Kreyl/Libs/Kicad/3d/Batteries/CR2032 holder.step

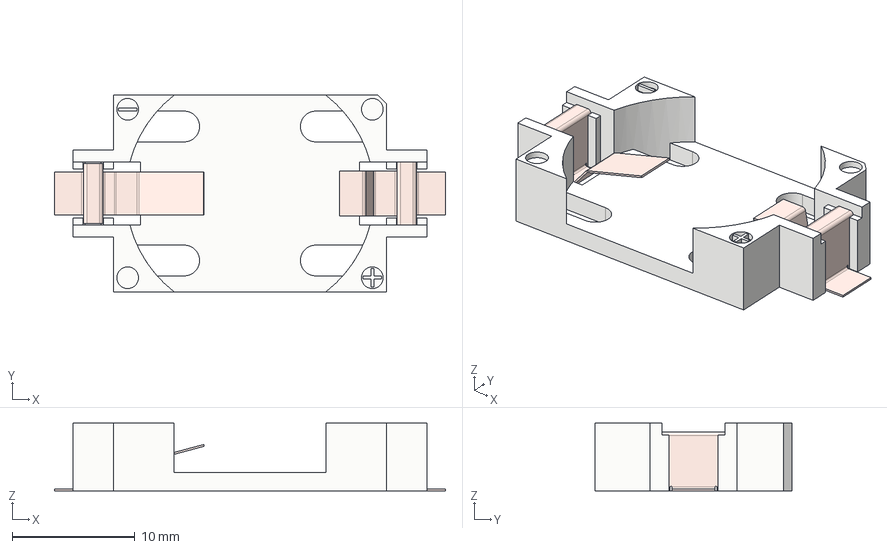
[picture p1: CAD file, 2018-12-30]
Kicad/3d/Batteries/CR2032 holder.step
31.8 x 16.0 x 5.50 mm
base
connector_plus
connector_minus
