Kreyl/Libs/Kicad/3d/BGA/153BallWFBGA.step

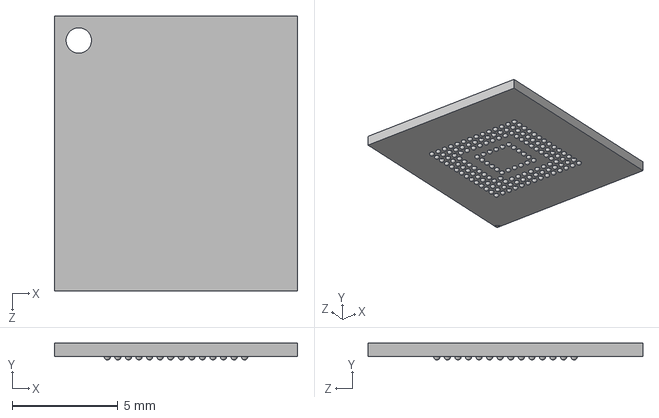
[picture p2: CAD file, 2021-06-26]
Kicad/3d/BGA/153BallWFBGA.step
11.5 x 0.802 x 13.0 mm
