Kreyl/Libs/Kicad/3d/BtnsSwitches/ESP2010.STEP

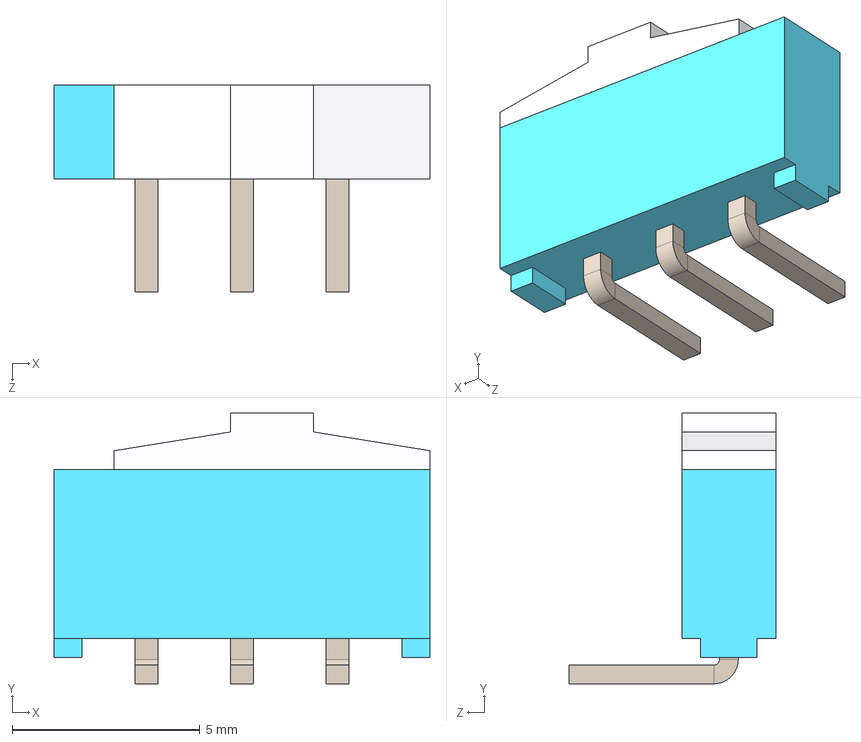
[picture p3: CAD file, 2024-11-15]
Kicad/3d/BtnsSwitches/ESP2010.STEP
10.0 x 7.20 x 5.50 mm
