Kreyl/Libs/Kicad/3d/Capacitors/CAPSMD_D8H10.STEP

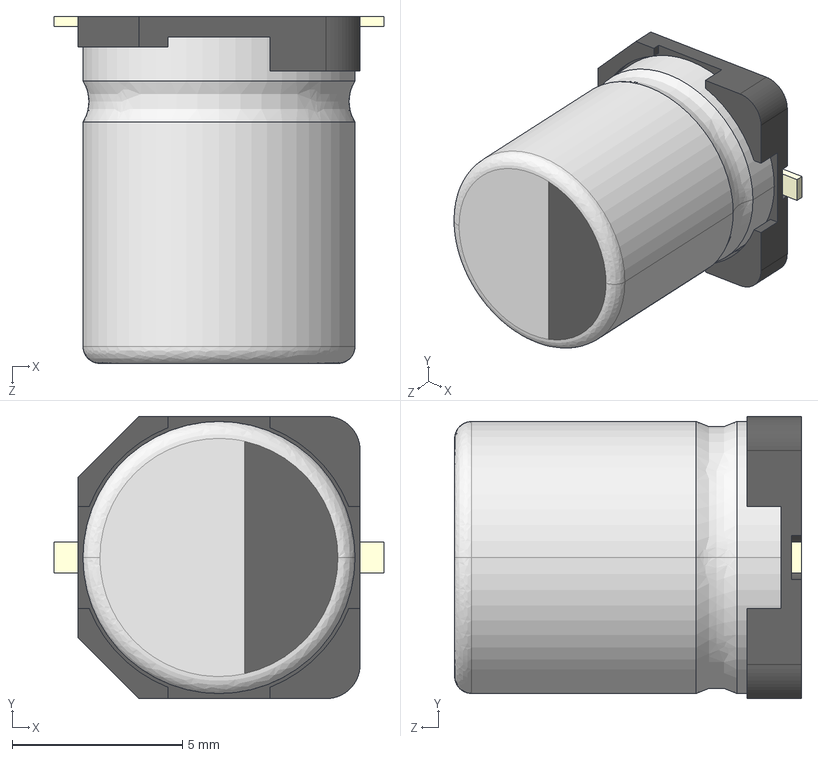
[picture p4: CAD file, 2024-05-12]
Kicad/3d/Capacitors/CAPSMD_D8H10.STEP
9.70 x 8.30 x 10.2 mm
