Kreyl/Libs/Kicad/3d/Connectors/IDC/DS1013-10S (IDC-10MS CONNFLY).step

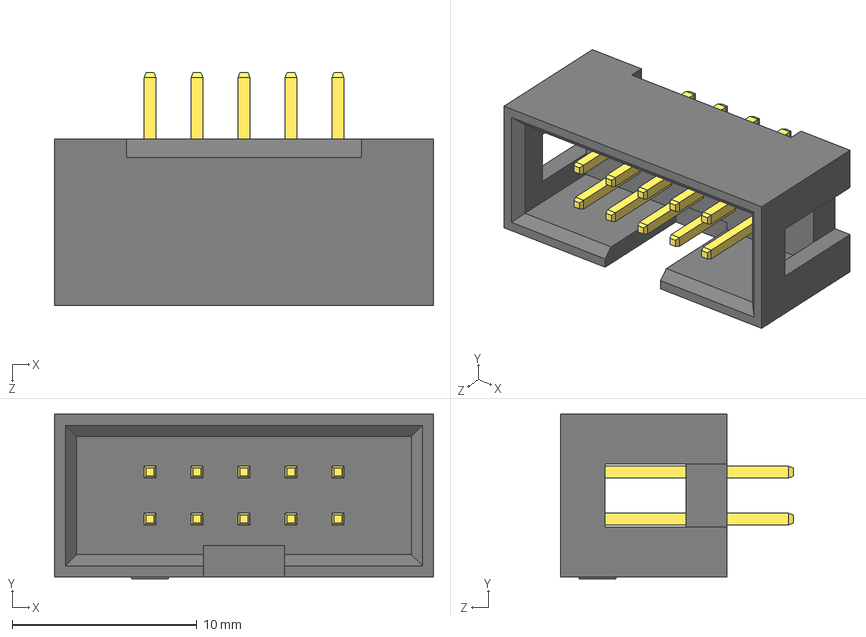
[picture p5: CAD file, 2019-09-05]
Kicad/3d/Connectors/IDC/DS1013-10S (IDC-10MS CONNFLY).step
20.5 x 8.90 x 12.6 mm
