Kreyl/Libs/Kicad/3d/Connectors/Minifit_6R.STEP

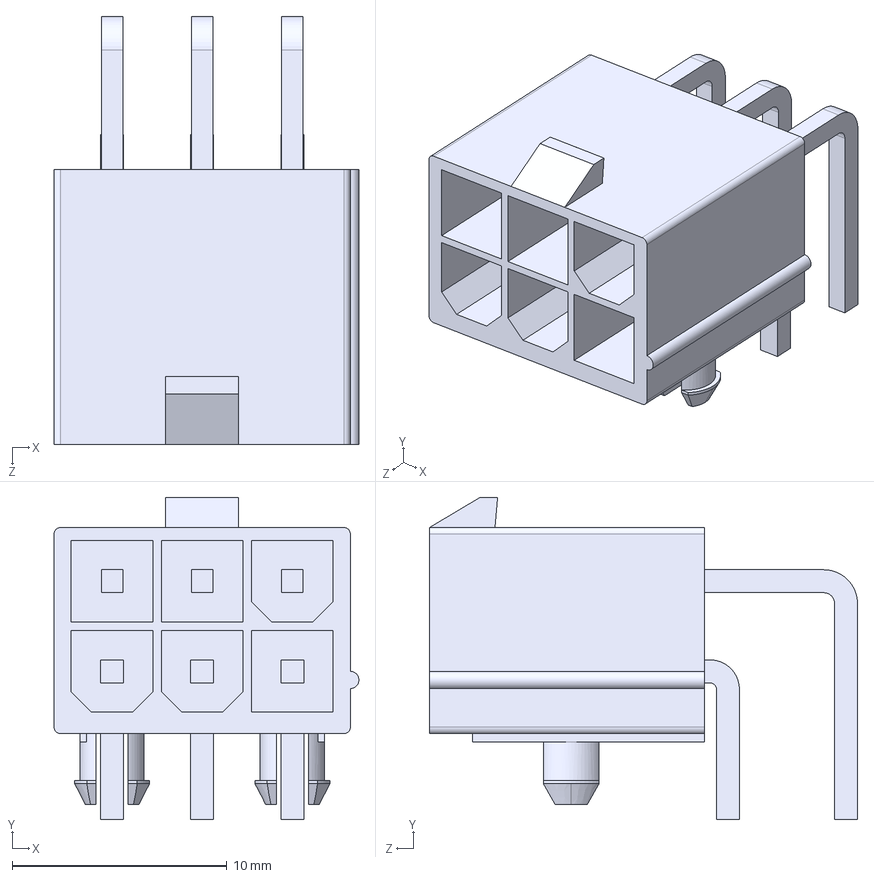
[picture p6: CAD file, 2025-05-01]
Kicad/3d/Connectors/Minifit_6R.STEP
14.2 x 15.0 x 19.9 mm
