Kreyl/Libs/Kicad/3d/Connectors/TermBlock/TermBlock_x2_Vert_508.STEP

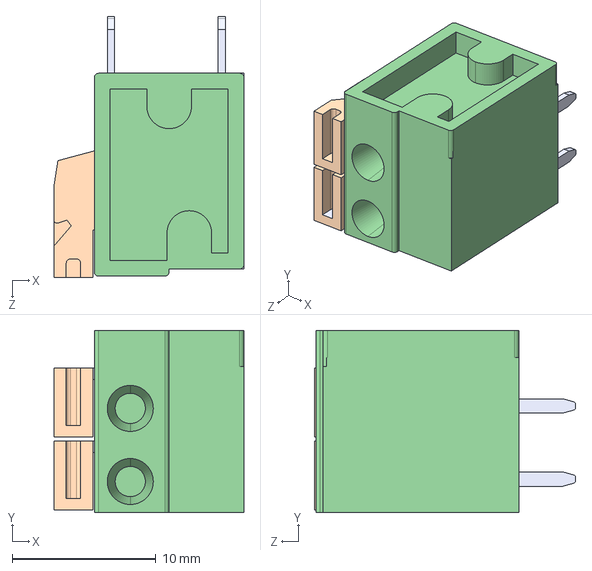
[picture p7: CAD file, 2020-02-28]
Kicad/3d/Connectors/TermBlock/TermBlock_x2_Vert_508.STEP
13.2 x 12.7 x 18.2 mm
