Kreyl/Libs/Kicad/3d/Diodes/PowerDI5.STEP

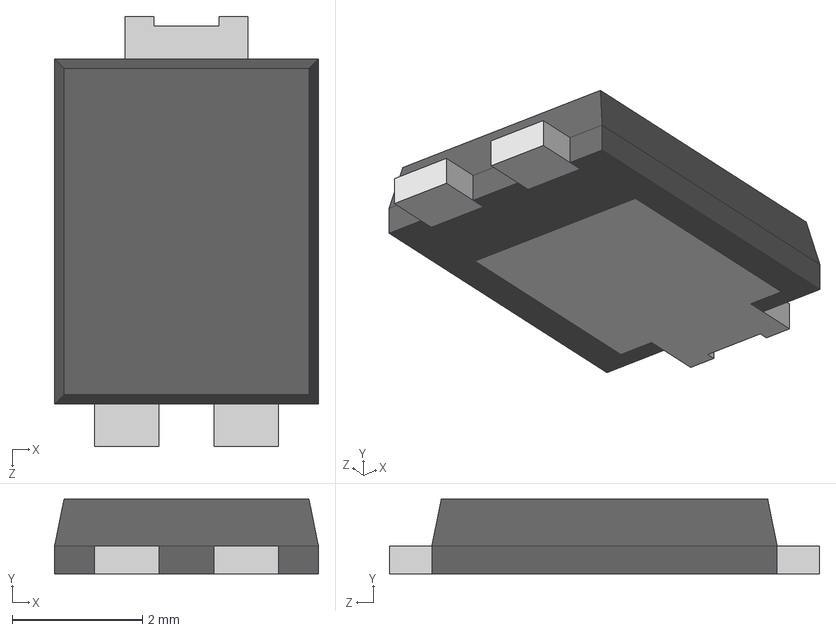
[picture p8: CAD file, 2021-07-17]
Kicad/3d/Diodes/PowerDI5.STEP
4.05 x 1.15 x 6.60 mm
