Kreyl/Libs/Kicad/3d/DIP/DIP16.STEP

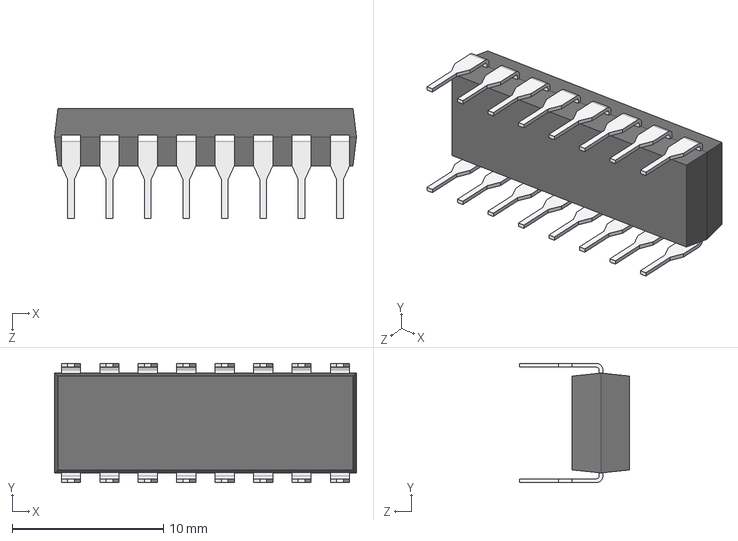
[picture p9: CAD file, 2018-04-20]
Kicad/3d/DIP/DIP16.STEP
20.0 x 7.87 x 7.30 mm
