Kreyl/Libs/Kicad/3d/Display/King Bright CA56-11.step

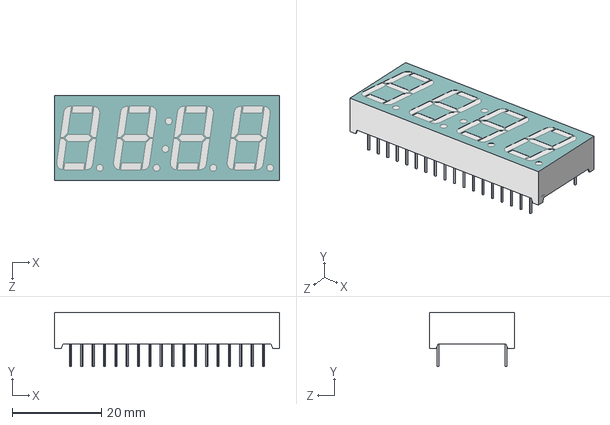
[picture p10: CAD file, 2019-11-08]
Kicad/3d/Display/King Bright CA56-11.step
50.3 x 12.1 x 19.0 mm
