Kreyl/Libs/Kicad/3d/Inductors/L0605.step

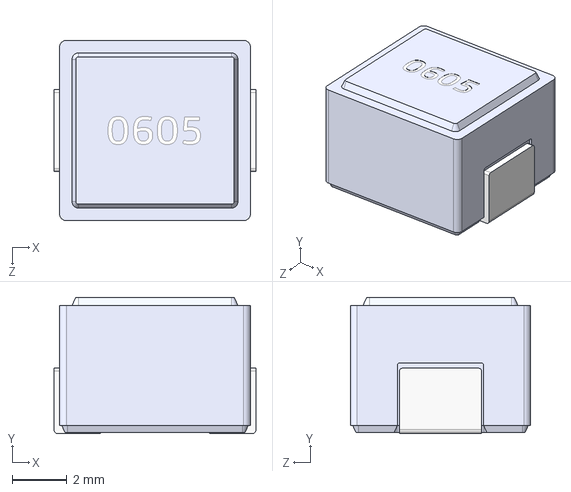
[picture p11: CAD file, 2025-05-01]
Kicad/3d/Inductors/L0605.step
7.40 x 5.00 x 6.60 mm
