Kreyl/Libs/Kicad/3d/Installation/CardInFix.STEP

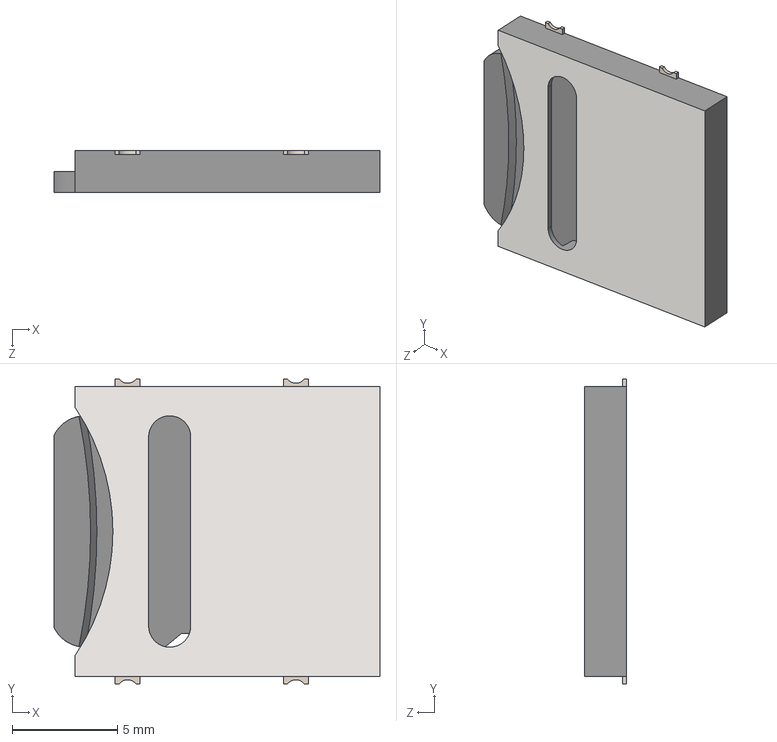
[picture p12: CAD file, 2024-11-16]
Kicad/3d/Installation/CardInFix.STEP
15.5 x 14.5 x 2.00 mm
SD holder fix
microsd card
