Kreyl/Libs/Kicad/3d/LED/LED2835_h08.STEP

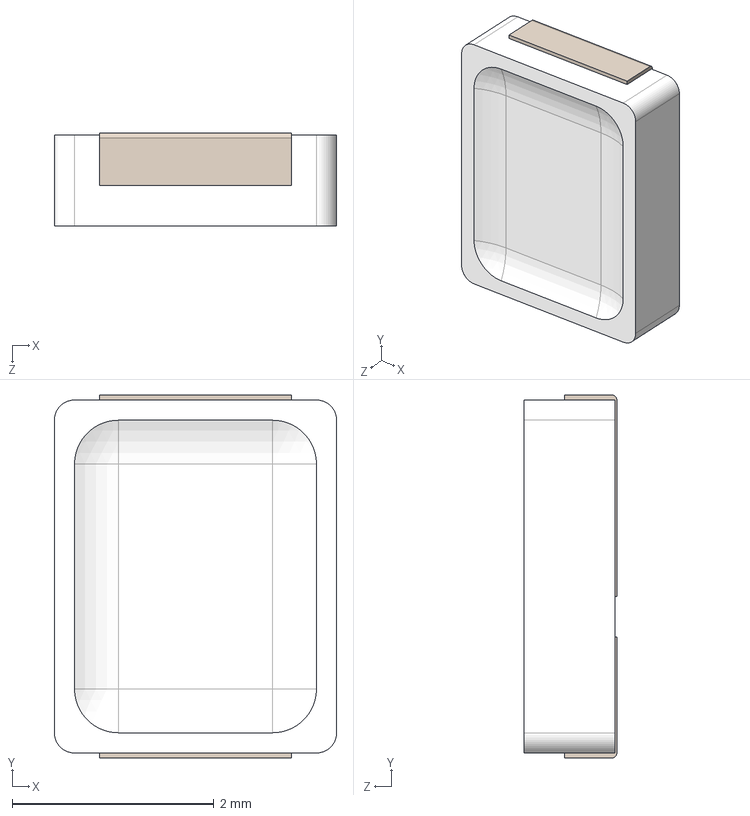
[picture p13: CAD file, 2023-07-15]
Kicad/3d/LED/LED2835_h08.STEP
2.80 x 3.60 x 0.92 mm
