Kreyl/Libs/Kicad/3d/LGA/LGA12-2x2x0_9.step

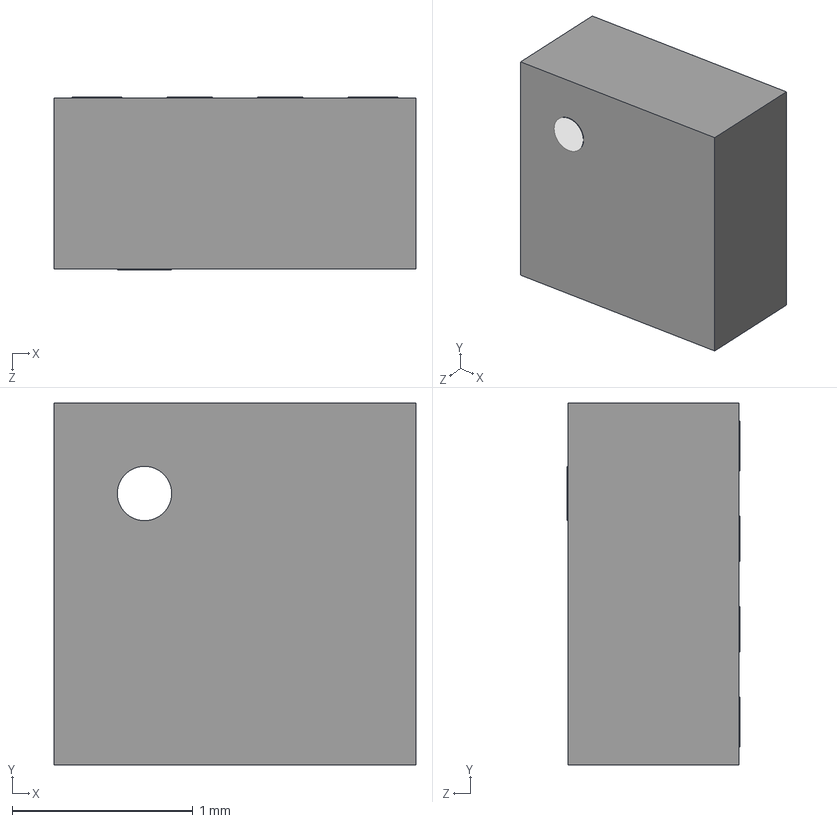
[picture p14: CAD file, 2024-11-16]
Kicad/3d/LGA/LGA12-2x2x0_9.step
2.00 x 2.00 x 0.955 mm
