Kreyl/Libs/Kicad/3d/Microphones/SPM211.STEP

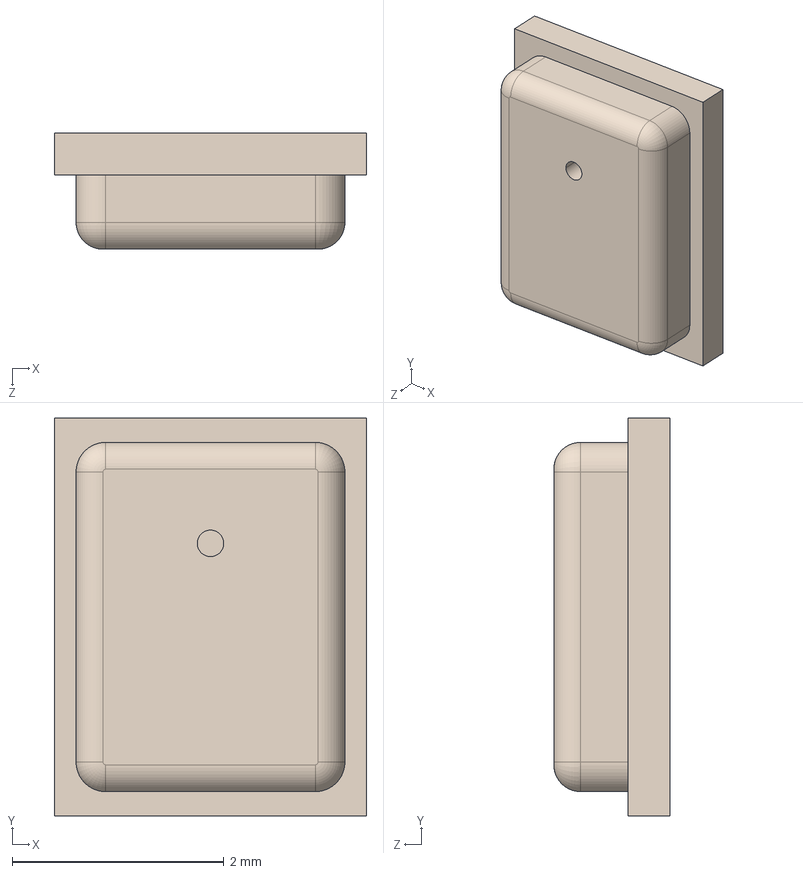
[picture p15: CAD file, 2020-12-03]
Kicad/3d/Microphones/SPM211.STEP
2.95 x 3.76 x 1.10 mm
