Kreyl/Libs/Kicad/3d/Modules/JDY-31.stp

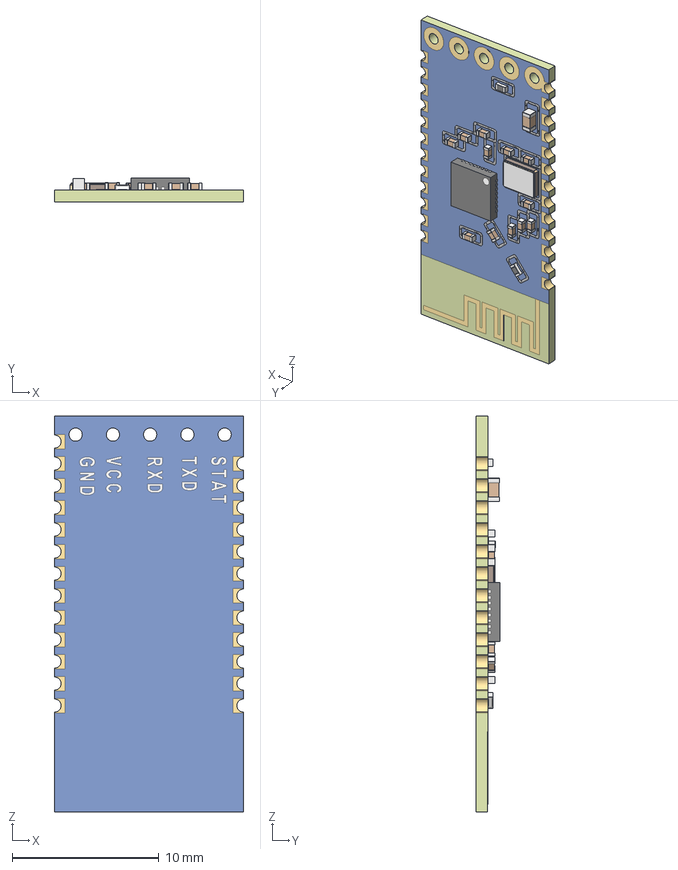
[picture p16: CAD file, 2024-11-07]
Kicad/3d/Modules/JDY-31.stp
12.9 x 1.66 x 27.0 mm
3D.000.000.000
CNC.000.000.000
