Kreyl/Libs/Kicad/3d/PCB/Testpoint1d5.STEP

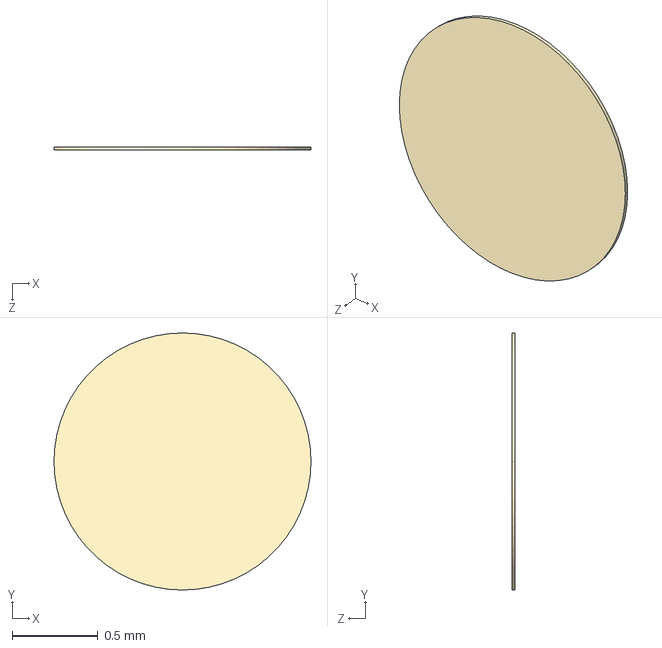
[picture p17: CAD file, 2020-05-17]
Kicad/3d/PCB/Testpoint1d5.STEP
1.50 x 1.50 x 0.02 mm
