Kreyl/Libs/Kicad/3d/QFN_DFN/POWERPAK 1212-8SWLH.STEP

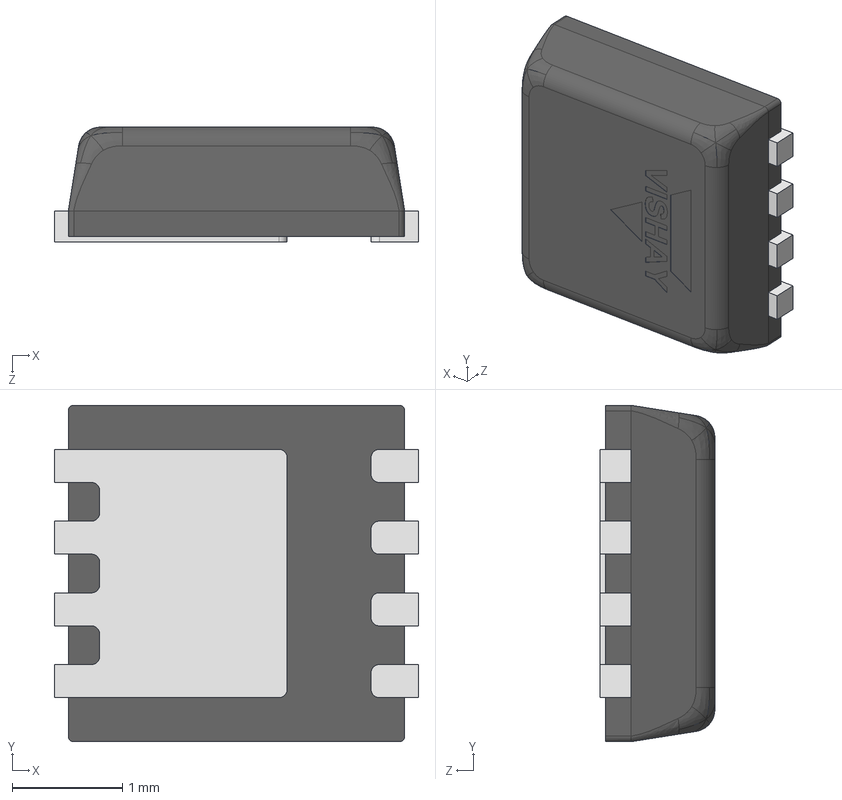
[picture p18: CAD file, 2021-06-26]
Kicad/3d/QFN_DFN/POWERPAK 1212-8SWLH.STEP
3.30 x 3.05 x 1.04 mm
Boss-Extrude2
Boss-Extrude3
Boss-Extrude6
Boss-Extrude5
Imported3
