Kreyl/Libs/Kicad/3d/QFP/LQFP-100.stp

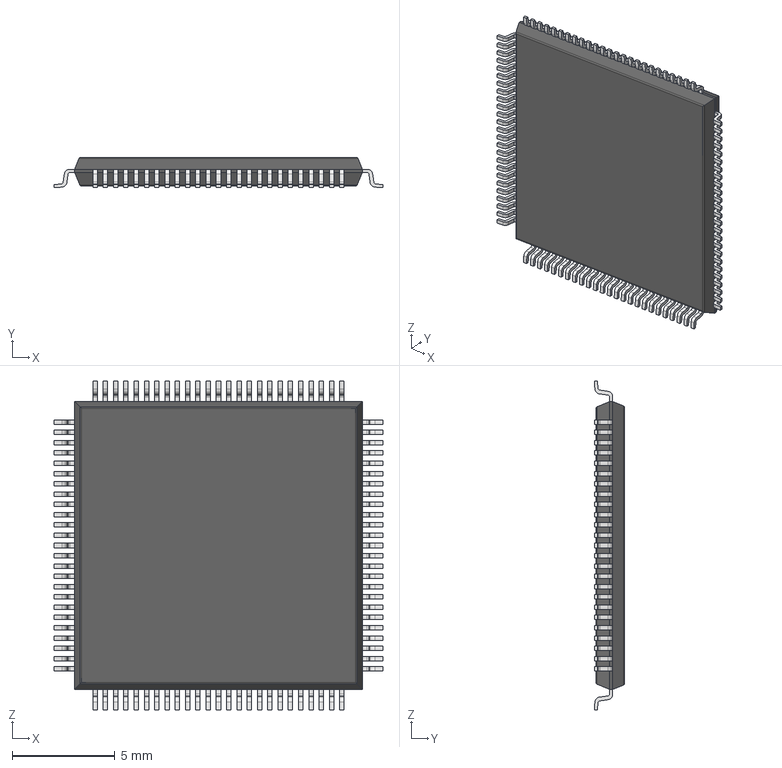
[picture p19: CAD file, 2024-11-15]
Kicad/3d/QFP/LQFP-100.stp
16.0 x 1.48 x 16.0 mm
