Kreyl/Libs/Kicad/3d/Quartz/HC49_US.step

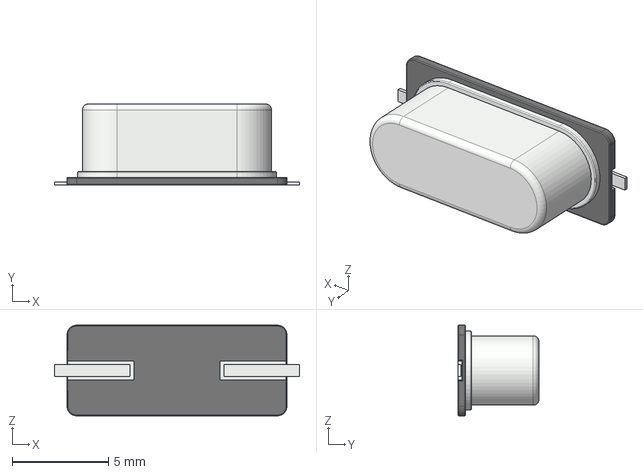
[picture p20: CAD file, 2018-02-26]
Kicad/3d/Quartz/HC49_US.step
12.7 x 4.20 x 4.70 mm
