Kreyl/Libs/Kicad/3d/Resistors/R_2512.step

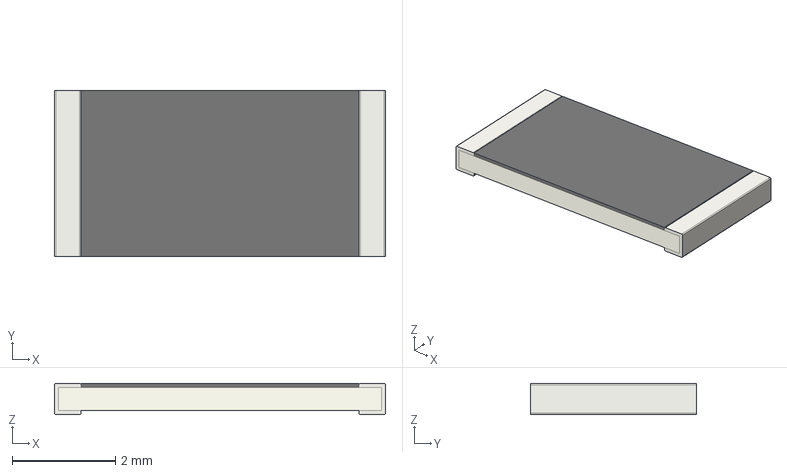
[picture p21: CAD file, 2018-02-26]
Kicad/3d/Resistors/R_2512.step
6.40 x 3.20 x 0.6 mm
