Kreyl/Libs/Kicad/3d/SO_DIL_TSSOP/SO8_208mil.step

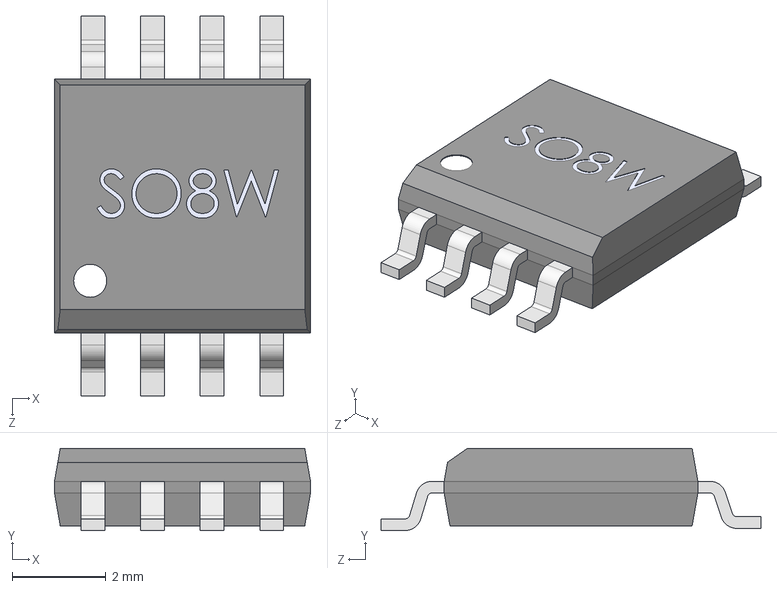
[picture p22: CAD file, 2023-10-30]
Kicad/3d/SO_DIL_TSSOP/SO8_208mil.step
5.46 x 1.75 x 8.10 mm
