Kreyl/Libs/Kicad/3d/SOT/SC-70_SOT-363.stp

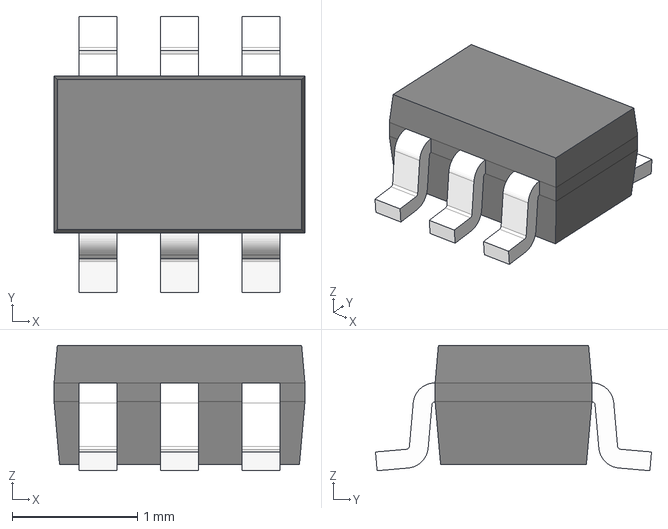
[picture p23: CAD file, 2024-11-16]
Kicad/3d/SOT/SC-70_SOT-363.stp
2.00 x 2.20 x 1.00 mm
