Kreyl/Libs/Kicad/3d/Batteries/BatHolder 3xAA.STEP

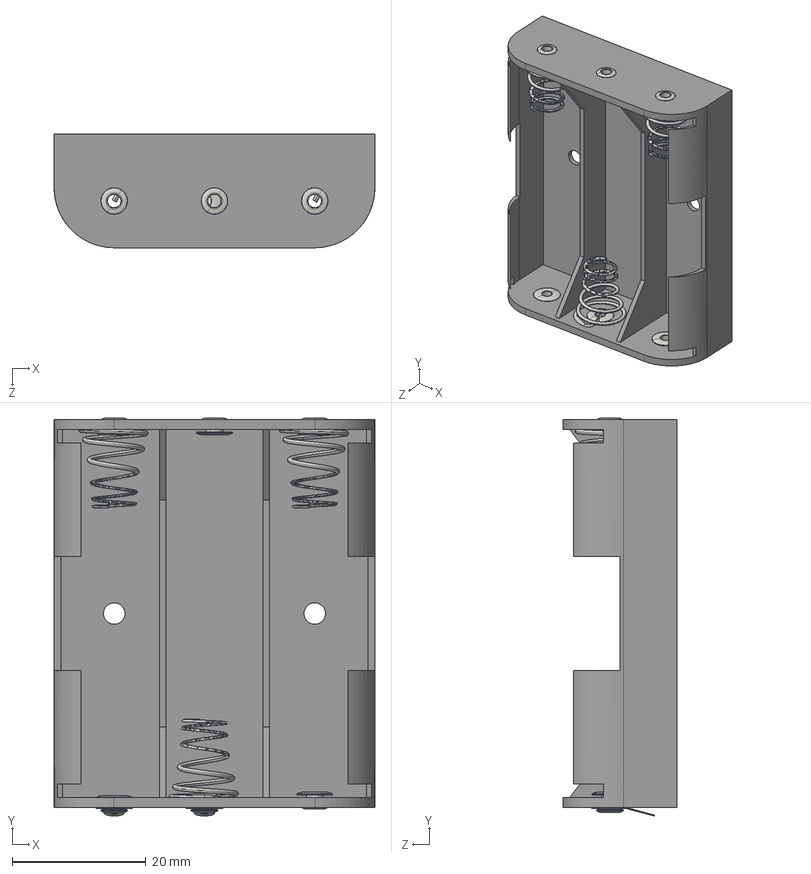
[picture p24: CAD file, 2018-12-12]
Kicad/3d/Batteries/BatHolder 3xAA.STEP
48.0 x 59.5 x 17.0 mm
BatteryHolder 3xAA Case
