Kreyl/Libs/Kicad/3d/BGA/BGA15x15.STEP

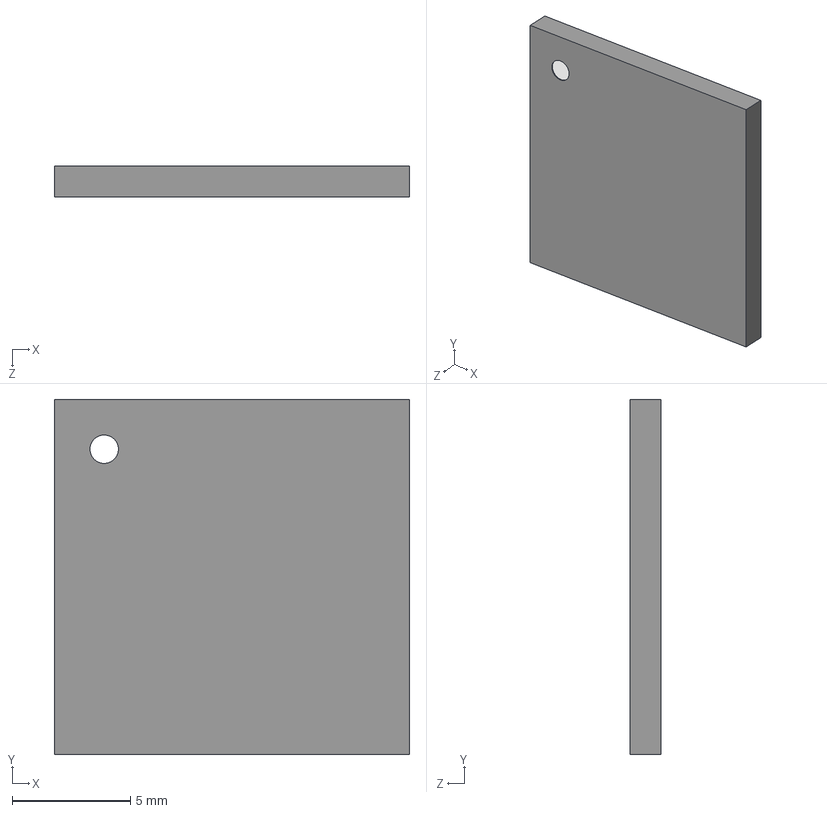
[picture p25: CAD file, 2020-09-16]
Kicad/3d/BGA/BGA15x15.STEP
15.0 x 15.0 x 1.30 mm
