Kreyl/Libs/Kicad/3d/BtnsSwitches/Btn 3x4.STEP

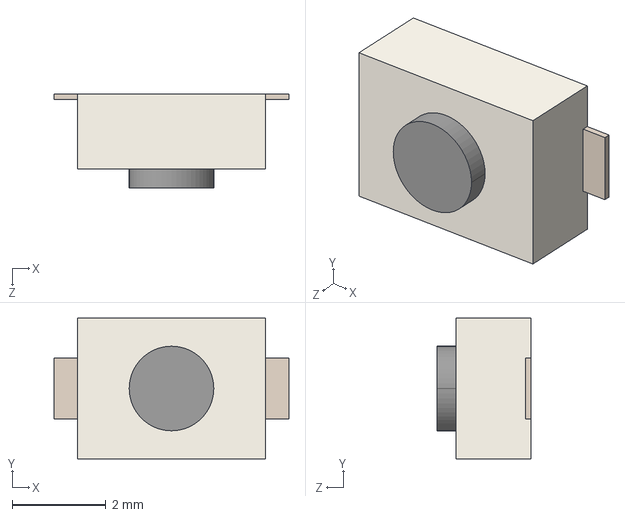
[picture p26: CAD file, 2024-08-31]
Kicad/3d/BtnsSwitches/Btn 3x4.STEP
5.00 x 3.00 x 2.00 mm
