Kreyl/Libs/Kicad/3d/Capacitors/CAPSMD470-6.3.stp

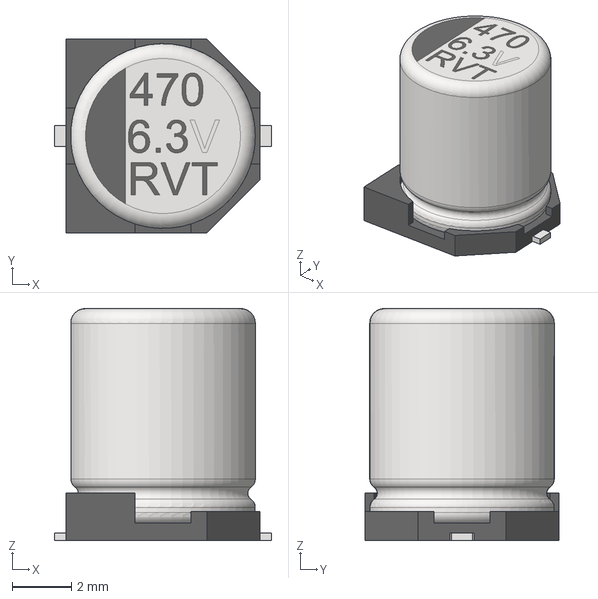
[picture p27: CAD file, 2019-02-19]
Kicad/3d/Capacitors/CAPSMD470-6.3.stp
7.35 x 6.57 x 7.85 mm
