Kreyl/Libs/Kicad/3d/Connectors/IDC/DS1013-30S (IDC-30MS CONNFLY).step

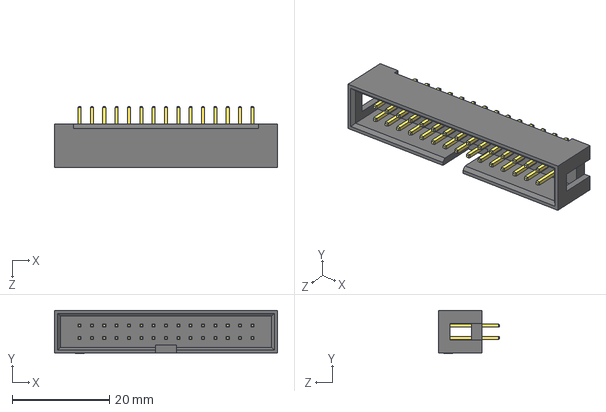
[picture p28: CAD file, 2019-01-16]
Kicad/3d/Connectors/IDC/DS1013-30S (IDC-30MS CONNFLY).step
45.9 x 8.90 x 12.6 mm
