Kreyl/Libs/Kicad/3d/Connectors/KLS1-3.96A-02-S.STEP

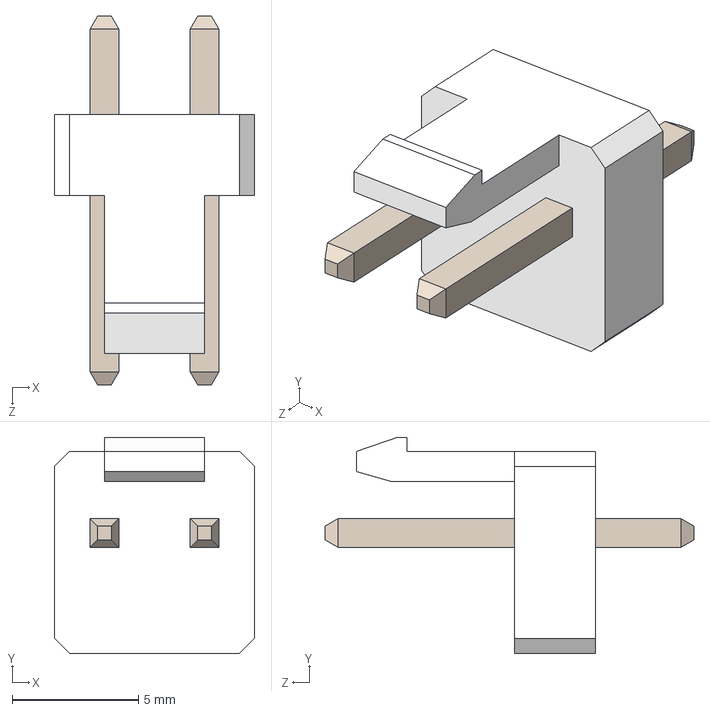
[picture p29: CAD file, 2024-11-16]
Kicad/3d/Connectors/KLS1-3.96A-02-S.STEP
7.92 x 8.55 x 14.6 mm
