Kreyl/Libs/Kicad/3d/Connectors/TermBlock/2way_5mm_R.stp

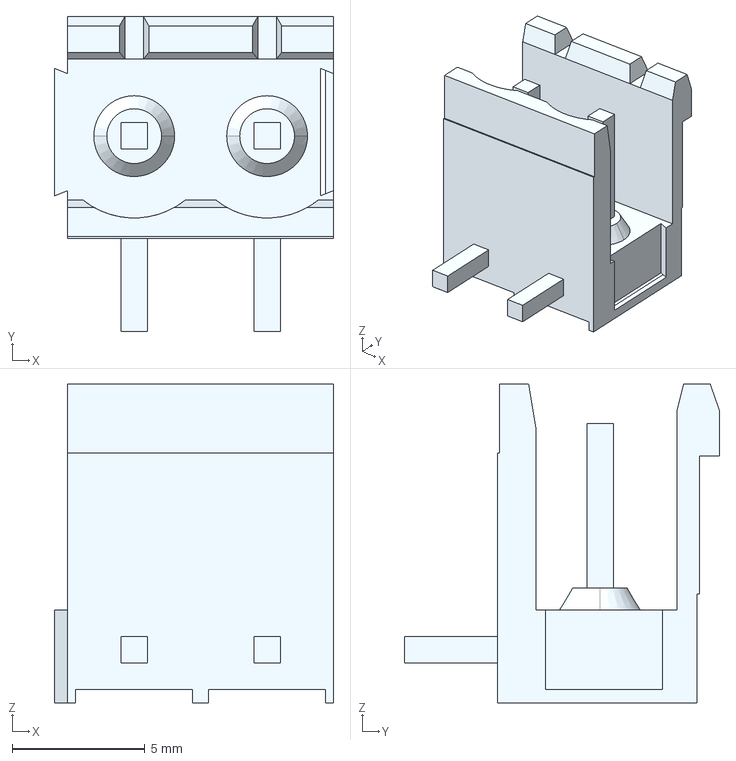
[picture p30: CAD file, 2019-11-08]
Kicad/3d/Connectors/TermBlock/2way_5mm_R.stp
10.5 x 11.8 x 12.0 mm
