Kreyl/Libs/Kicad/3d/Diodes/DFN1006_2L.STEP

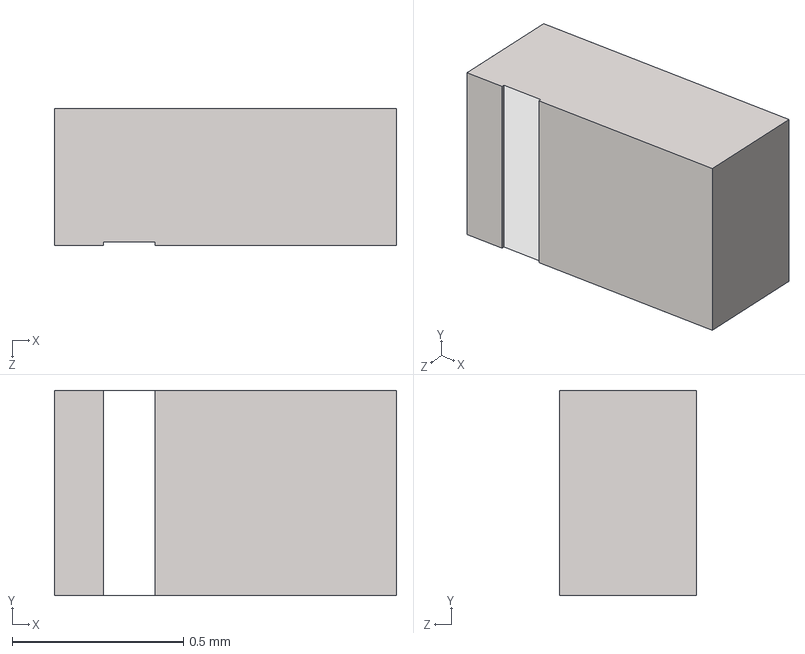
[picture p31: CAD file, 2020-02-28]
Kicad/3d/Diodes/DFN1006_2L.STEP
1.00 x 0.6 x 0.4 mm
