Kreyl/Libs/Kicad/3d/DIP/DIP4.STEP

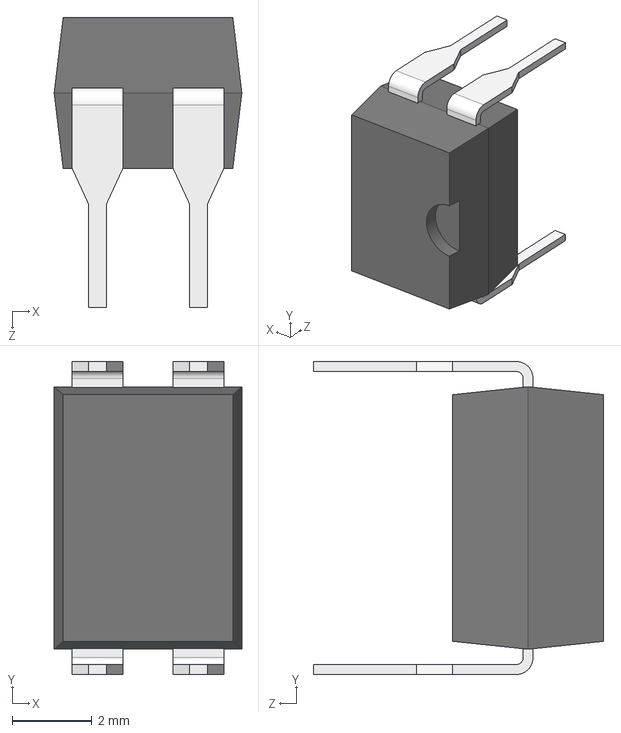
[picture p32: CAD file, 2018-04-20]
Kicad/3d/DIP/DIP4.STEP
4.72 x 7.87 x 7.30 mm
