Kreyl/Libs/Kicad/3d/Inductors/L_SPM6530.STEP

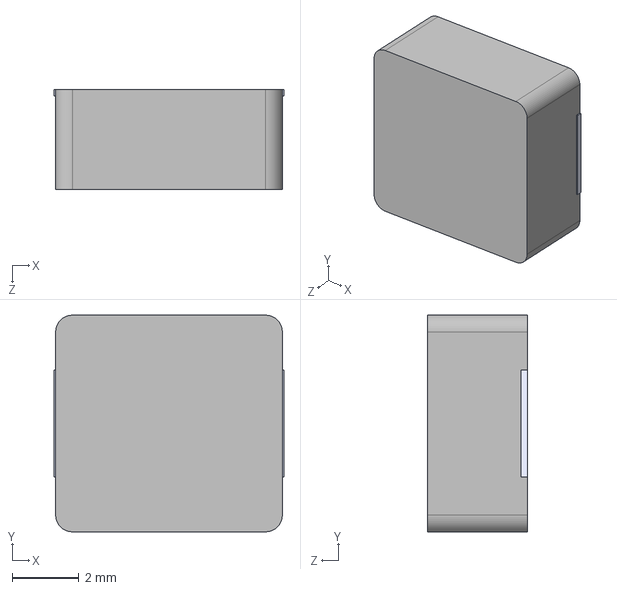
[picture p33: CAD file, 2025-05-01]
Kicad/3d/Inductors/L_SPM6530.STEP
6.90 x 6.50 x 3.00 mm
