Kreyl/Libs/Kicad/3d/Installation/BuzzerIPhone8.STEP

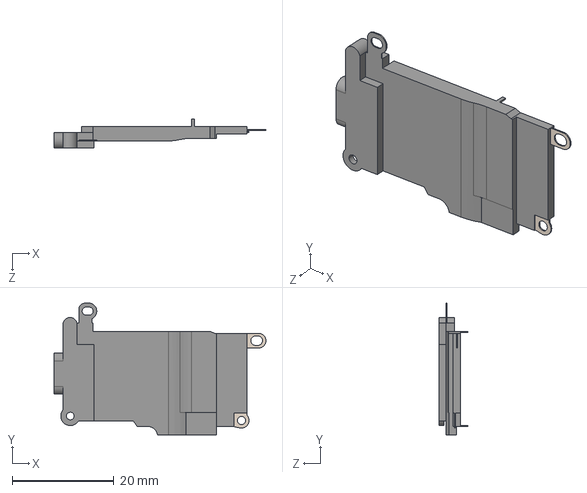
[picture p34: CAD file, 2024-11-15]
Kicad/3d/Installation/BuzzerIPhone8.STEP
41.6 x 25.8 x 5.70 mm
