Kreyl/Libs/Kicad/3d/LED/OT-15RGBWY.STEP

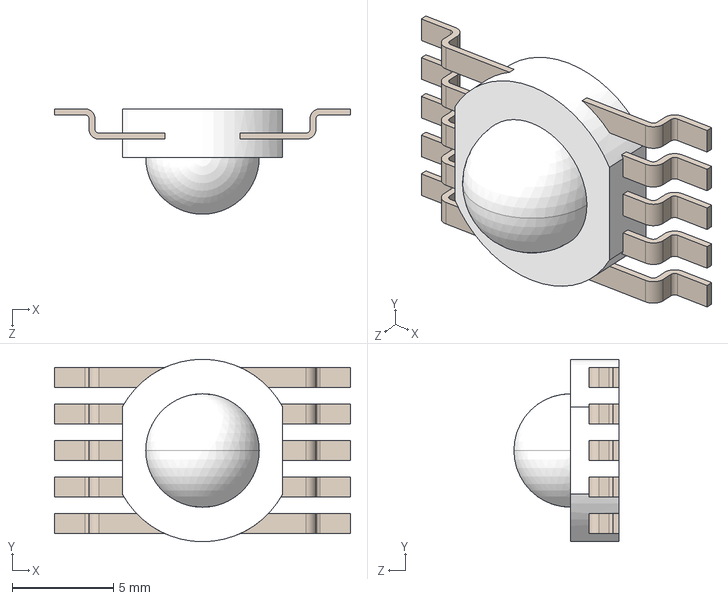
[picture p35: CAD file, 2023-04-04]
Kicad/3d/LED/OT-15RGBWY.STEP
14.6 x 9.00 x 5.20 mm
