Kreyl/Libs/Kicad/3d/Modules/AP6212.STEP

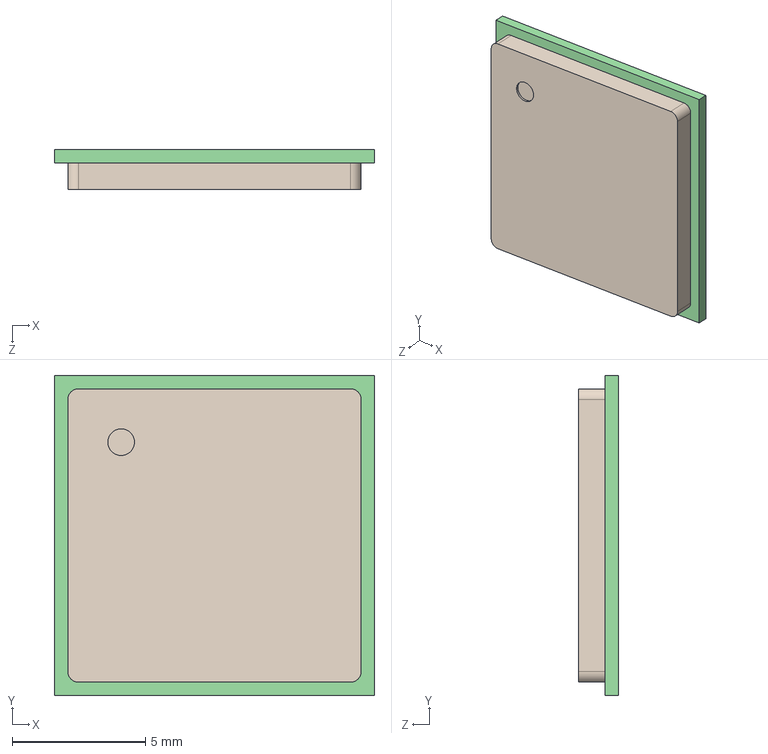
[picture p36: CAD file, 2022-04-08]
Kicad/3d/Modules/AP6212.STEP
12.0 x 12.0 x 1.50 mm
