Kreyl/Libs/Kicad/3d/QFN_DFN/X2QFN12.STEP

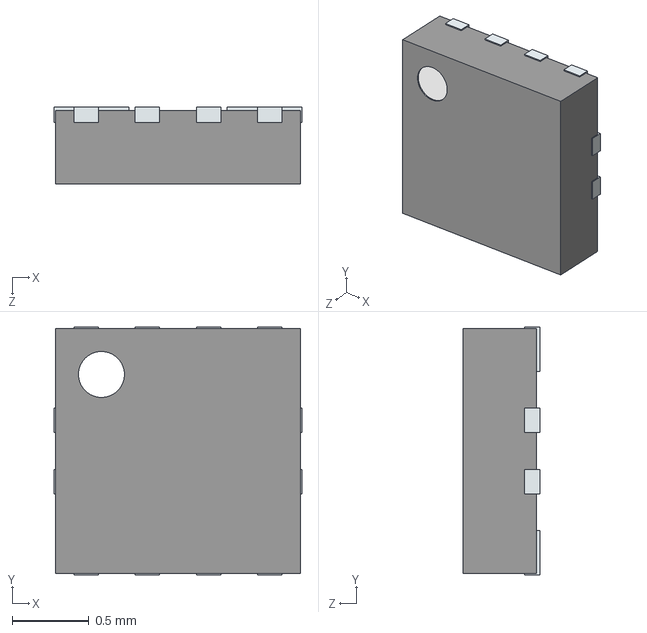
[picture p37: CAD file, 2021-01-27]
Kicad/3d/QFN_DFN/X2QFN12.STEP
1.62 x 1.62 x 0.5 mm
