Kreyl/Libs/Kicad/3d/Quartz/5032.step

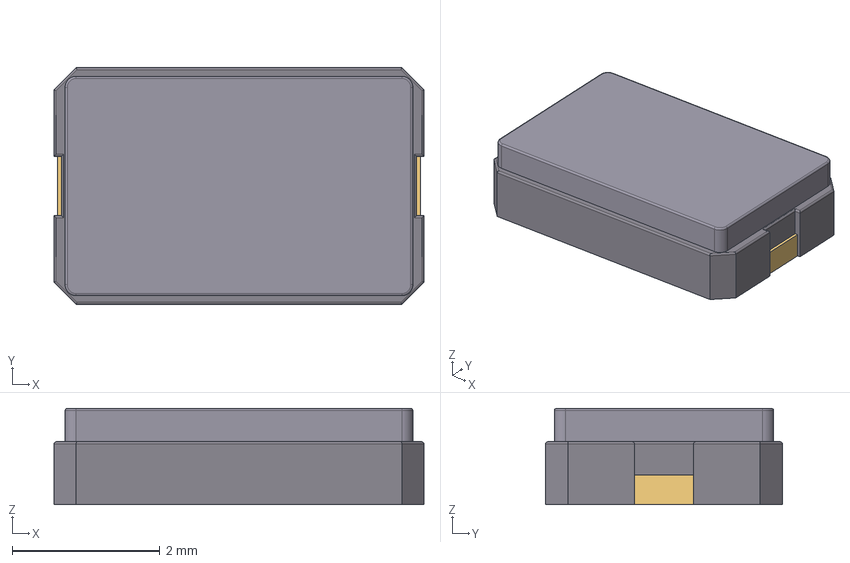
[picture p39: CAD file, 2018-02-26]
Kicad/3d/Quartz/5032.step
5.00 x 3.20 x 1.30 mm
