Kreyl/Libs/Kicad/3d/Resistors/R_2010.step

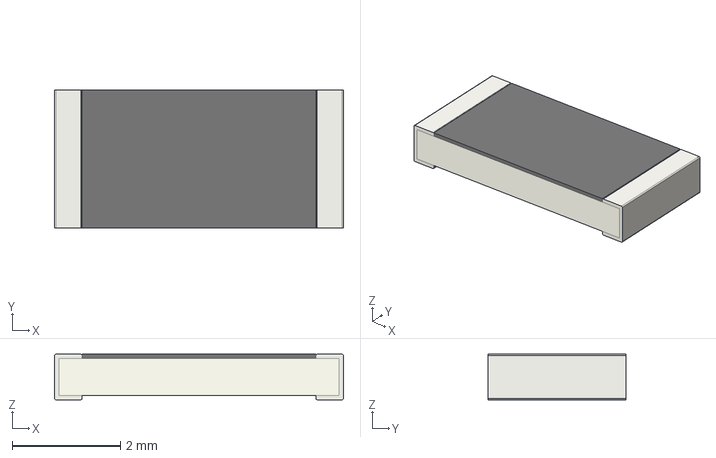
[picture p40: CAD file, 2018-02-26]
Kicad/3d/Resistors/R_2010.step
5.33 x 2.54 x 0.84 mm
