Kreyl/Libs/Kicad/3d/Sensors/KIT3032S.stp

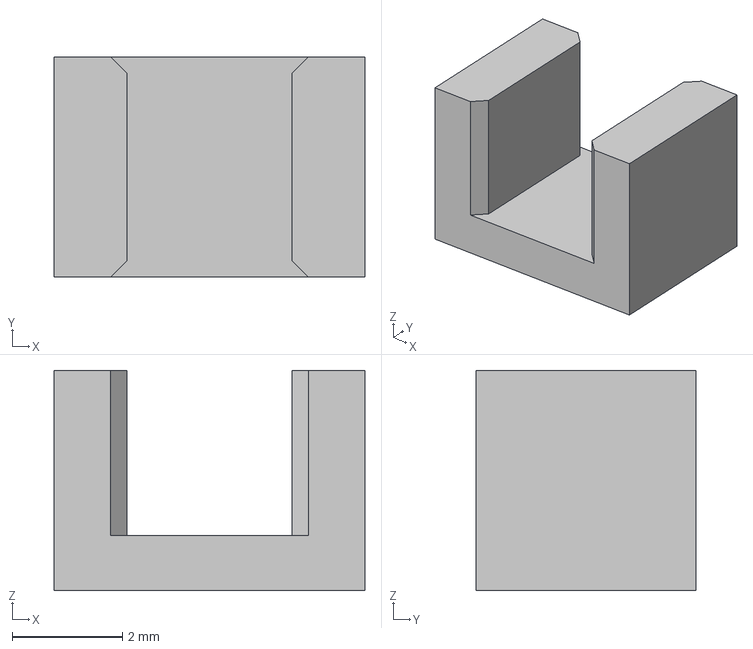
[picture p41: CAD file, 2019-06-02]
Kicad/3d/Sensors/KIT3032S.stp
5.65 x 4.00 x 4.00 mm
