Kreyl/Libs/Kicad/3d/SO_DIL_TSSOP/VSSOP8_0d5.step

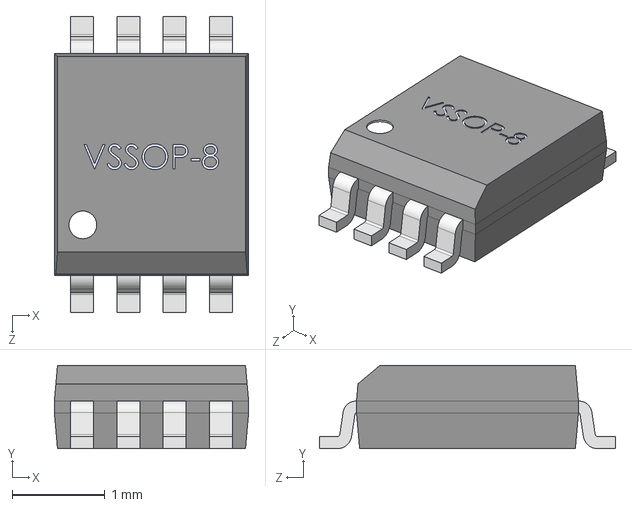
[picture p42: CAD file, 2020-02-28]
Kicad/3d/SO_DIL_TSSOP/VSSOP8_0d5.step
2.10 x 0.9 x 3.20 mm
