Kreyl/Libs/Kicad/3d/SOT/SOT89-5.step

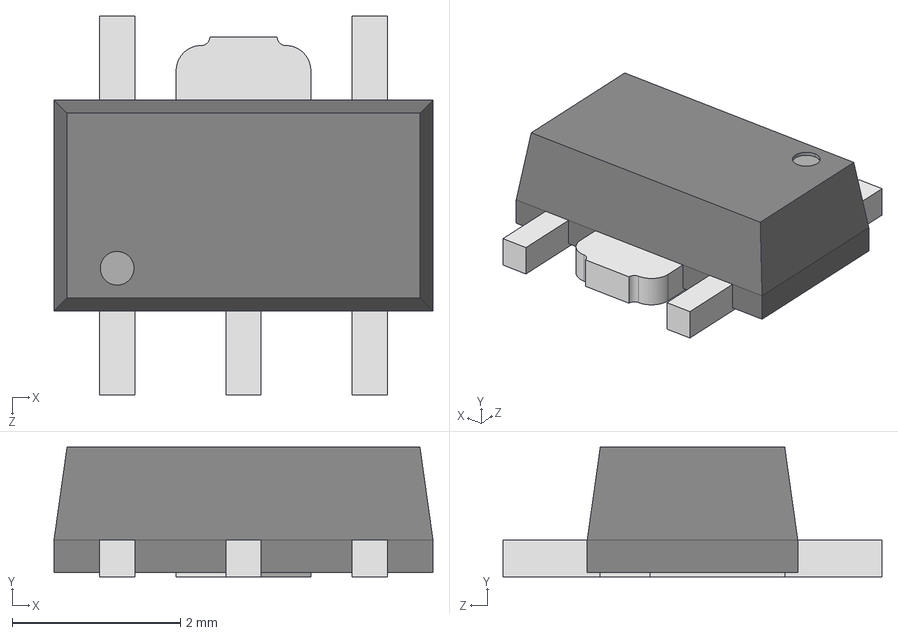
[picture p43: CAD file, 2019-09-05]
Kicad/3d/SOT/SOT89-5.step
4.50 x 1.54 x 4.50 mm
