Kreyl/Libs/Kicad/3d/Batteries/BatteryHolder 3x18650.STEP

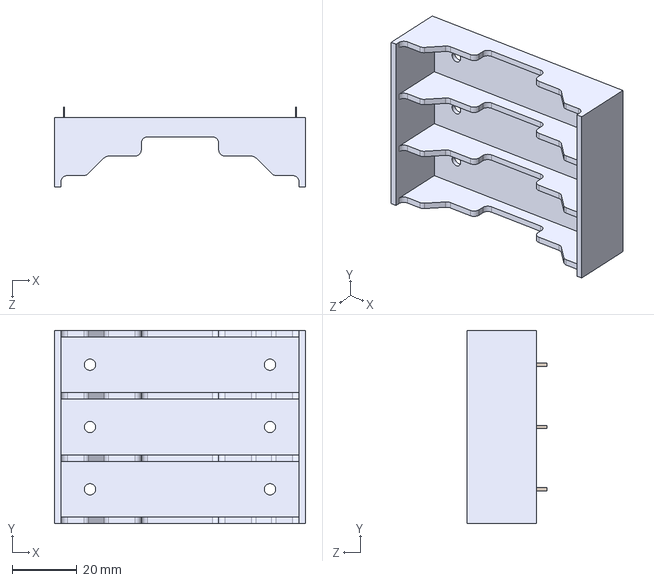
[picture p44: CAD file, 2018-02-26]
Kicad/3d/Batteries/BatteryHolder 3x18650.STEP
77.8 x 59.9 x 24.7 mm
