Kreyl/Libs/Kicad/3d/BtnsSwitches/Switch SS12S23.STEP

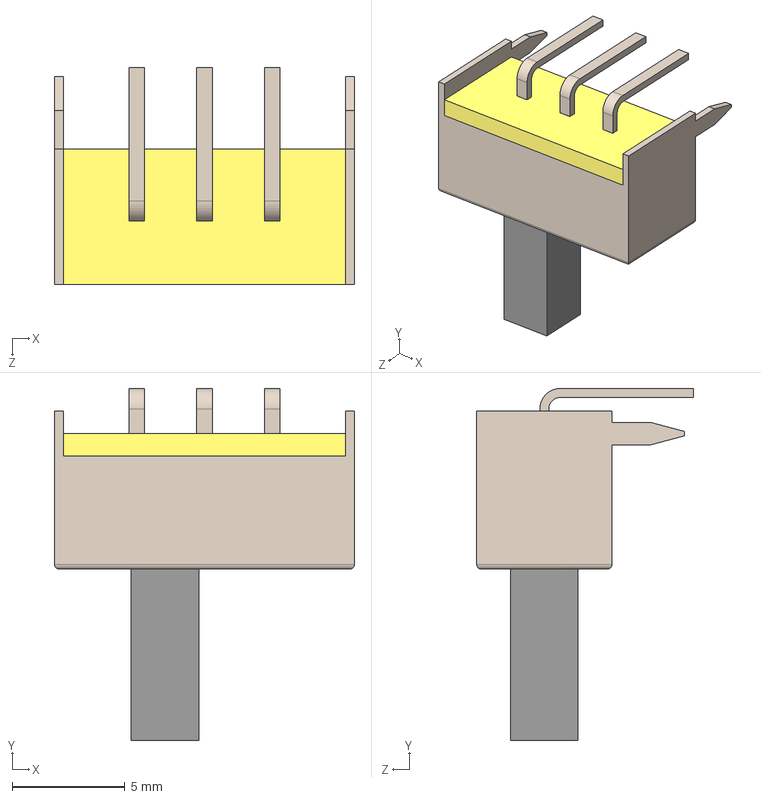
[picture p45: CAD file, 2023-07-15]
Kicad/3d/BtnsSwitches/Switch SS12S23.STEP
13.3 x 15.6 x 9.60 mm
