Kreyl/Libs/Kicad/3d/Capacitors/D8P3.5H11.5LD0.6.STEP

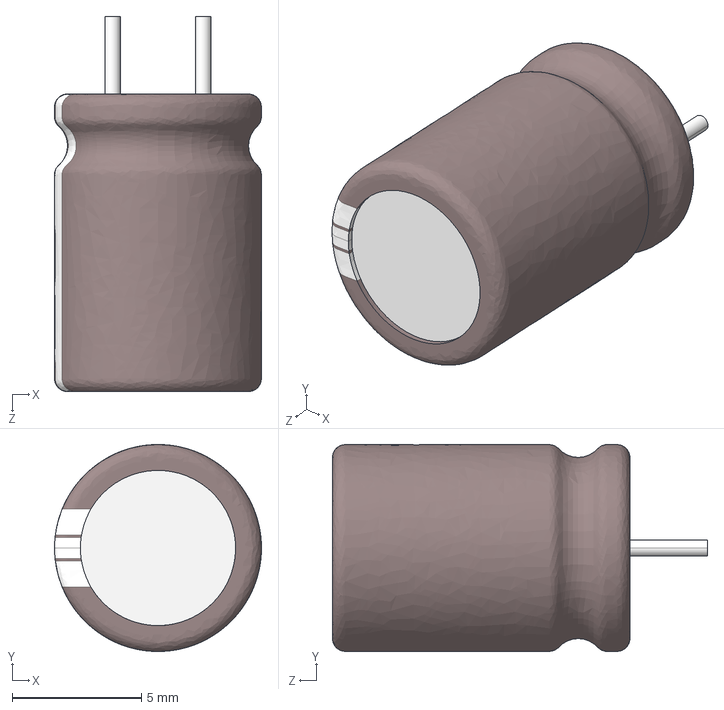
[picture p46: CAD file, 2018-12-12]
Kicad/3d/Capacitors/D8P3.5H11.5LD0.6.STEP
8.00 x 8.00 x 14.5 mm
