Kreyl/Libs/Kicad/3d/Connectors/IDC/DS1013-8S (IDC-8MS CONNFLY).stp

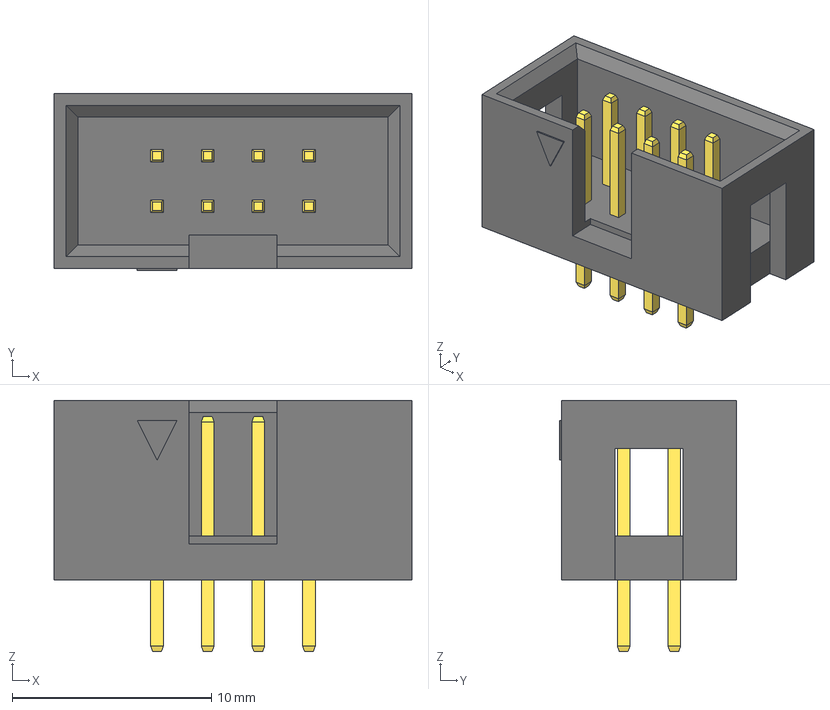
[picture p47: CAD file, 2019-01-16]
Kicad/3d/Connectors/IDC/DS1013-8S (IDC-8MS CONNFLY).stp
18.0 x 8.90 x 12.6 mm
