Kreyl/Libs/Kicad/3d/Connectors/USBC_L-KLS-5459.STEP

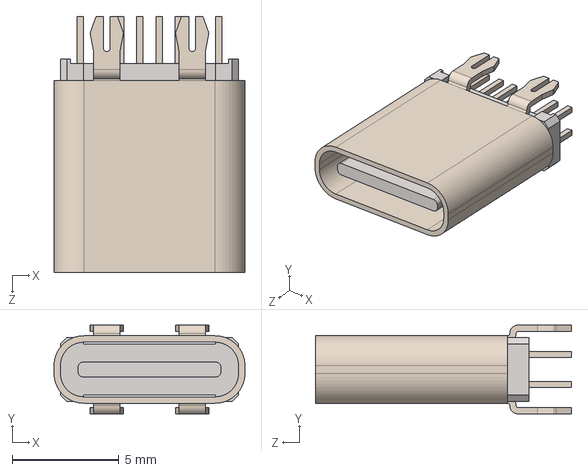
[picture p48: CAD file, 2024-11-14]
Kicad/3d/Connectors/USBC_L-KLS-5459.STEP
8.94 x 4.16 x 12.0 mm
