Kreyl/Libs/Kicad/3d/Diodes/SOD-80.step

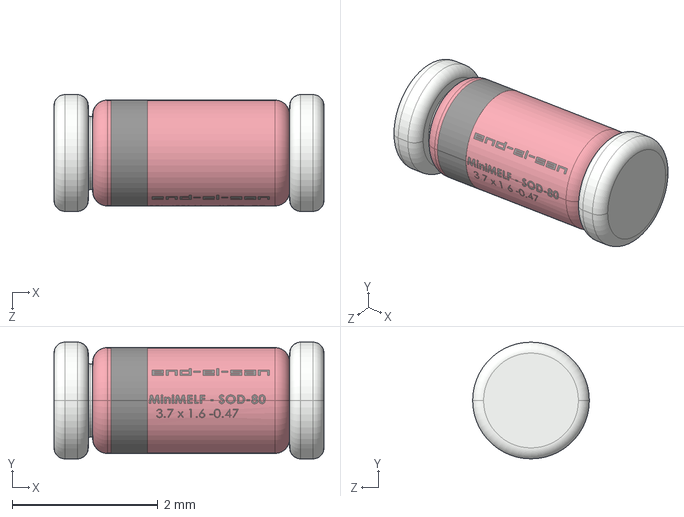
[picture p49: CAD file, 2019-11-08]
Kicad/3d/Diodes/SOD-80.step
3.70 x 1.60 x 1.60 mm
