Kreyl/Libs/Kicad/3d/DIP/DIP28.STEP

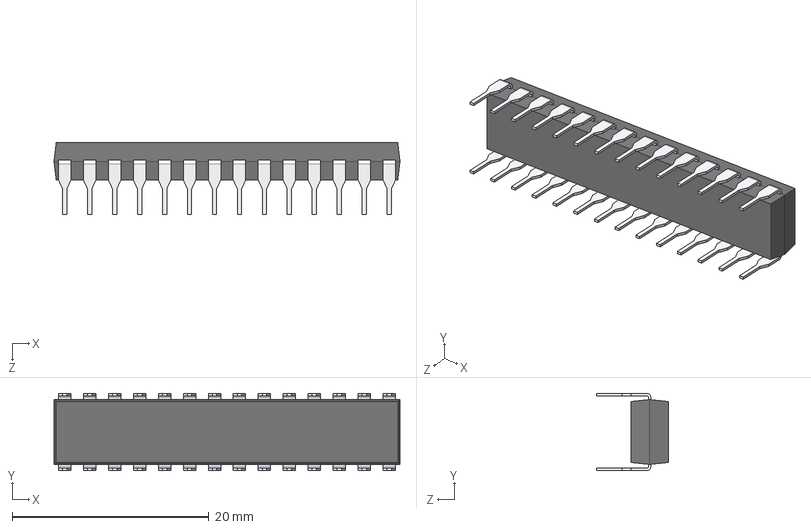
[picture p50: CAD file, 2018-04-20]
Kicad/3d/DIP/DIP28.STEP
35.2 x 7.87 x 7.30 mm
