Kreyl/Libs/Kicad/3d/Inductors/NR6028.step

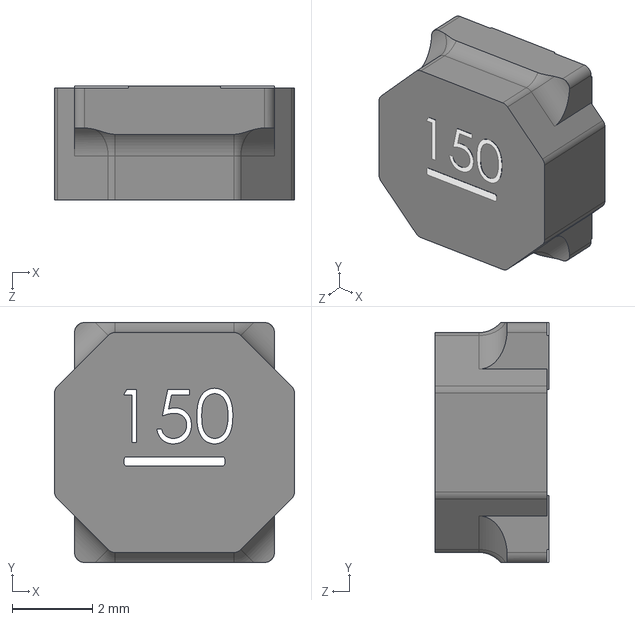
[picture p51: CAD file, 2023-04-04]
Kicad/3d/Inductors/NR6028.step
6.00 x 6.00 x 2.86 mm
