Kreyl/Libs/Kicad/3d/Installation/KL_BatteryHolder 1x18650.STEP

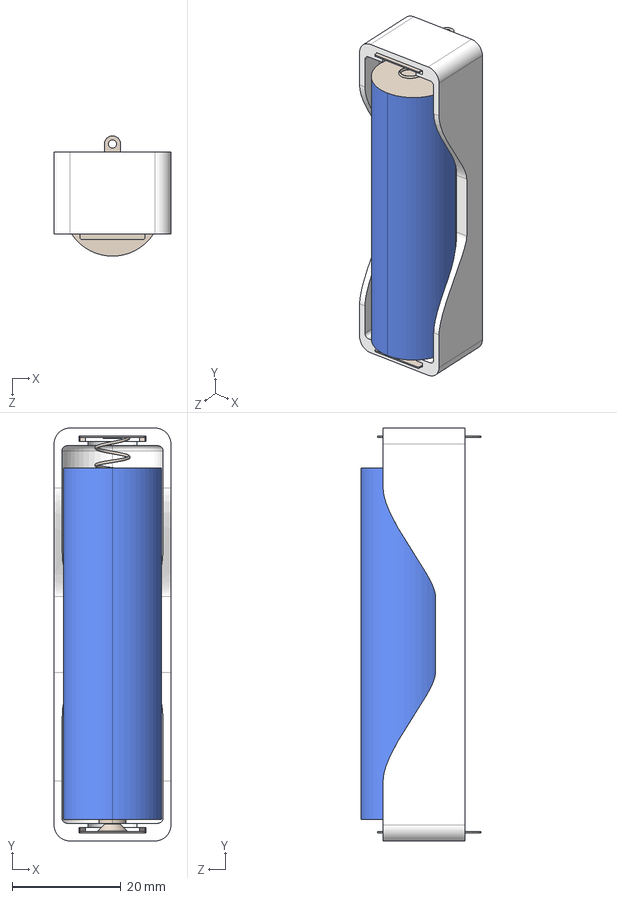
[picture p52: CAD file, 2023-04-04]
Kicad/3d/Installation/KL_BatteryHolder 1x18650.STEP
21.5 x 75.9 x 22.1 mm
Case18650x1
BatContactMinus12
BatContactPlus12
Battery 18650
