Kreyl/Libs/Kicad/3d/LED/WS2812_2020.STEP

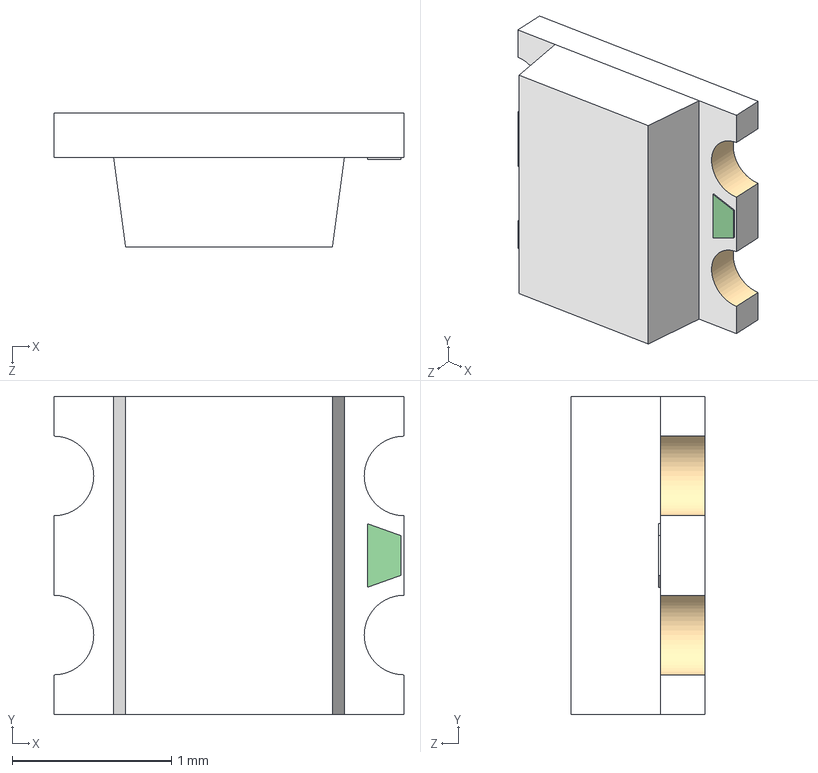
[picture p53: CAD file, 2022-07-02]
Kicad/3d/LED/WS2812_2020.STEP
2.20 x 2.00 x 0.84 mm
