Kreyl/Libs/Kicad/3d/Modules/BK8000L_F6188.STEP

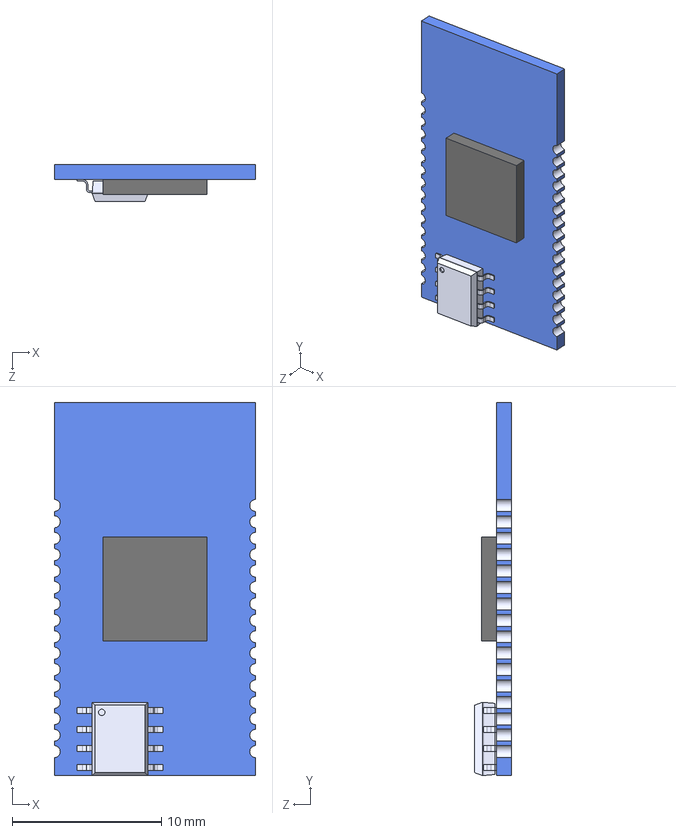
[picture p54: CAD file, 2020-12-03]
Kicad/3d/Modules/BK8000L_F6188.STEP
13.5 x 25.0 x 2.45 mm
