Kreyl/Libs/Kicad/3d/QFN_DFN/DRB8_3x3.STEP

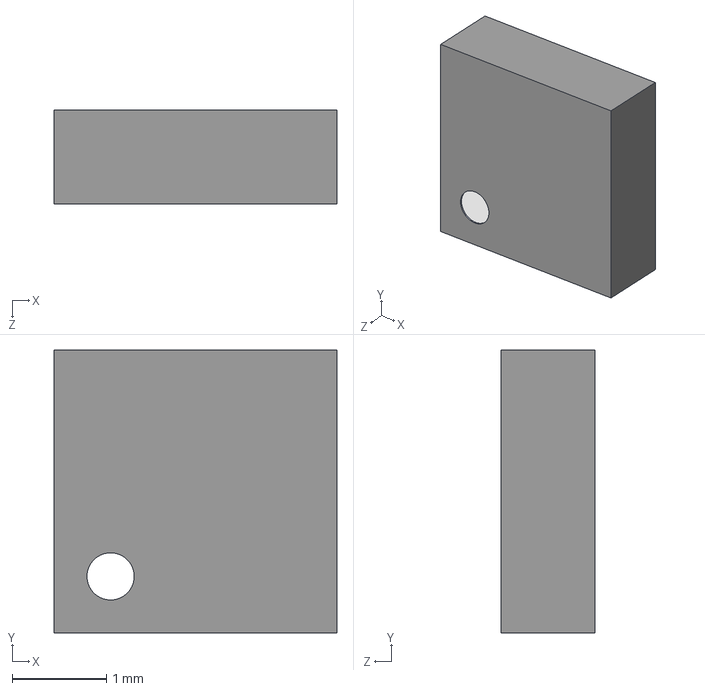
[picture p55: CAD file, 2020-12-03]
Kicad/3d/QFN_DFN/DRB8_3x3.STEP
3.00 x 3.00 x 1.00 mm
