Kreyl/Libs/Kicad/3d/QFP/TQFP32-0d8.step

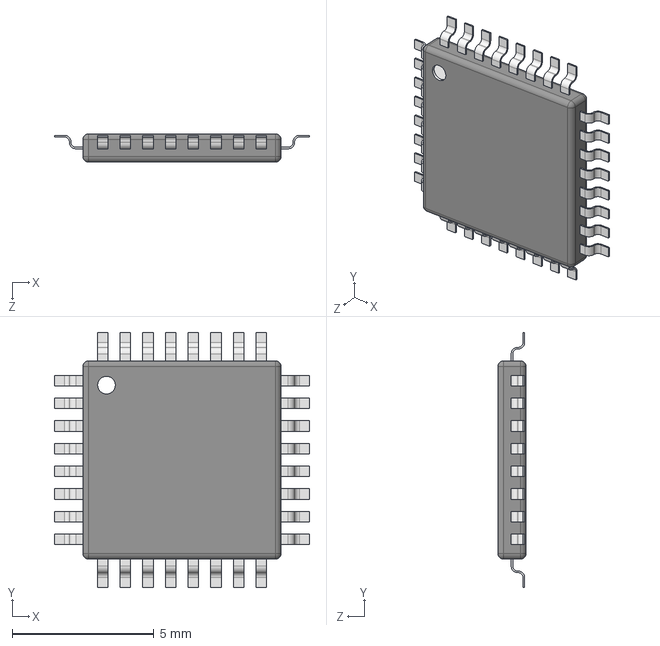
[picture p56: CAD file, 2020-05-17]
Kicad/3d/QFP/TQFP32-0d8.step
9.00 x 9.00 x 1.00 mm
