Kreyl/Libs/Kicad/3d/Quartz/3225.step

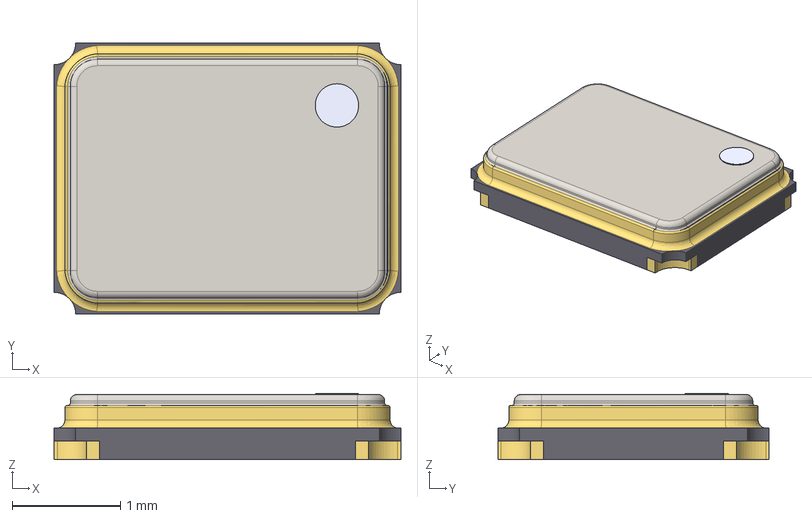
[picture p57: CAD file, 2018-02-26]
Kicad/3d/Quartz/3225.step
3.20 x 2.50 x 0.61 mm
