Kreyl/Libs/Kicad/3d/Resistors/R_0805.step

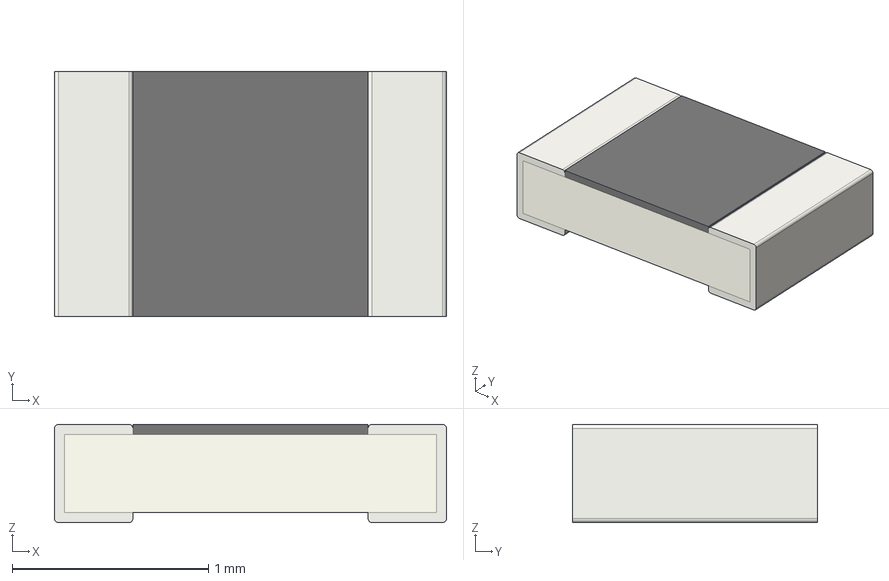
[picture p58: CAD file, 2018-02-26]
Kicad/3d/Resistors/R_0805.step
2.00 x 1.25 x 0.5 mm
