Kreyl/Libs/Kicad/3d/Sensors/EE_SX1321.STEP

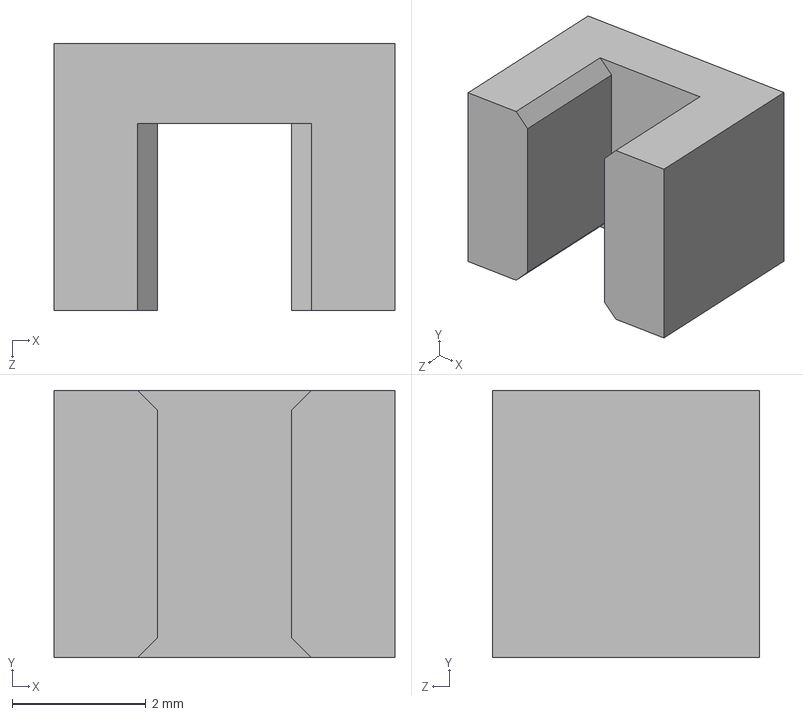
[picture p59: CAD file, 2019-03-25]
Kicad/3d/Sensors/EE_SX1321.STEP
5.10 x 4.00 x 4.00 mm
