Kreyl/Libs/Kicad/3d/SO_DIL_TSSOP/SOIC20_300mil.step

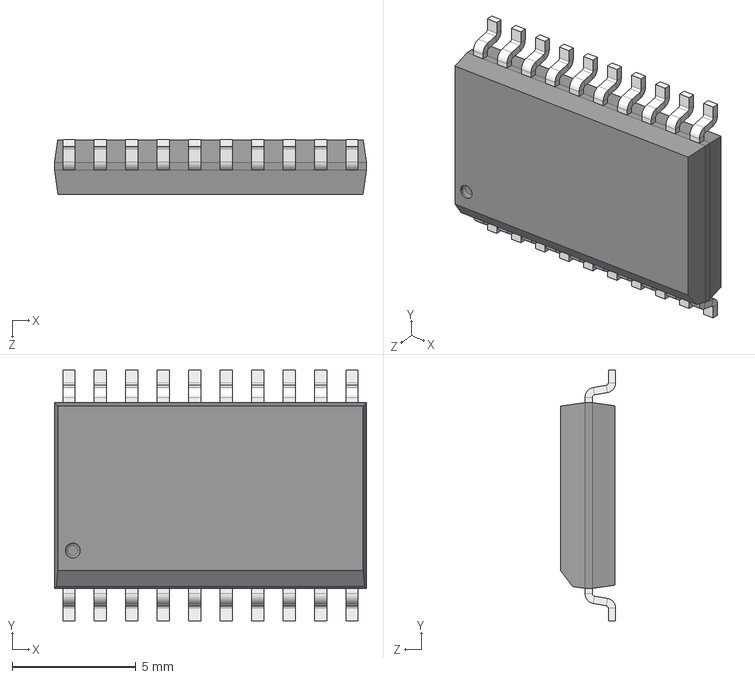
[picture p60: CAD file, 2020-02-28]
Kicad/3d/SO_DIL_TSSOP/SOIC20_300mil.step
12.6 x 10.1 x 2.24 mm
