Kreyl/Libs/Kicad/3d/SOT/SOT-143.step

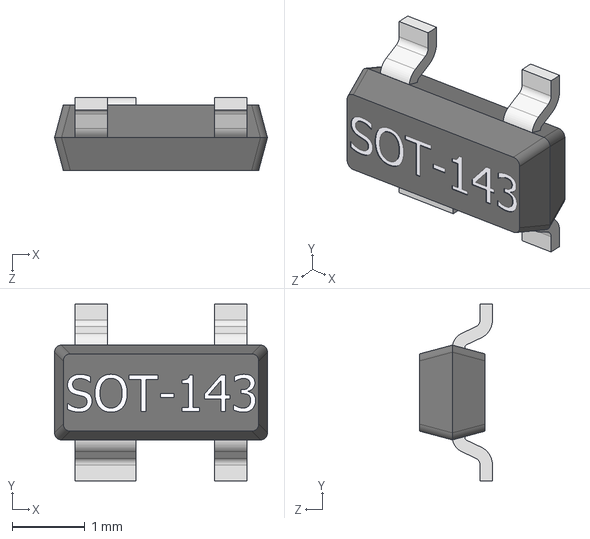
[picture p61: CAD file, 2019-08-30]
Kicad/3d/SOT/SOT-143.step
2.92 x 2.42 x 1.00 mm
