Kreyl/Libs/Kicad/3d/BtnsSwitches/Btn2819.STEP

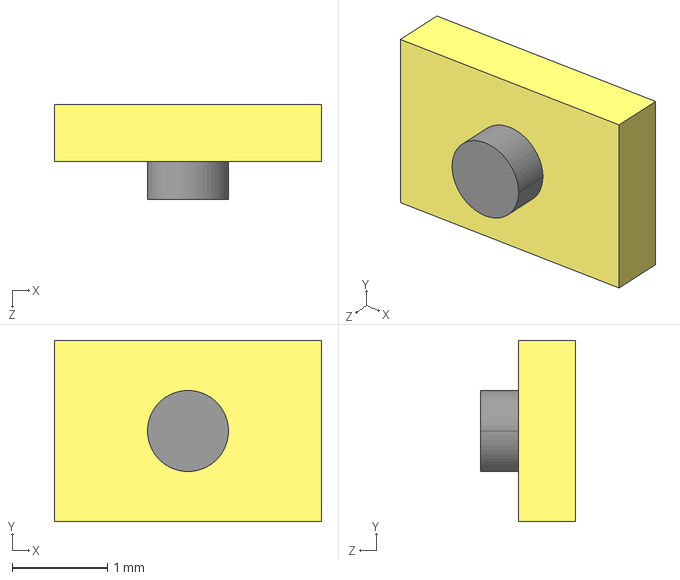
[picture p62: CAD file, 2021-06-26]
Kicad/3d/BtnsSwitches/Btn2819.STEP
2.80 x 1.90 x 1.00 mm
