Kreyl/Libs/Kicad/3d/Capacitors/CAP_TANT_D.stp

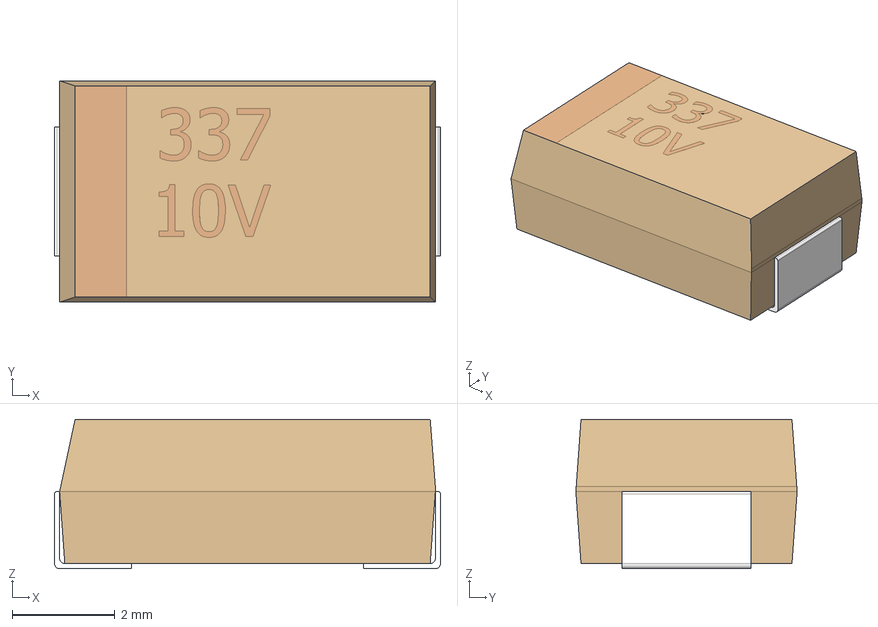
[picture p63: CAD file, 2018-07-22]
Kicad/3d/Capacitors/CAP_TANT_D.stp
7.50 x 4.30 x 2.90 mm
