Kreyl/Libs/Kicad/3d/Connectors/IDC/DS1013-40S (IDC-40MS CONNFLY).step

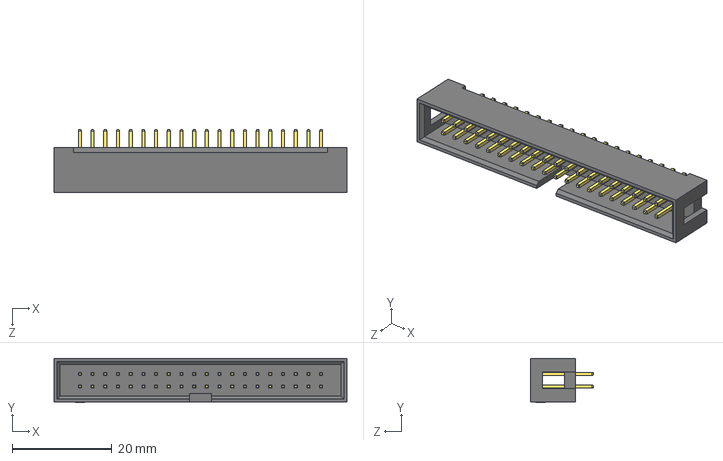
[picture p64: CAD file, 2019-01-16]
Kicad/3d/Connectors/IDC/DS1013-40S (IDC-40MS CONNFLY).step
58.6 x 8.90 x 12.6 mm
