Kreyl/Libs/Kicad/3d/Connectors/USBC_24PF-014.stp

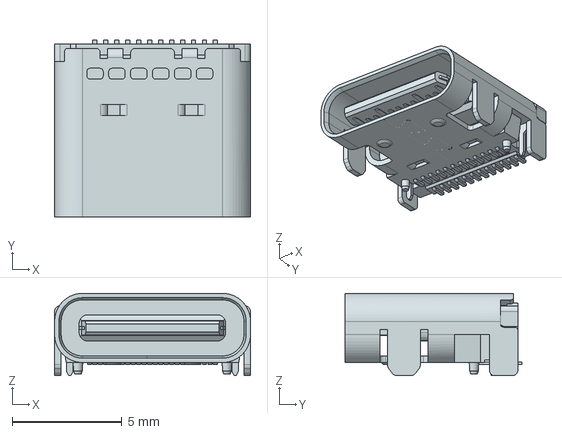
[picture p65: CAD file, 2024-11-10]
Kicad/3d/Connectors/USBC_24PF-014.stp
8.94 x 8.10 x 3.76 mm
