Kreyl/Libs/Kicad/3d/Diodes/DO-214AA.stp

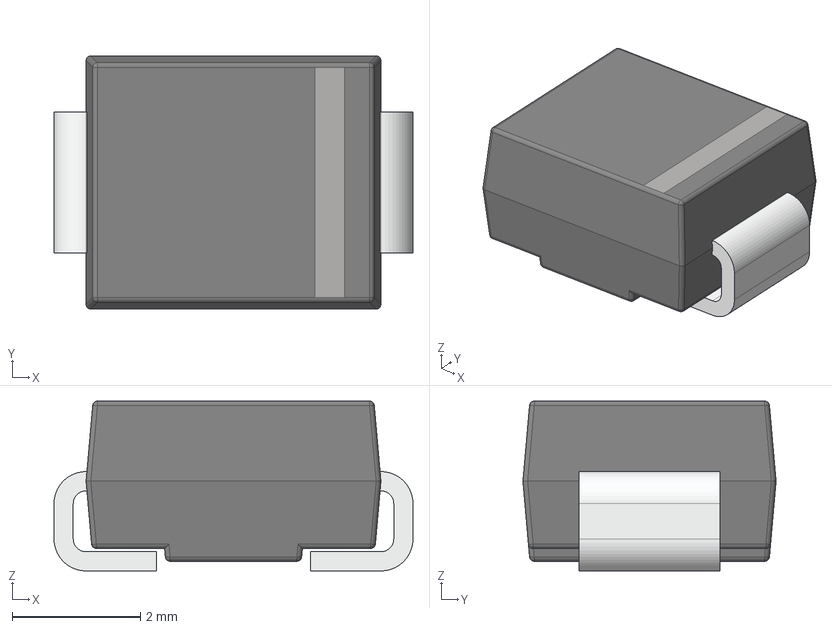
[picture p66: CAD file, 2019-03-06]
Kicad/3d/Diodes/DO-214AA.stp
5.60 x 3.95 x 2.65 mm
