Kreyl/Libs/Kicad/3d/DIP/DIP14.STEP

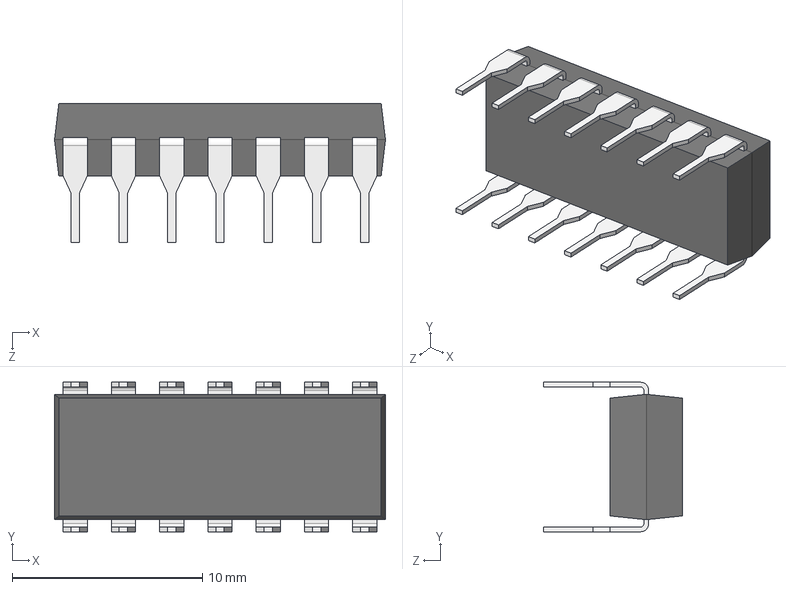
[picture p67: CAD file, 2018-04-20]
Kicad/3d/DIP/DIP14.STEP
17.4 x 7.87 x 7.30 mm
