Kreyl/Libs/Kicad/3d/Installation/BatHolderCandelabra.STEP

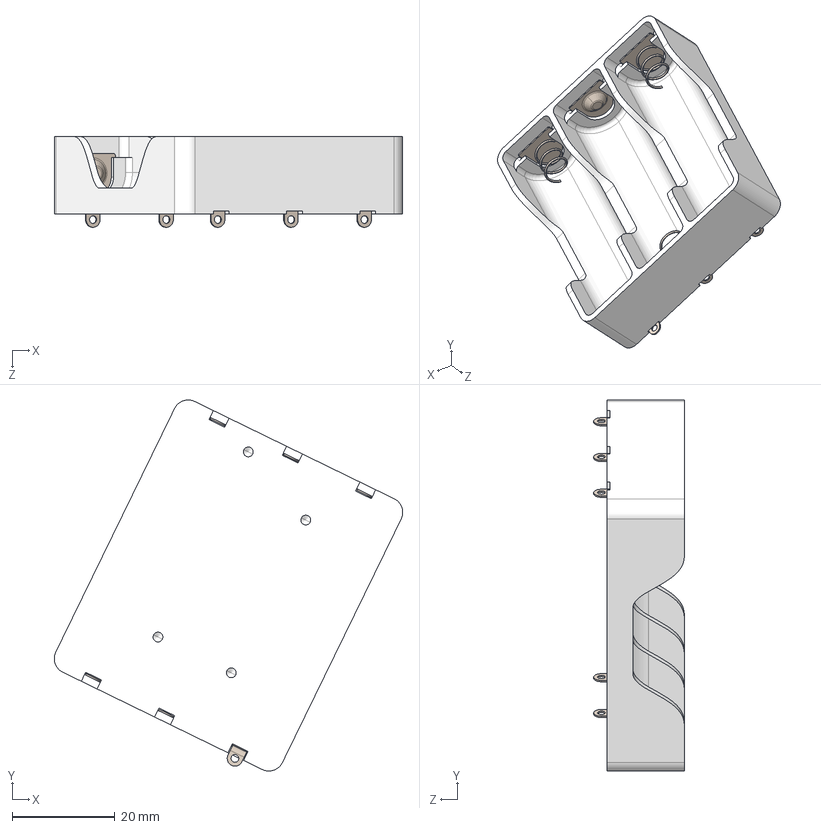
[picture p68: CAD file, 2023-01-26]
Kicad/3d/Installation/BatHolderCandelabra.STEP
67.7 x 72.0 x 17.6 mm
BatCase
BatContactPlusAngle
BatContactPlus x 2
BatContactMinus x 3
