Kreyl/Libs/Kicad/3d/LED/TOS-5161-7seg.STEP

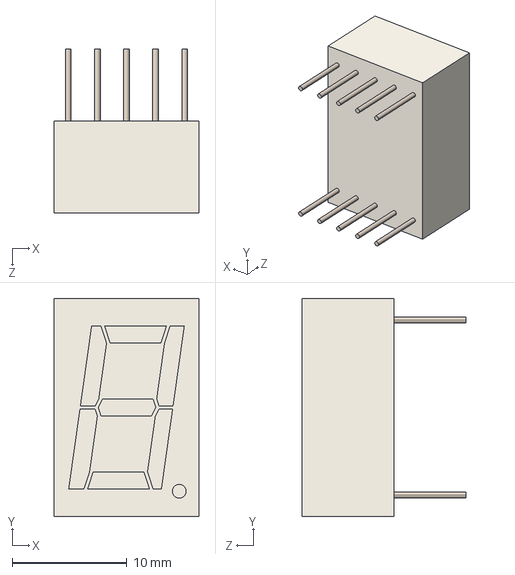
[picture p69: CAD file, 2022-04-08]
Kicad/3d/LED/TOS-5161-7seg.STEP
12.6 x 19.0 x 14.3 mm
