Kreyl/Libs/Kicad/3d/Modules/JDY-08.STEP

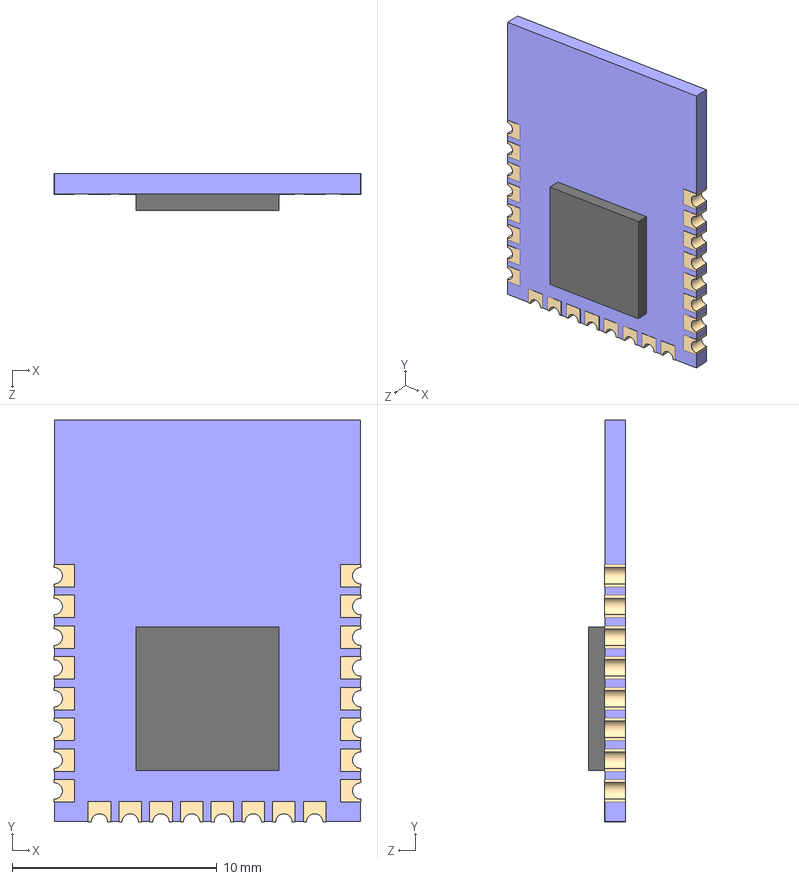
[picture p70: CAD file, 2020-12-03]
Kicad/3d/Modules/JDY-08.STEP
15.0 x 19.6 x 1.82 mm
