Kreyl/Libs/Kicad/3d/QFN_DFN/UDFN-8_2X3_0d5.step

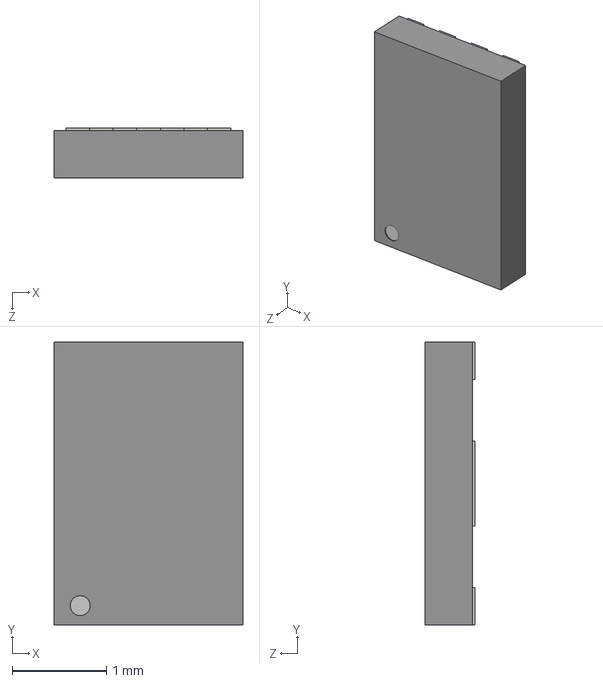
[picture p71: CAD file, 2019-12-18]
Kicad/3d/QFN_DFN/UDFN-8_2X3_0d5.step
2.00 x 3.00 x 0.525 mm
