Kreyl/Libs/Kicad/3d/QFP/LQFP48_05.STEP

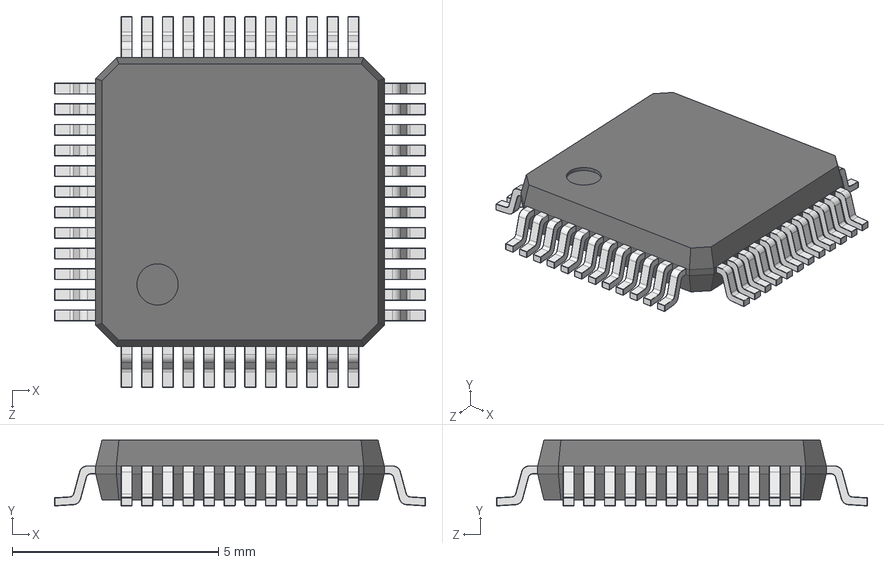
[picture p72: CAD file, 2019-04-02]
Kicad/3d/QFP/LQFP48_05.STEP
9.00 x 1.60 x 9.00 mm
User Library-LQFP48_Grid_0.5_LQFP48_Koerper_2
User Library-LQFP48_Grid_0.5_LQFP_PIN_2 x 48
