Kreyl/Libs/Kicad/3d/Resistors/R_1206.step

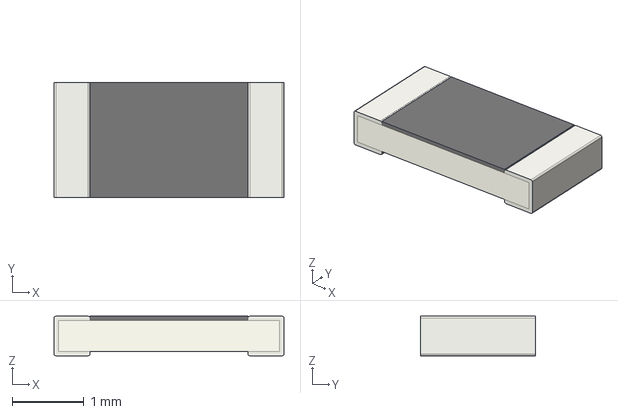
[picture p73: CAD file, 2018-02-26]
Kicad/3d/Resistors/R_1206.step
3.20 x 1.60 x 0.55 mm
