Kreyl/Libs/Kicad/3d/Sensors/tsop48xx.STEP

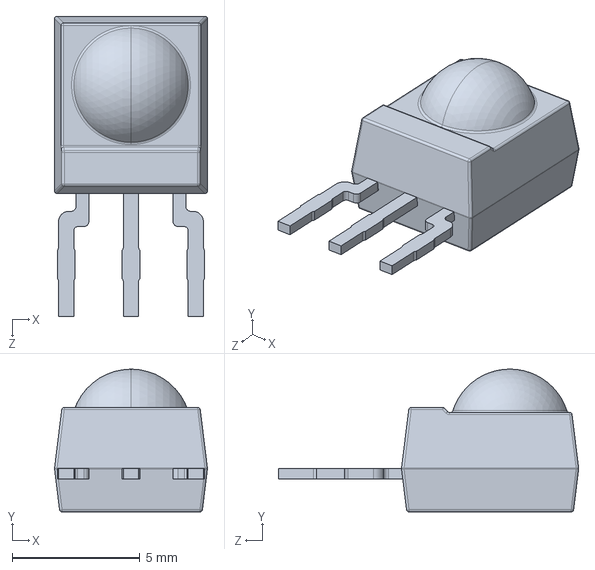
[picture p74: CAD file, 2018-04-20]
Kicad/3d/Sensors/tsop48xx.STEP
6.00 x 5.60 x 11.8 mm
