Kreyl/Libs/Kicad/3d/SO_DIL_TSSOP/SO8.step

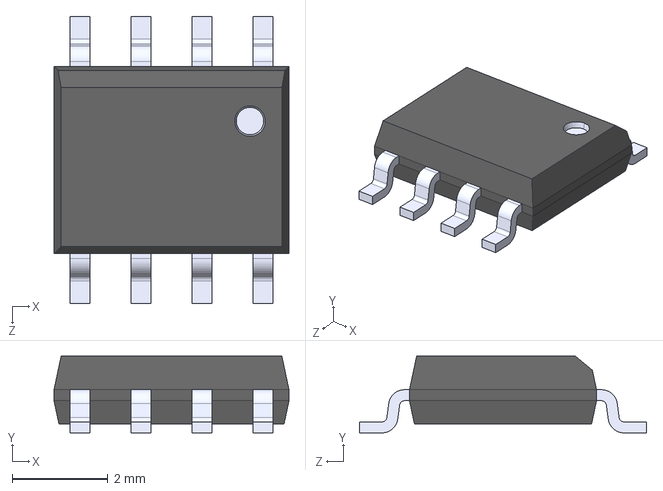
[picture p75: CAD file, 2019-11-08]
Kicad/3d/SO_DIL_TSSOP/SO8.step
4.90 x 1.60 x 5.99 mm
