Kreyl/Libs/Kicad/3d/SOT/SOT-23-6.step

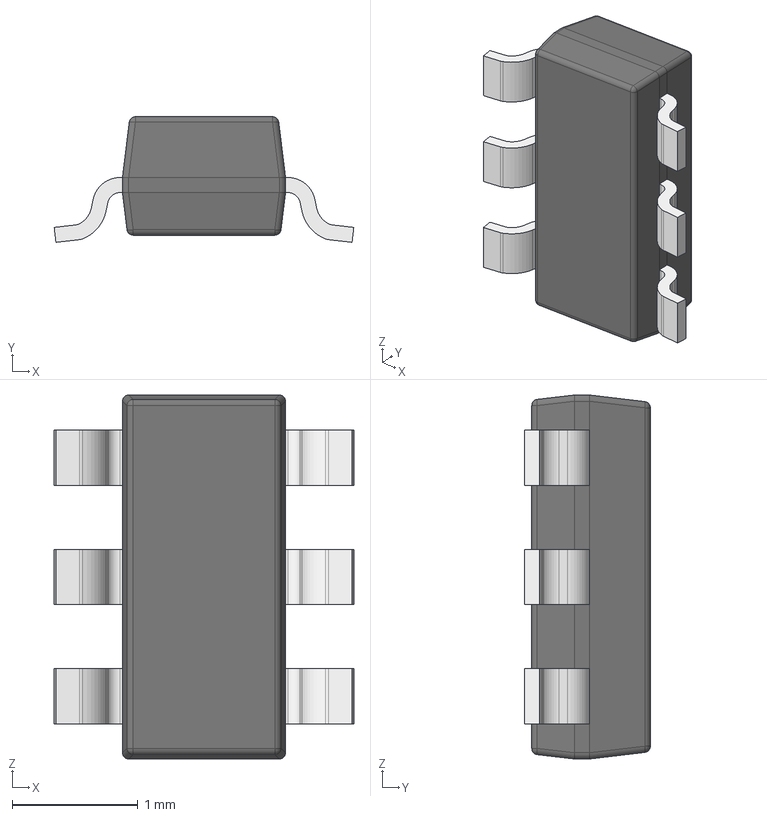
[picture p76: CAD file, 2018-02-26]
Kicad/3d/SOT/SOT-23-6.step
2.39 x 1.00 x 2.90 mm
