Kreyl/Libs/Kicad/3d/BtnsSwitches/silent_button.stp

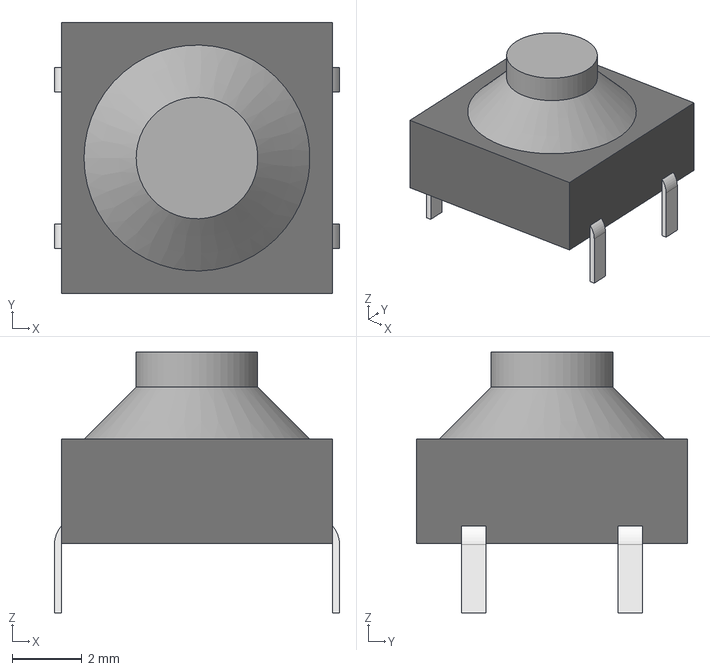
[picture p77: CAD file, 2020-12-03]
Kicad/3d/BtnsSwitches/silent_button.stp
8.20 x 7.80 x 7.50 mm
