Kreyl/Libs/Kicad/3d/Capacitors/CAPTH220-50.stp

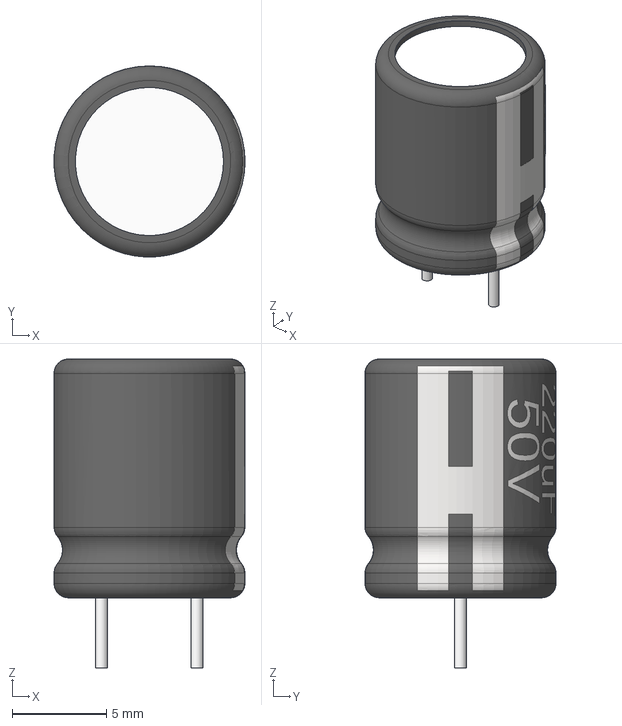
[picture p78: CAD file, 2018-06-03]
Kicad/3d/Capacitors/CAPTH220-50.stp
10.2 x 10.2 x 16.4 mm
