Kreyl/Libs/Kicad/3d/Connectors/B6B-ZR_1d5mm.STEP

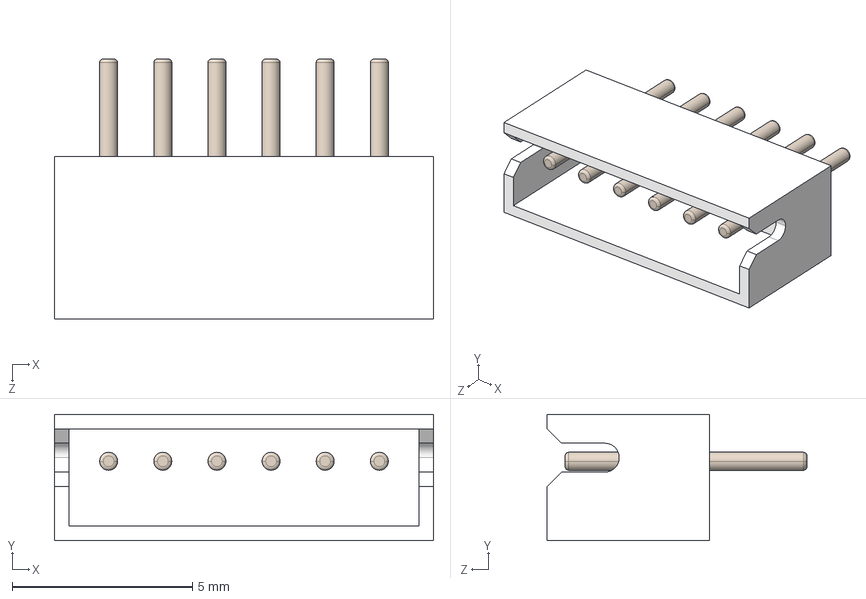
[picture p79: CAD file, 2024-11-09]
Kicad/3d/Connectors/B6B-ZR_1d5mm.STEP
10.5 x 3.50 x 7.20 mm
