Kreyl/Libs/Kicad/3d/Connectors/IDC/DS1013-60S (IDC-60MS CONNFLY).step

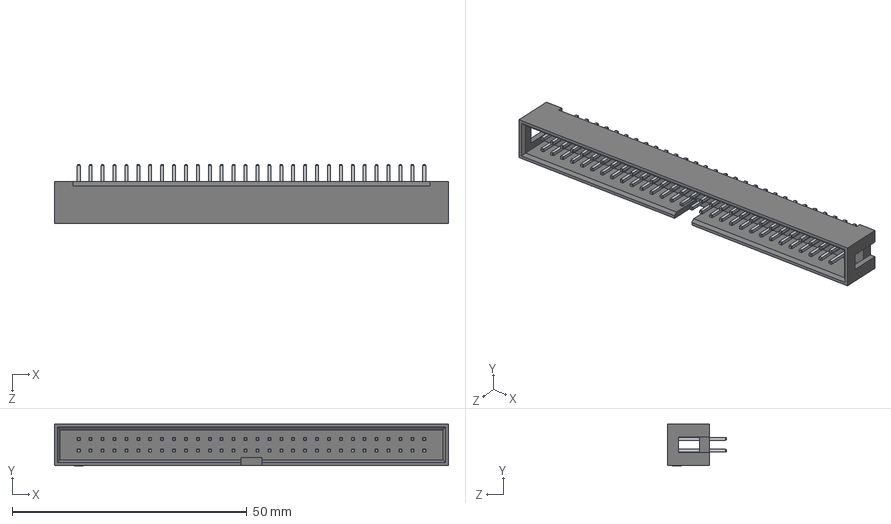
[picture p80: CAD file, 2019-01-16]
Kicad/3d/Connectors/IDC/DS1013-60S (IDC-60MS CONNFLY).step
84.0 x 8.90 x 12.6 mm
