Kreyl/Libs/Kicad/3d/Diodes/Diode SMA.stp

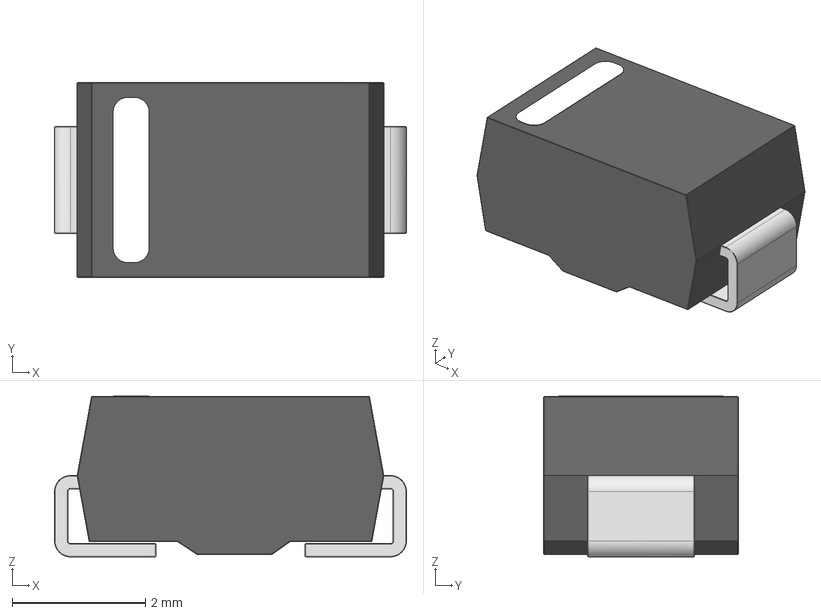
[picture p81: CAD file, 2018-06-03]
Kicad/3d/Diodes/Diode SMA.stp
5.28 x 2.92 x 2.41 mm
