Kreyl/Libs/Kicad/3d/DIP/DIP8.STEP

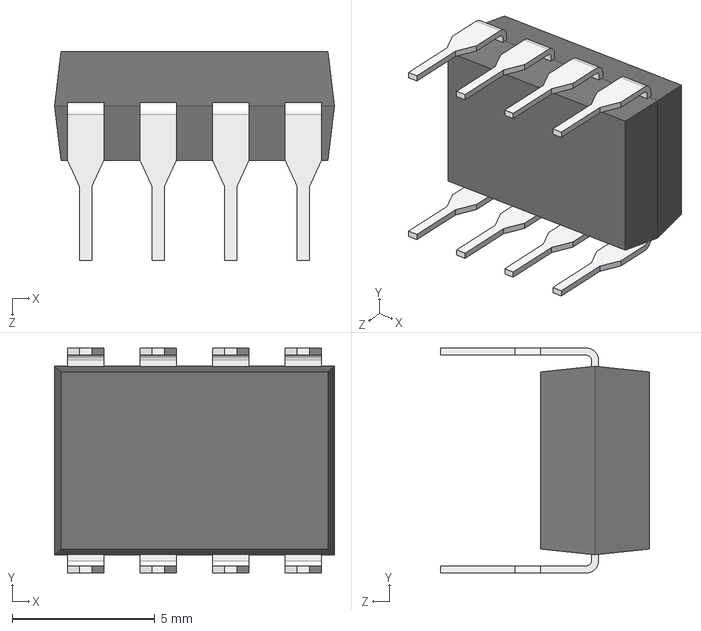
[picture p82: CAD file, 2018-04-20]
Kicad/3d/DIP/DIP8.STEP
9.80 x 7.87 x 7.30 mm
