Kreyl/Libs/Kicad/3d/Inductors/IndSRP2010.STEP

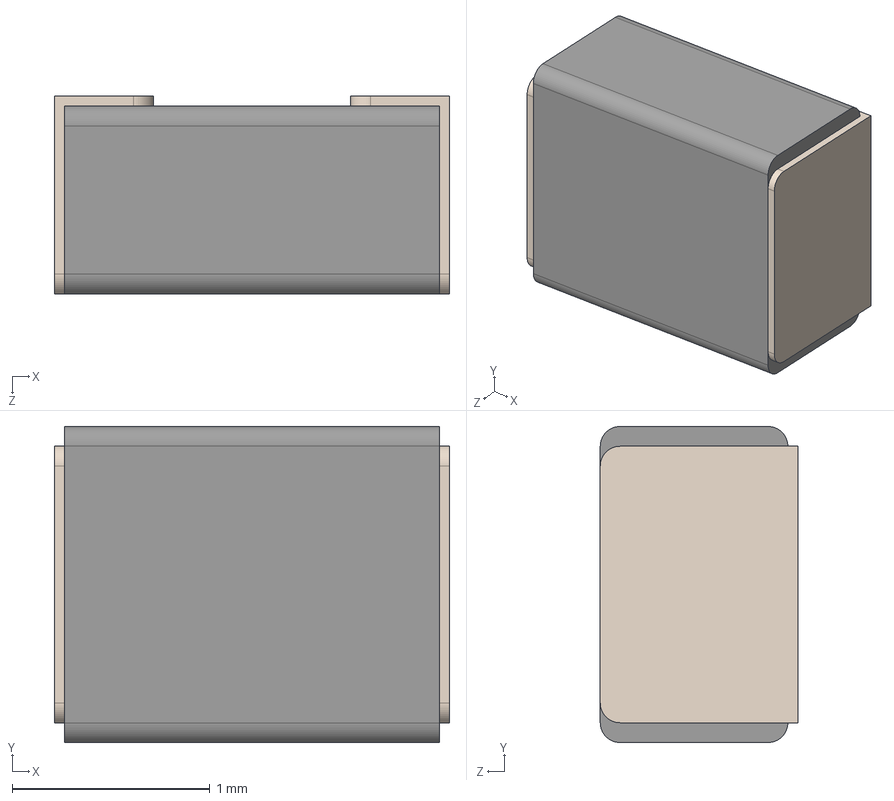
[picture p83: CAD file, 2021-06-26]
Kicad/3d/Inductors/IndSRP2010.STEP
2.00 x 1.60 x 1.00 mm
