Kreyl/Libs/Kicad/3d/Installation/BatteryHolder 2xAAA.STEP

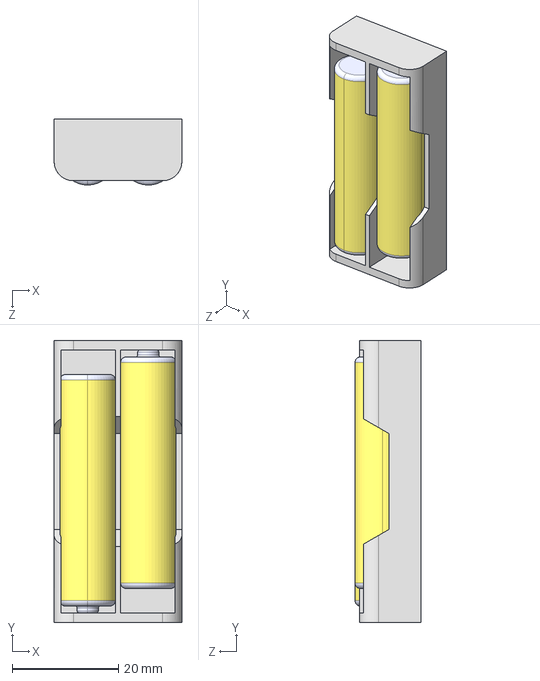
[picture p84: CAD file, 2019-08-04]
Kicad/3d/Installation/BatteryHolder 2xAAA.STEP
24.0 x 53.0 x 12.4 mm
BatteryHolder 2xAAA
Battery AAA x 2
