Kreyl/Libs/Kicad/3d/LED/Epistar3535_RGB.STEP

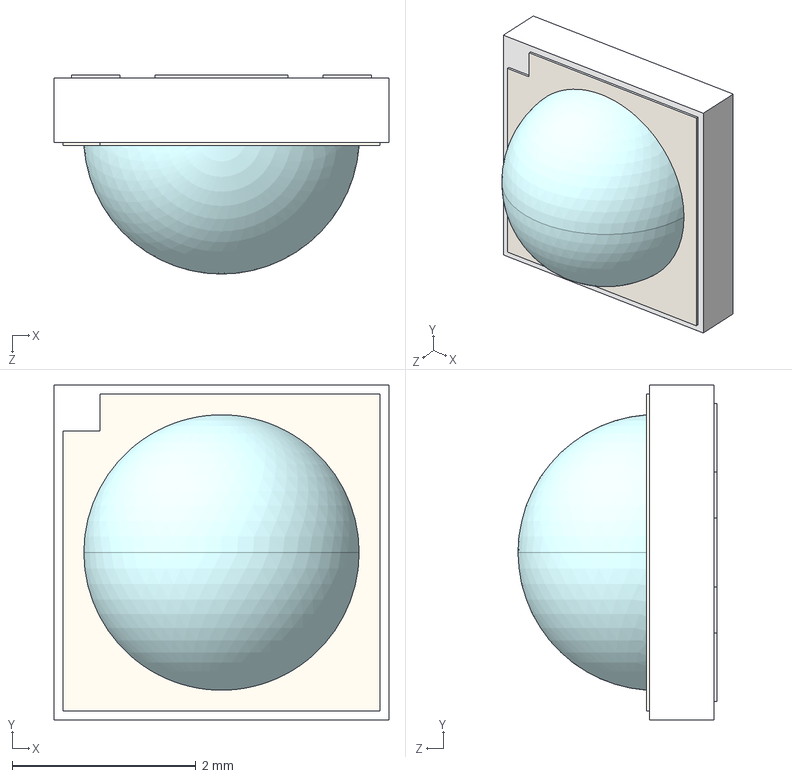
[picture p85: CAD file, 2021-01-27]
Kicad/3d/LED/Epistar3535_RGB.STEP
3.65 x 3.65 x 2.17 mm
