Kreyl/Libs/Kicad/3d/Modules/ESP32-WROOM-32.step

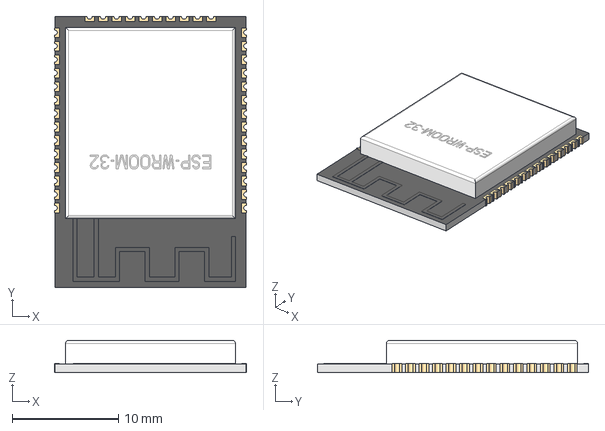
[picture p86: CAD file, 2018-09-16]
Kicad/3d/Modules/ESP32-WROOM-32.step
18.1 x 25.5 x 3.04 mm
