Kreyl/Libs/Kicad/3d/QFN_DFN/QFN48_6x6_Pitch0.4.step

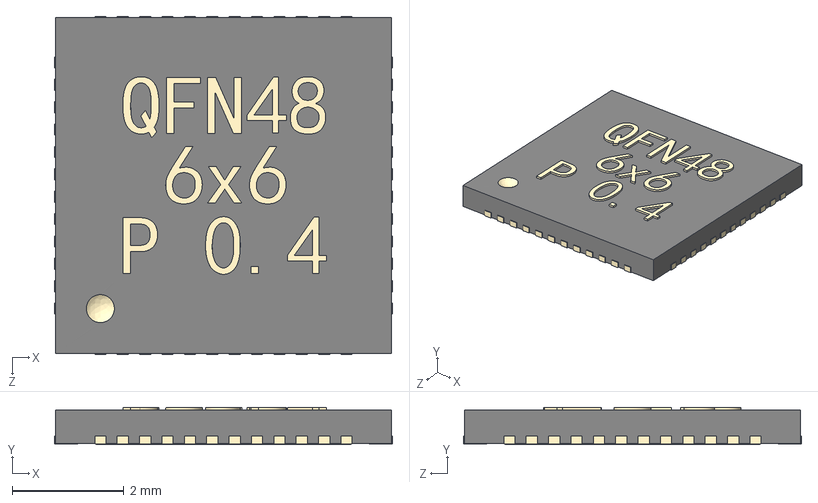
[picture p87: CAD file, 2019-08-04]
Kicad/3d/QFN_DFN/QFN48_6x6_Pitch0.4.step
6.04 x 0.67 x 6.04 mm
