Kreyl/Libs/Kicad/3d/Resistors/R_2816.step

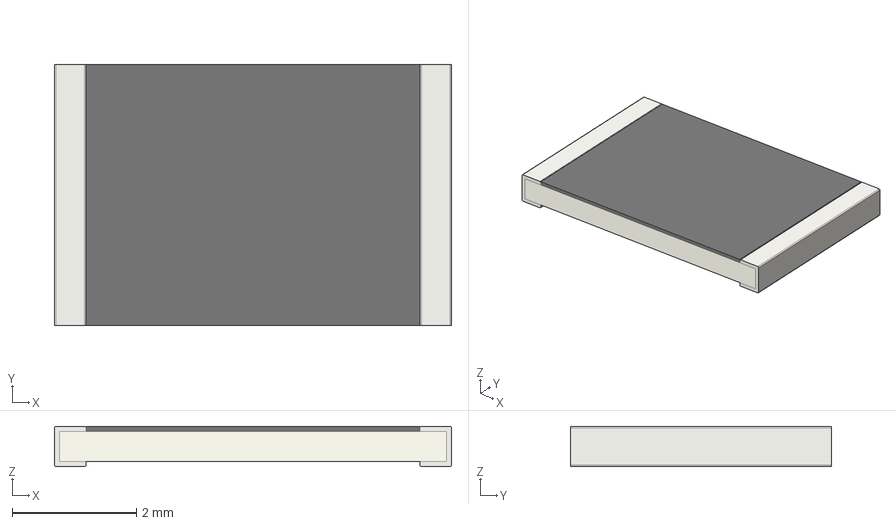
[picture p88: CAD file, 2018-02-26]
Kicad/3d/Resistors/R_2816.step
6.40 x 4.20 x 0.65 mm
