Kreyl/Libs/Kicad/3d/SO_DIL_TSSOP/TSSOP-28.STEP

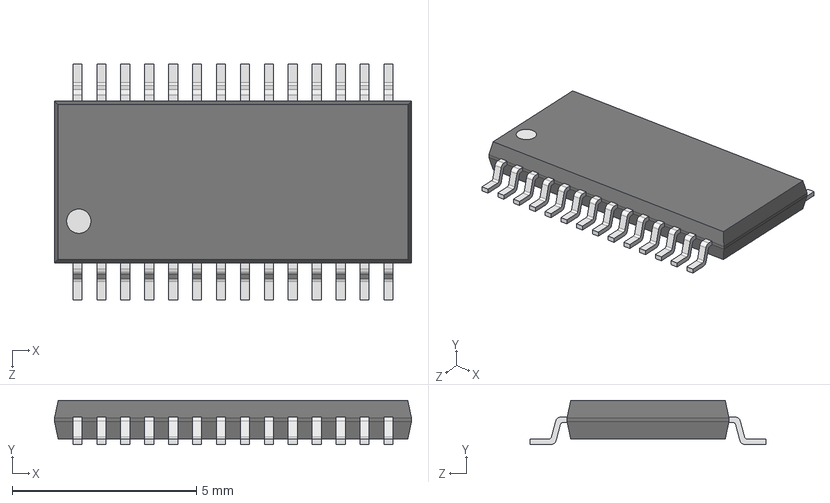
[picture p89: CAD file, 2019-11-08]
Kicad/3d/SO_DIL_TSSOP/TSSOP-28.STEP
9.70 x 1.20 x 6.40 mm
_X2_041A043E0440043F04430441_X0_
_X2_041C04350442043A0430_X0_
_X2_041D043E0436043A0430_X0_ x 14
