Kreyl/Libs/Kicad/3d/SOT/SOT-23-5.step

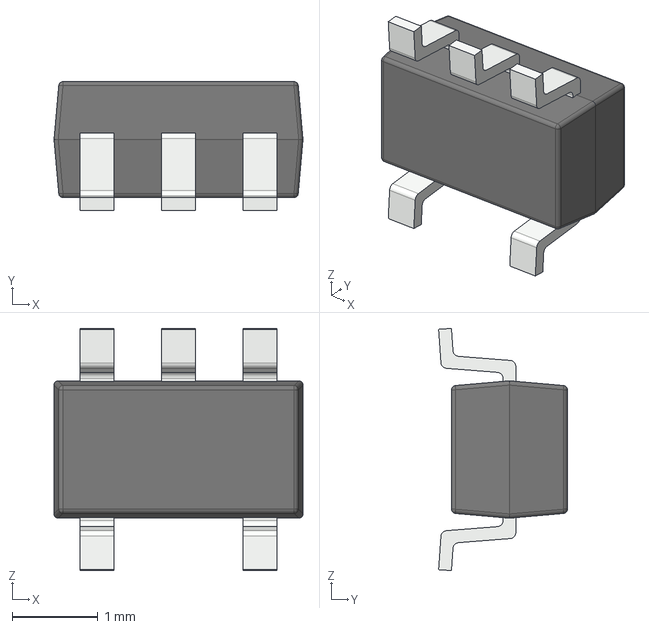
[picture p90: CAD file, 2018-02-26]
Kicad/3d/SOT/SOT-23-5.step
2.90 x 1.50 x 2.82 mm
