Kreyl/Libs/Kicad/3d/BtnsSwitches/Tortsevaya_knopka_K5-1624SA-01.STEP

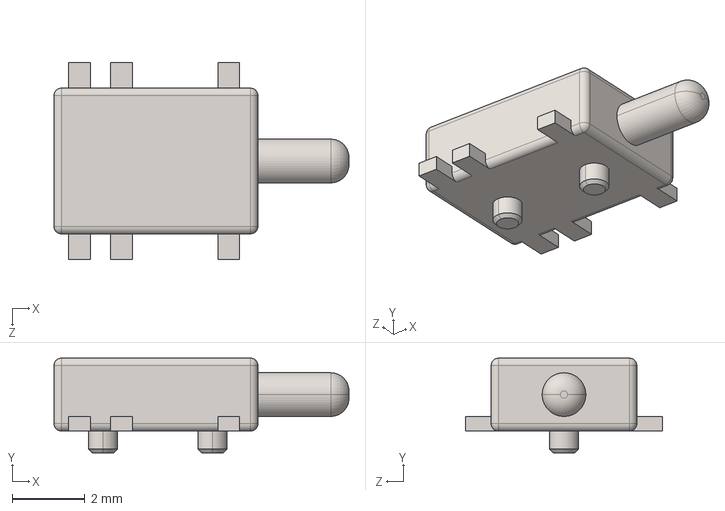
[picture p91: CAD file, 2020-12-03]
Kicad/3d/BtnsSwitches/Tortsevaya_knopka_K5-1624SA-01.STEP
8.10 x 2.60 x 5.40 mm
