Kreyl/Libs/Kicad/3d/Capacitors/CAPTH2200-25.stp

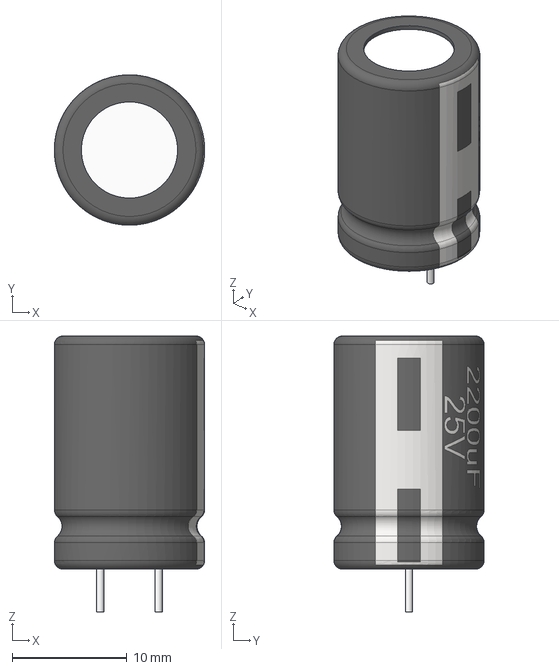
[picture p92: CAD file, 2018-06-03]
Kicad/3d/Capacitors/CAPTH2200-25.stp
13.1 x 13.1 x 24.1 mm
