Kreyl/Libs/Kicad/3d/Connectors/IDC/DS1013-12S (IDC-12MS CONNFLY).stp

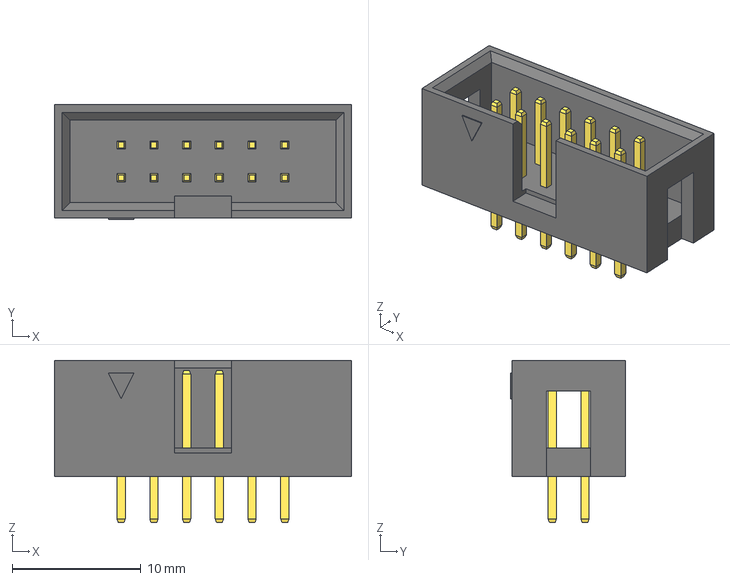
[picture p93: CAD file, 2019-01-16]
Kicad/3d/Connectors/IDC/DS1013-12S (IDC-12MS CONNFLY).stp
23.0 x 8.90 x 12.6 mm
