Kreyl/Libs/Kicad/3d/Connectors/KLS1-2.54-02-S.STEP

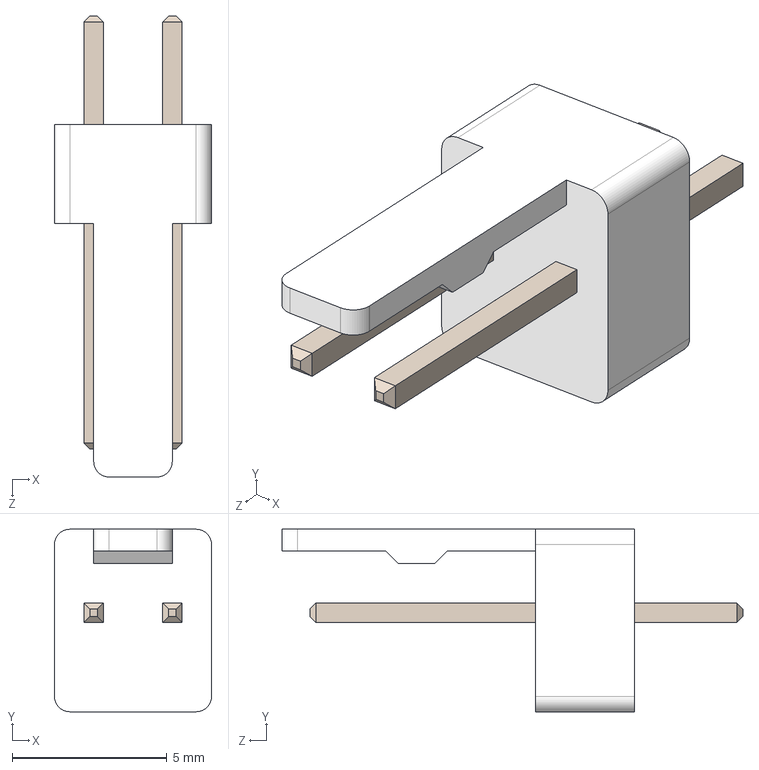
[picture p94: CAD file, 2024-11-09]
Kicad/3d/Connectors/KLS1-2.54-02-S.STEP
5.08 x 5.90 x 14.9 mm
