Kreyl/Libs/Kicad/3d/Diodes/SOD-123.step

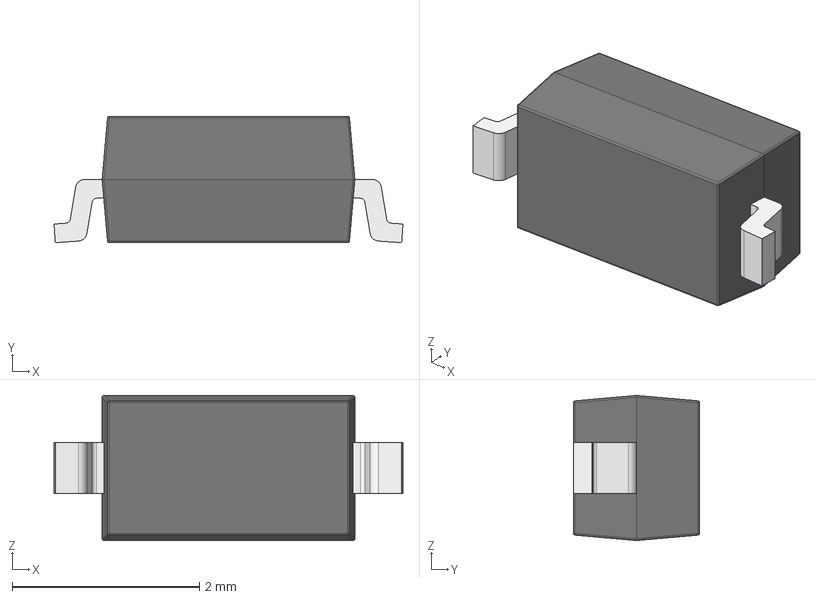
[picture p95: CAD file, 2018-03-07]
Kicad/3d/Diodes/SOD-123.step
3.73 x 1.35 x 1.55 mm
