Kreyl/Libs/Kicad/3d/Inductors/DLW21S.STEP

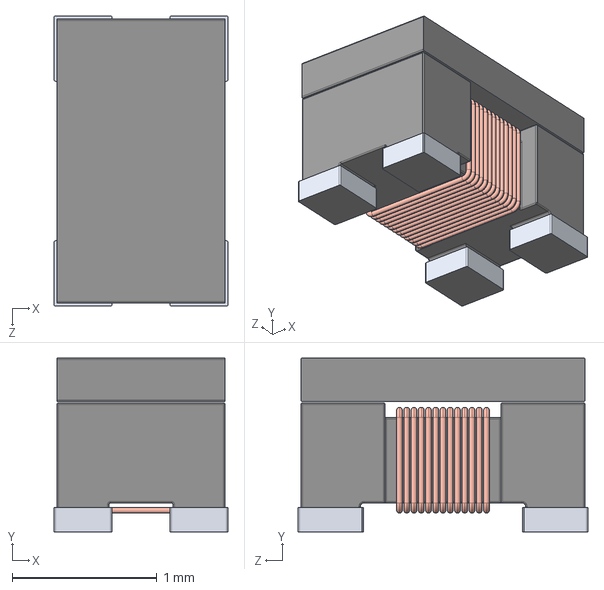
[picture p96: CAD file, 2021-01-27]
Kicad/3d/Inductors/DLW21S.STEP
1.20 x 1.20 x 2.00 mm
