Kreyl/Libs/Kicad/3d/Installation/Mic35_265.stp

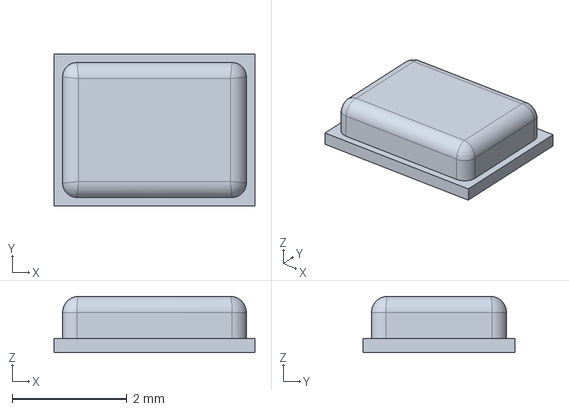
[picture p97: CAD file, 2019-06-02]
Kicad/3d/Installation/Mic35_265.stp
3.50 x 2.65 x 0.98 mm
