Kreyl/Libs/Kicad/3d/LED/TO2106.STEP

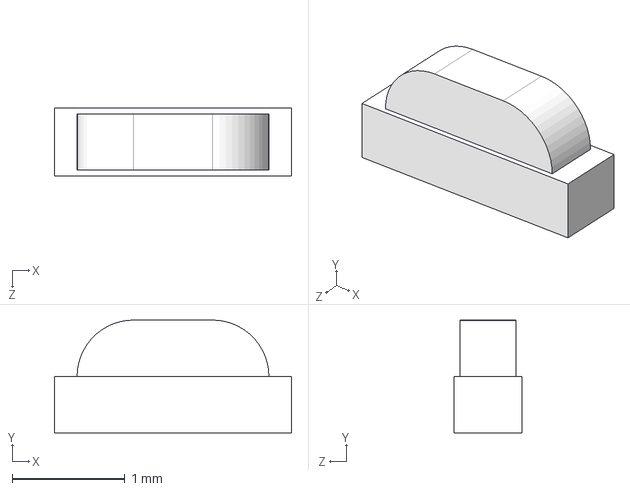
[picture p98: CAD file, 2020-12-03]
Kicad/3d/LED/TO2106.STEP
2.10 x 1.00 x 0.6 mm
