Kreyl/Libs/Kicad/3d/QFN_DFN/QFN48_7x7_Pitch0.5.step

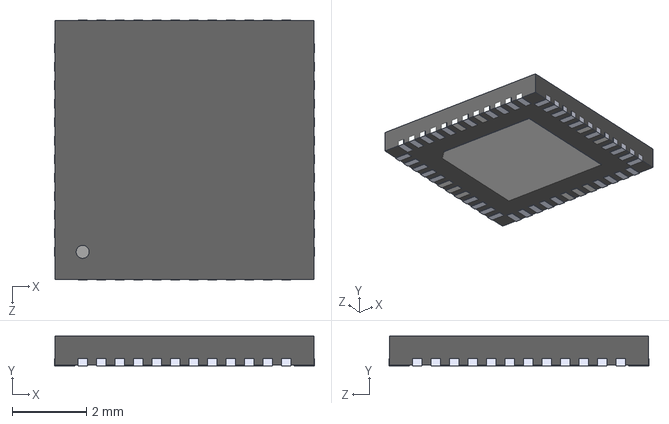
[picture p99: CAD file, 2019-04-22]
Kicad/3d/QFN_DFN/QFN48_7x7_Pitch0.5.step
7.02 x 0.8 x 7.02 mm
