Kreyl/Libs/Kicad/3d/Resistors/R_1210.step

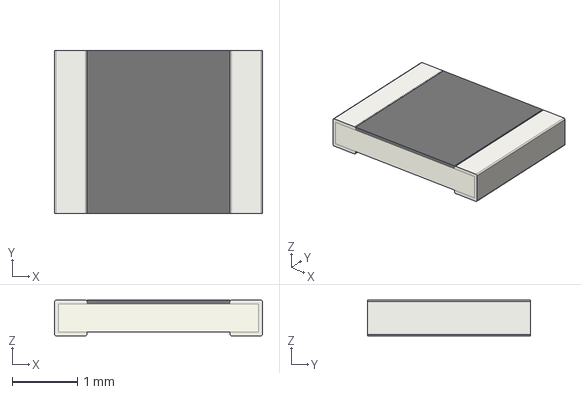
[picture p100: CAD file, 2018-02-26]
Kicad/3d/Resistors/R_1210.step
3.20 x 2.50 x 0.55 mm
