Kreyl/Libs/Kicad/3d/SO_DIL_TSSOP/MT48LC16M16A2P-6A_G.stp

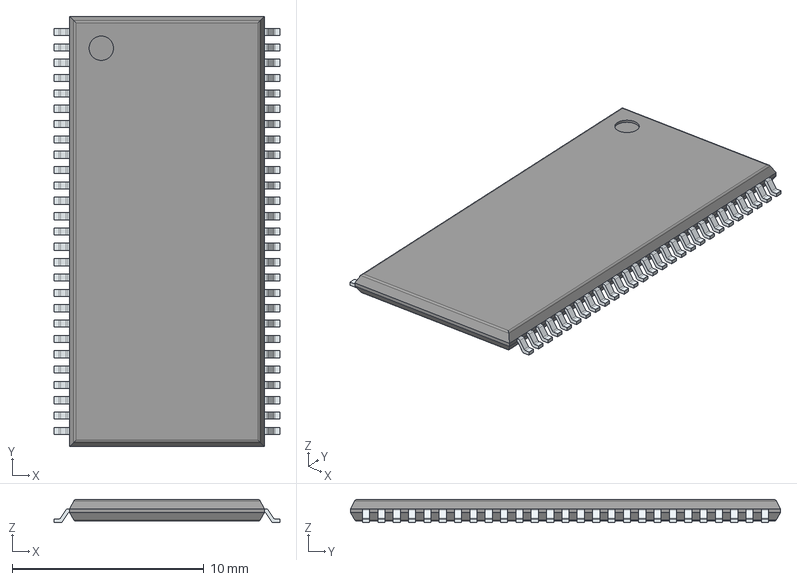
[picture p101: CAD file, 2019-08-30]
Kicad/3d/SO_DIL_TSSOP/MT48LC16M16A2P-6A_G.stp
11.8 x 22.4 x 1.20 mm
PinsArrayLR
