Kreyl/Libs/Kicad/3d/SOT/SOT-223.step

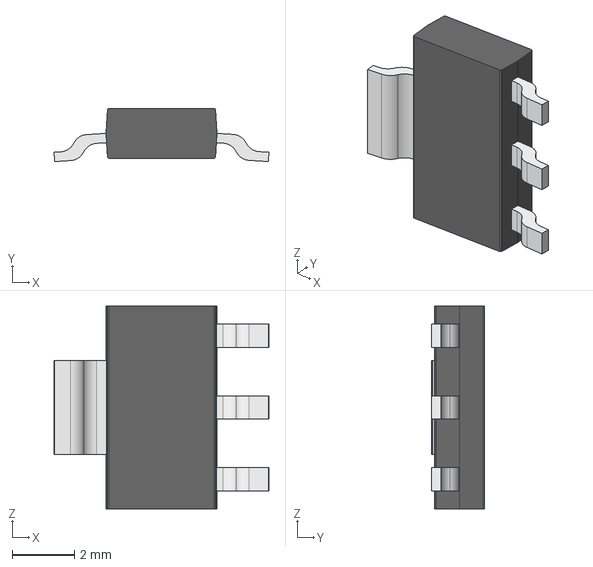
[picture p102: CAD file, 2018-02-26]
Kicad/3d/SOT/SOT-223.step
6.89 x 1.70 x 6.50 mm
