Kreyl/Libs/Kicad/3d/BtnsSwitches/SMD_IS-1290_1P2T_2-kh_pozitsionny_dvizhkovy_pereklyuchatel.STEP

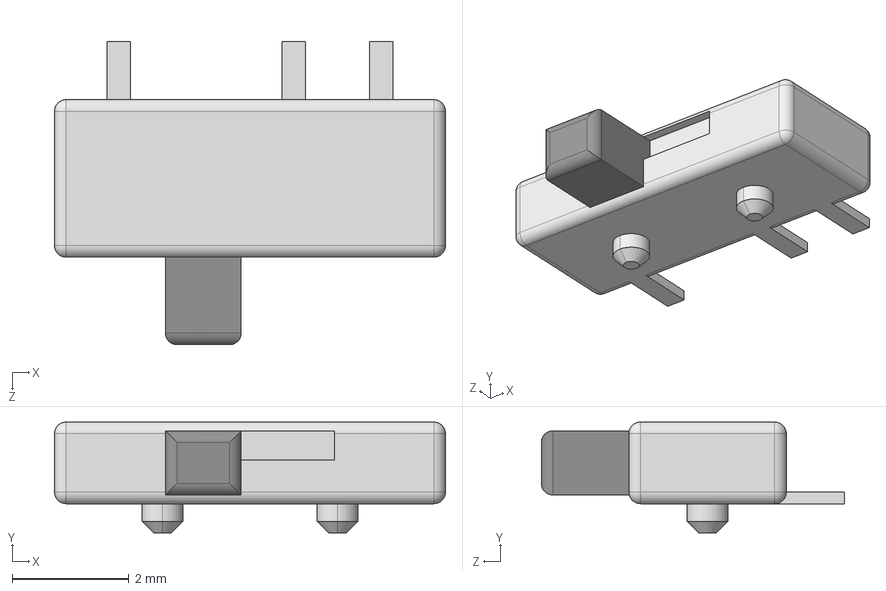
[picture p103: CAD file, 2020-12-03]
Kicad/3d/BtnsSwitches/SMD_IS-1290_1P2T_2-kh_pozitsionny_dvizhkovy_pereklyuchatel.STEP
6.70 x 1.90 x 5.20 mm
