Kreyl/Libs/Kicad/3d/Capacitors/CAPTH1000-25.stp

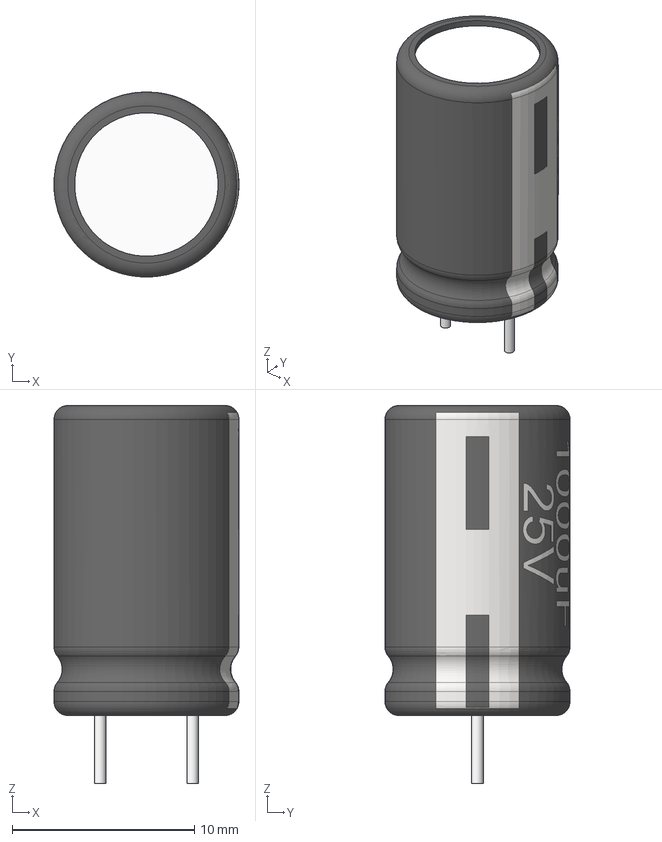
[picture p104: CAD file, 2018-06-03]
Kicad/3d/Capacitors/CAPTH1000-25.stp
10.2 x 10.2 x 20.8 mm
