Kreyl/Libs/Kicad/3d/Connectors/Conn_PLS-4.STEP

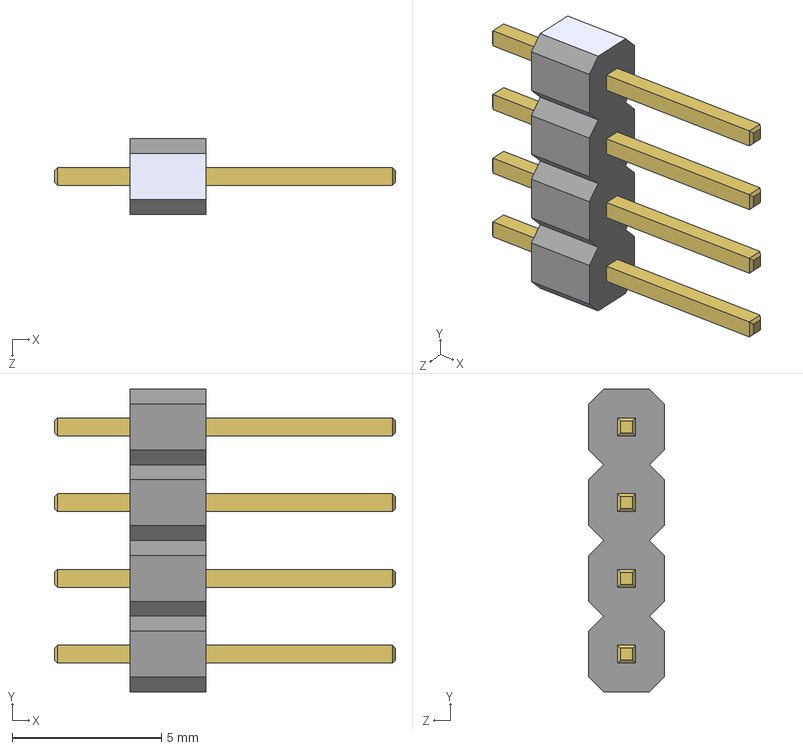
[picture p105: CAD file, 2024-08-31]
Kicad/3d/Connectors/Conn_PLS-4.STEP
11.4 x 10.2 x 2.54 mm
