Kreyl/Libs/Kicad/3d/Connectors/IDC/DS1013-64S (IDC-64MS CONNFLY).step

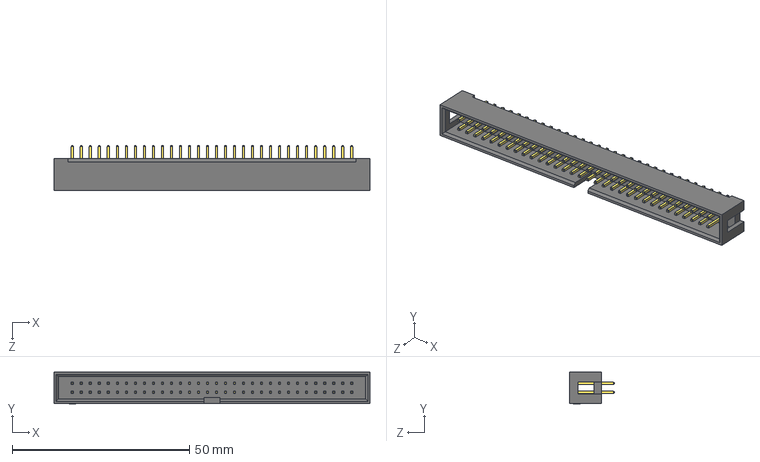
[picture p106: CAD file, 2019-01-16]
Kicad/3d/Connectors/IDC/DS1013-64S (IDC-64MS CONNFLY).step
89.1 x 8.90 x 12.6 mm
