Kreyl/Libs/Kicad/3d/Diodes/SOD-128.step

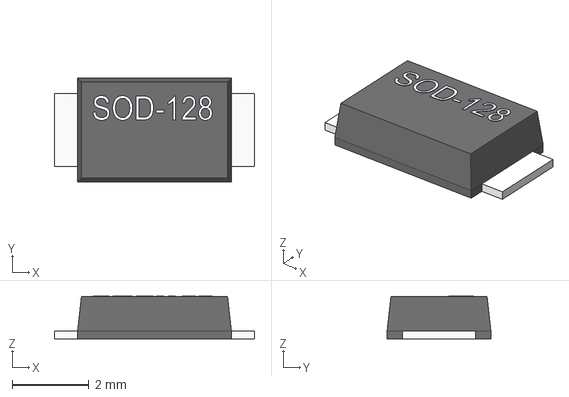
[picture p107: CAD file, 2018-03-07]
Kicad/3d/Diodes/SOD-128.step
5.20 x 2.70 x 1.11 mm
