Kreyl/Libs/Kicad/3d/Inductors/Ind 0502.STEP

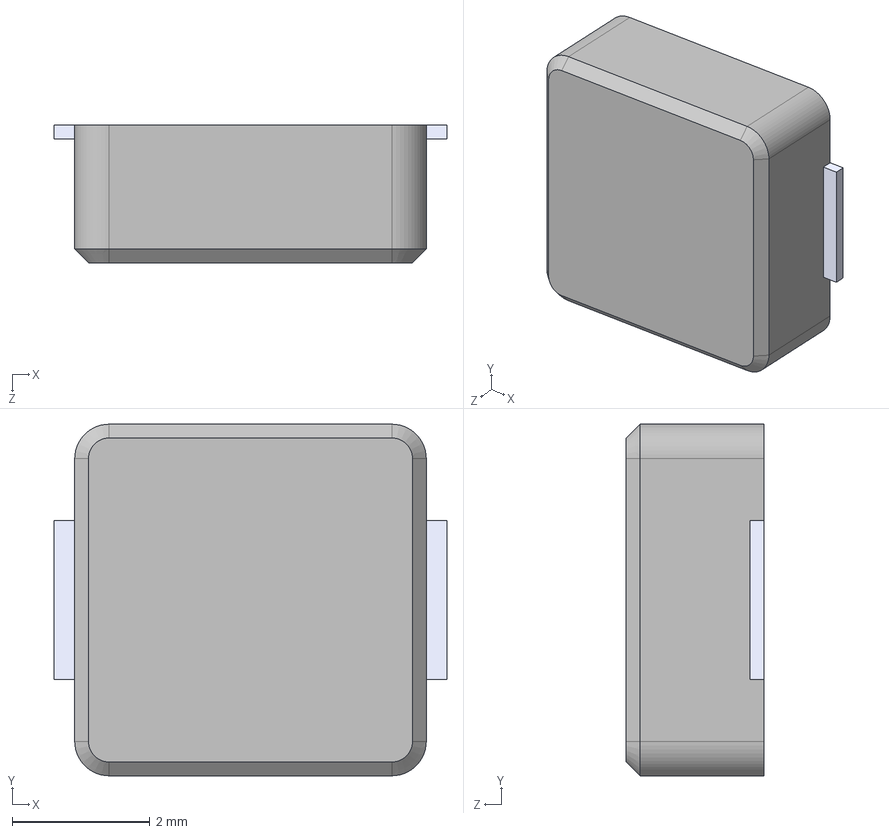
[picture p108: CAD file, 2020-09-08]
Kicad/3d/Inductors/Ind 0502.STEP
5.70 x 5.10 x 2.00 mm
