Kreyl/Libs/Kicad/3d/Installation/PwrSupp_IRM-60.STEP

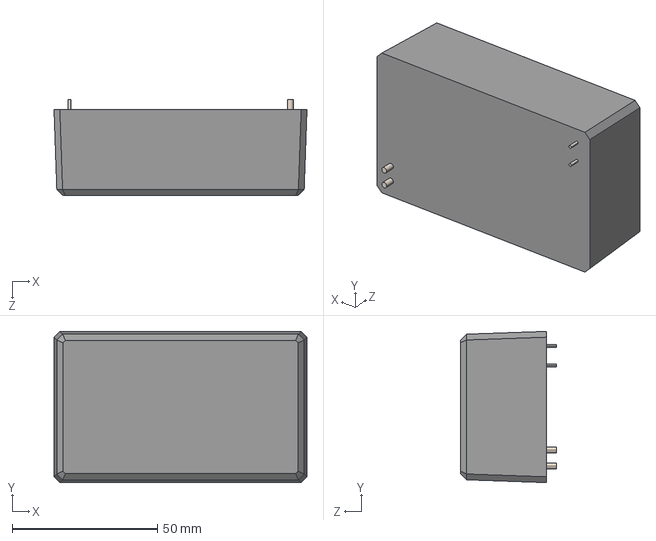
[picture p109: CAD file, 2019-02-25]
Kicad/3d/Installation/PwrSupp_IRM-60.STEP
87.0 x 52.0 x 33.0 mm
