Kreyl/Libs/Kicad/3d/LED/LED_0603_W.step

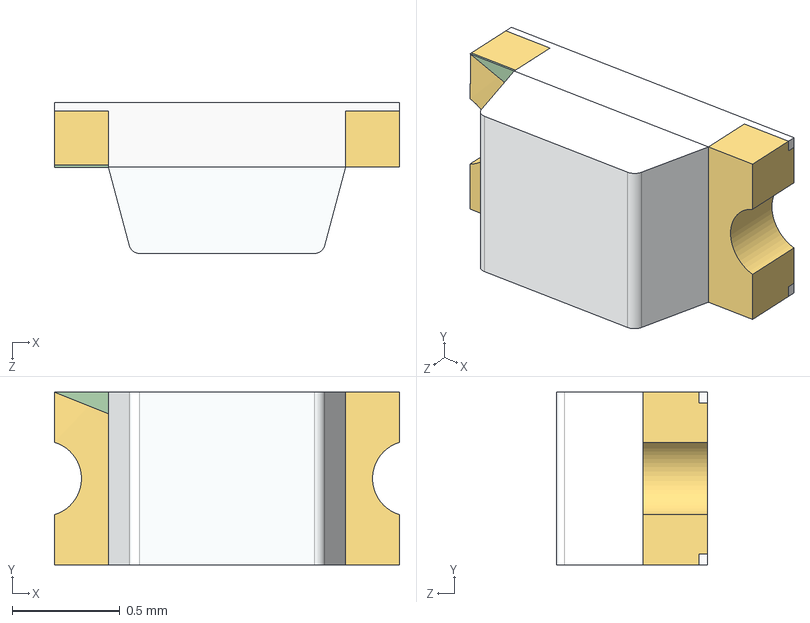
[picture p110: CAD file, 2019-10-04]
Kicad/3d/LED/LED_0603_W.step
1.60 x 0.8 x 0.7 mm
