Kreyl/Libs/Kicad/3d/QFN_DFN/LGA 3x2d5.STEP

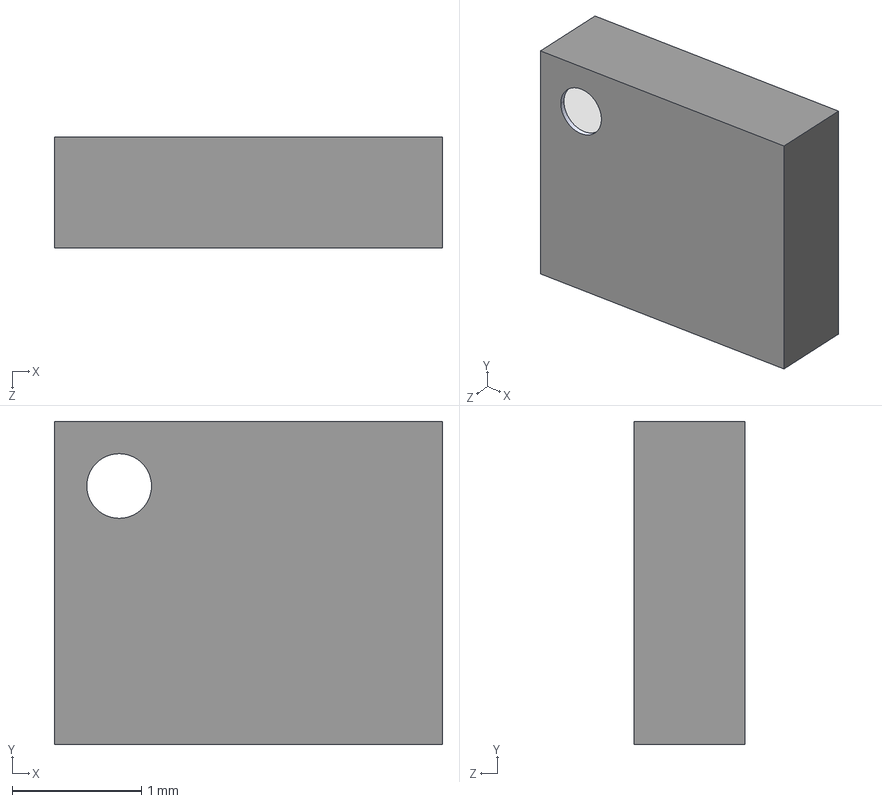
[picture p111: CAD file, 2018-07-22]
Kicad/3d/QFN_DFN/LGA 3x2d5.STEP
3.00 x 2.50 x 0.86 mm
