Kreyl/Libs/Kicad/3d/Resistors/R_0402.step

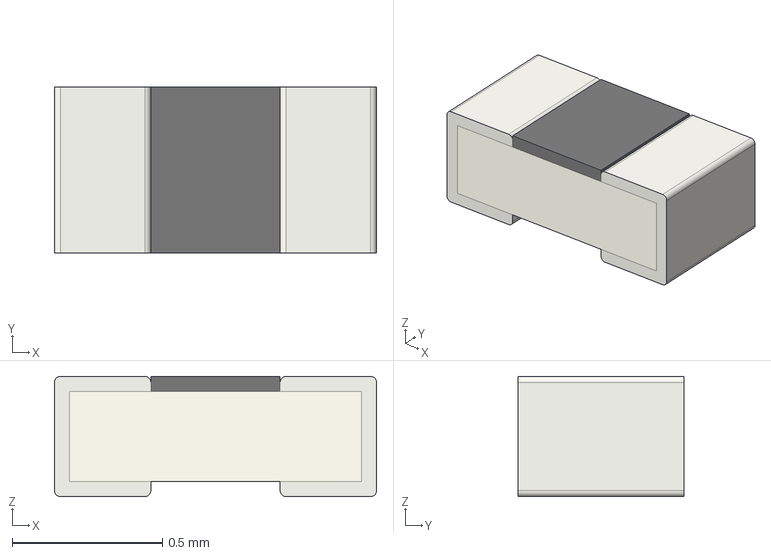
[picture p112: CAD file, 2018-02-26]
Kicad/3d/Resistors/R_0402.step
1.07 x 0.55 x 0.4 mm
