Kreyl/Libs/Kicad/3d/SO_DIL_TSSOP/SSOP24_150_0635.STEP

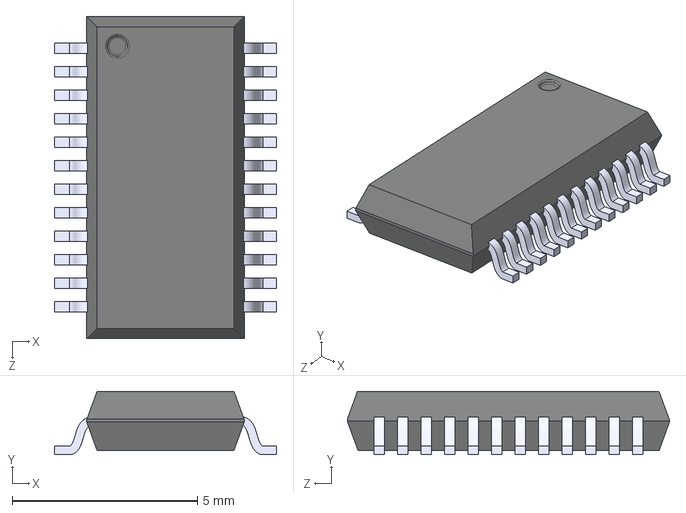
[picture p113: CAD file, 2019-04-02]
Kicad/3d/SO_DIL_TSSOP/SSOP24_150_0635.STEP
6.00 x 1.72 x 8.70 mm
