Kreyl/Libs/Kicad/3d/SOT/SOT-23.step

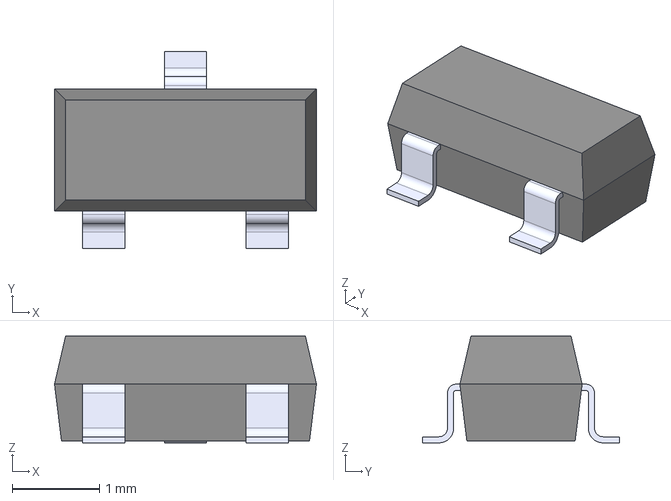
[picture p114: CAD file, 2018-02-26]
Kicad/3d/SOT/SOT-23.step
3.00 x 2.25 x 1.22 mm
