Kreyl/Libs/Kicad/3d/BtnsSwitches/CUS-14TB.stp

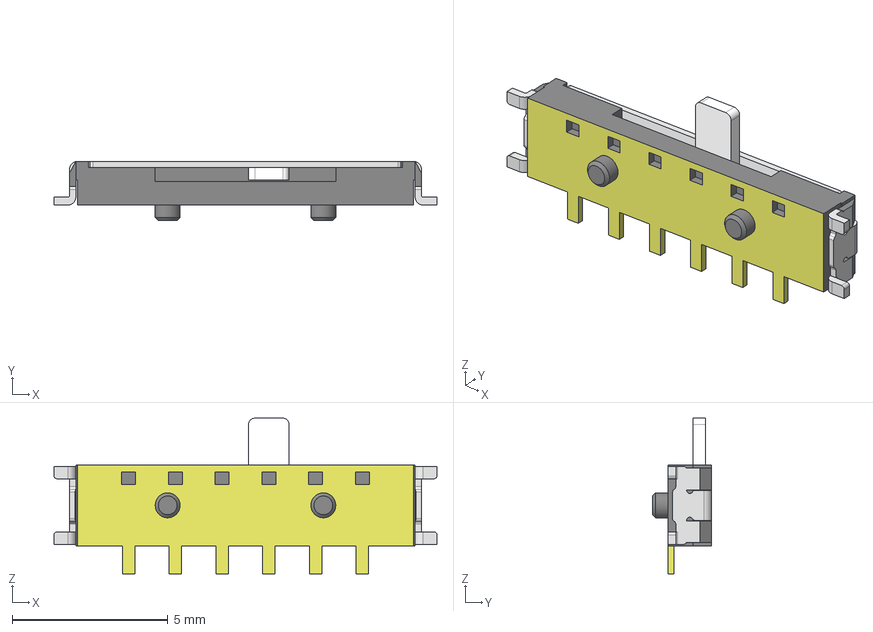
[picture p115: CAD file, 2020-12-03]
Kicad/3d/BtnsSwitches/CUS-14TB.stp
12.3 x 1.90 x 5.00 mm
_CUS-14-body
_CUS-14-slider
