Kreyl/Libs/Kicad/3d/Capacitors/CAPTH220-16.stp

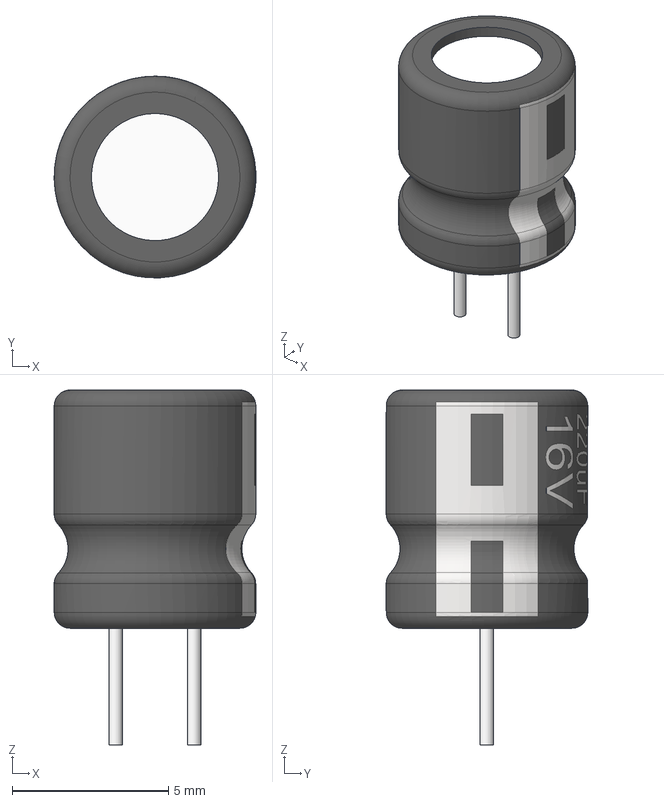
[picture p116: CAD file, 2018-06-03]
Kicad/3d/Capacitors/CAPTH220-16.stp
6.45 x 6.45 x 11.4 mm
