Kreyl/Libs/Kicad/3d/Connectors/Conn_PBS3R.STEP

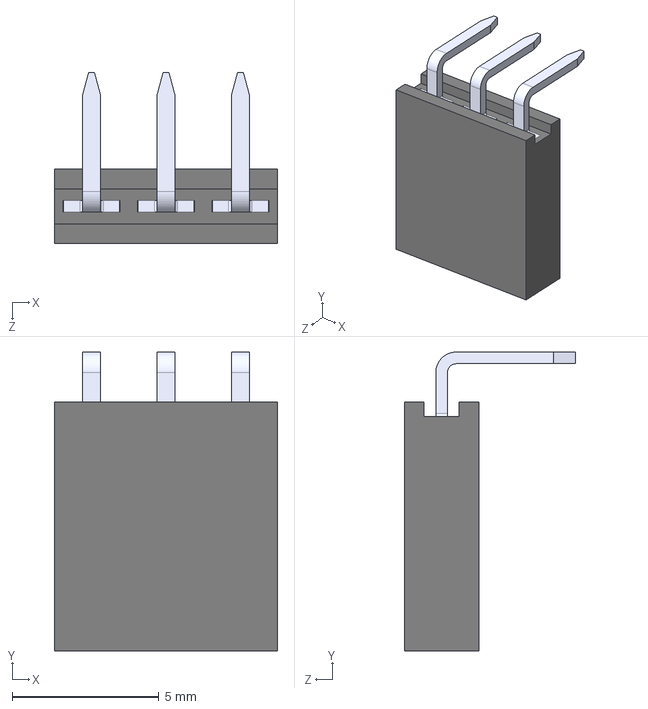
[picture p117: CAD file, 2024-08-31]
Kicad/3d/Connectors/Conn_PBS3R.STEP
7.62 x 10.2 x 5.84 mm
