Kreyl/Libs/Kicad/3d/Connectors/IDC/DS1013-26S (IDC-26MS CONNFLY).stp

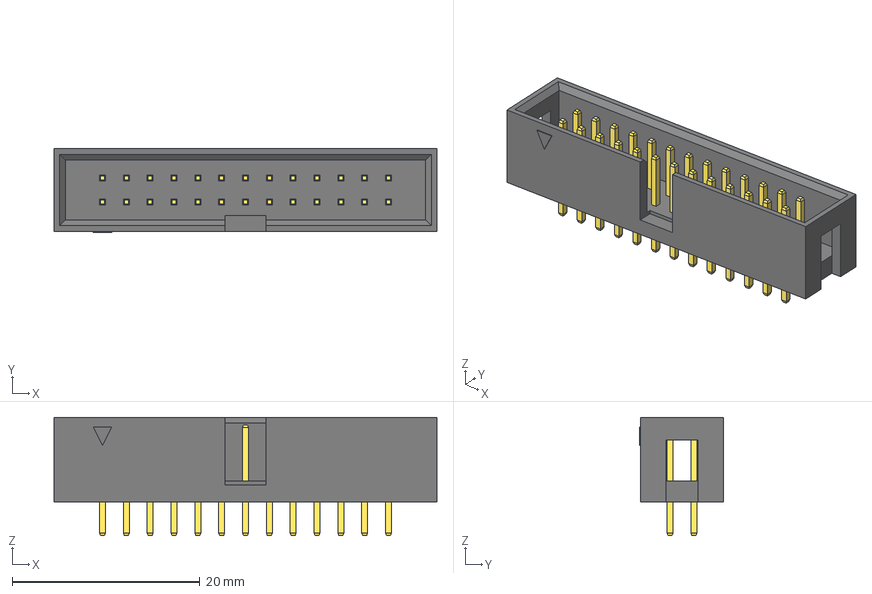
[picture p118: CAD file, 2019-01-16]
Kicad/3d/Connectors/IDC/DS1013-26S (IDC-26MS CONNFLY).stp
40.8 x 8.90 x 12.6 mm
