Kreyl/Libs/Kicad/3d/Diodes/SOD323F.step

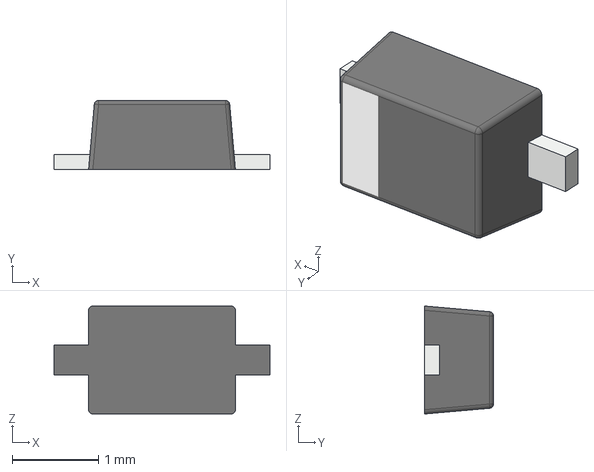
[picture p119: CAD file, 2018-03-07]
Kicad/3d/Diodes/SOD323F.step
2.50 x 0.8 x 1.25 mm
