Kreyl/Libs/Kicad/3d/Inductors/DLW5ATN.STEP

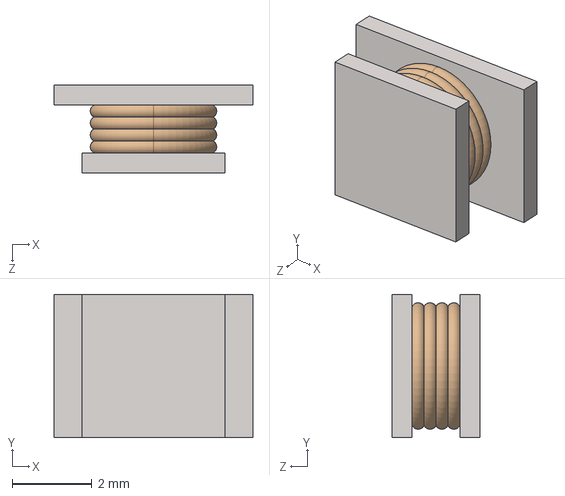
[picture p120: CAD file, 2020-02-28]
Kicad/3d/Inductors/DLW5ATN.STEP
5.00 x 3.60 x 2.20 mm
