Kreyl/Libs/Kicad/3d/Installation/Vibro12x3d5.STEP

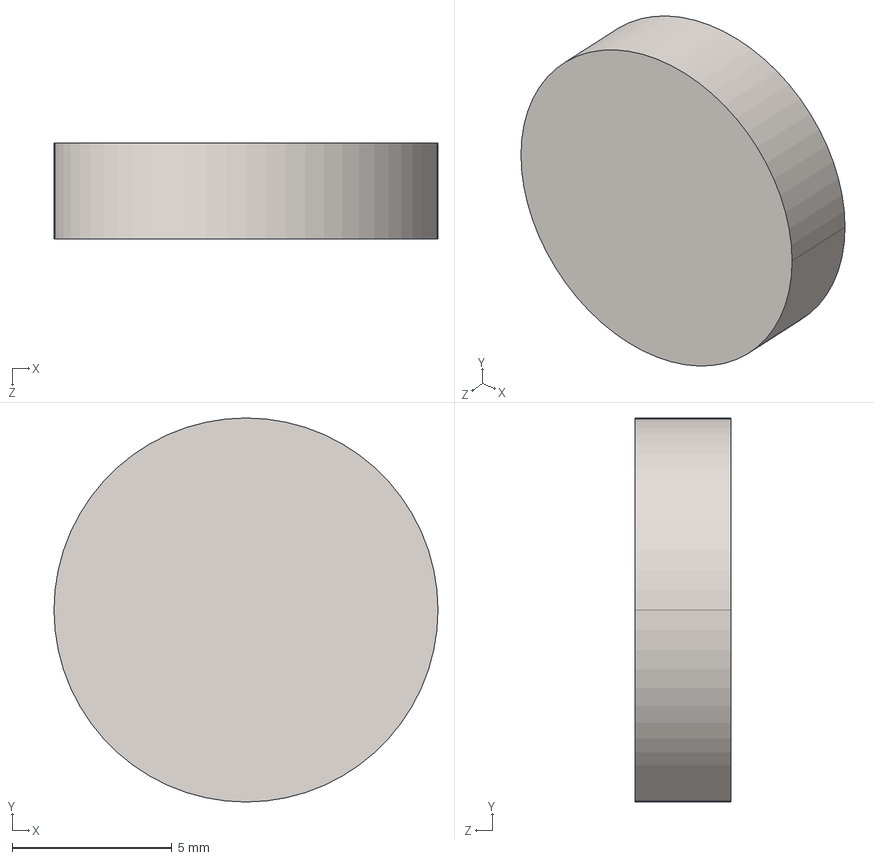
[picture p121: CAD file, 2019-02-19]
Kicad/3d/Installation/Vibro12x3d5.STEP
12.0 x 12.0 x 3.00 mm
