Kreyl/Libs/Kicad/3d/LED/Cree_XML.step

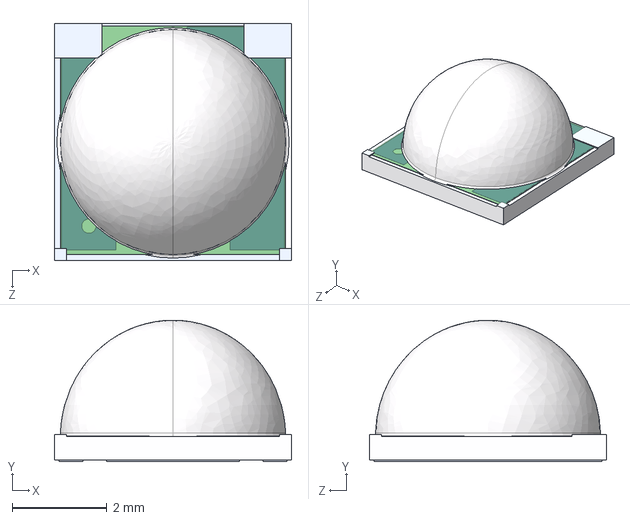
[picture p122: CAD file, 2019-10-04]
Kicad/3d/LED/Cree_XML.step
5.00 x 2.99 x 5.00 mm
