Kreyl/Libs/Kicad/3d/QFN_DFN/MFI.STEP

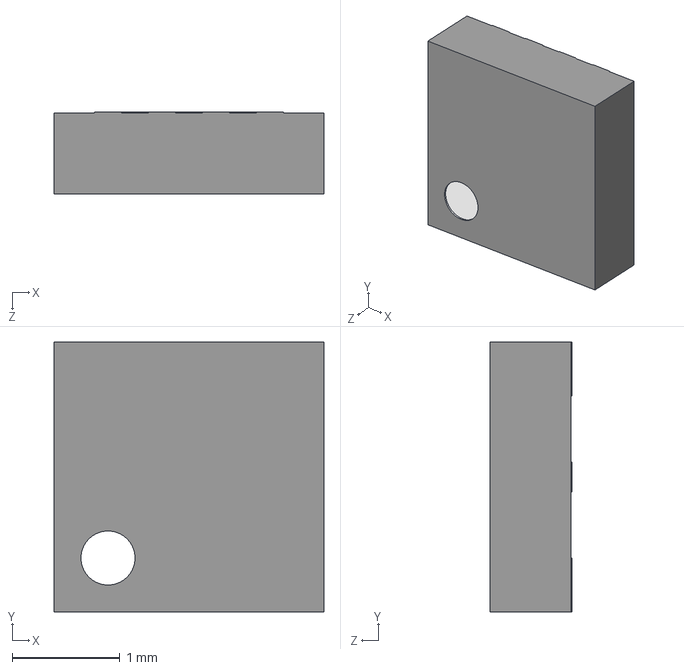
[picture p123: CAD file, 2018-03-27]
Kicad/3d/QFN_DFN/MFI.STEP
2.50 x 2.50 x 0.76 mm
