Kreyl/Libs/Kicad/3d/Resistors/R_0603.step

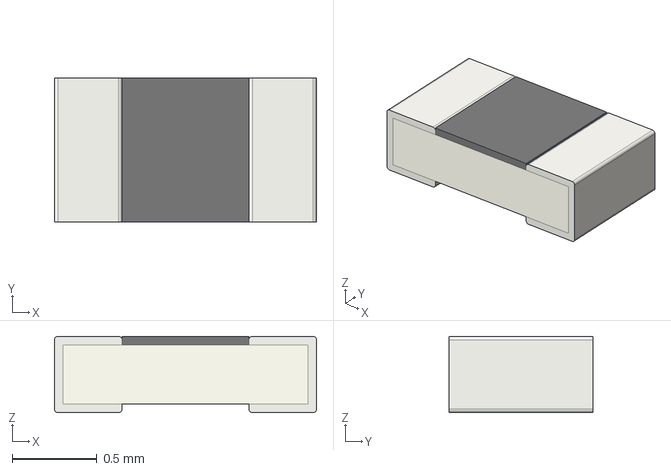
[picture p124: CAD file, 2018-02-26]
Kicad/3d/Resistors/R_0603.step
1.55 x 0.85 x 0.45 mm
