Kreyl/Libs/Kicad/3d/SO_DIL_TSSOP/SO14_150.stp

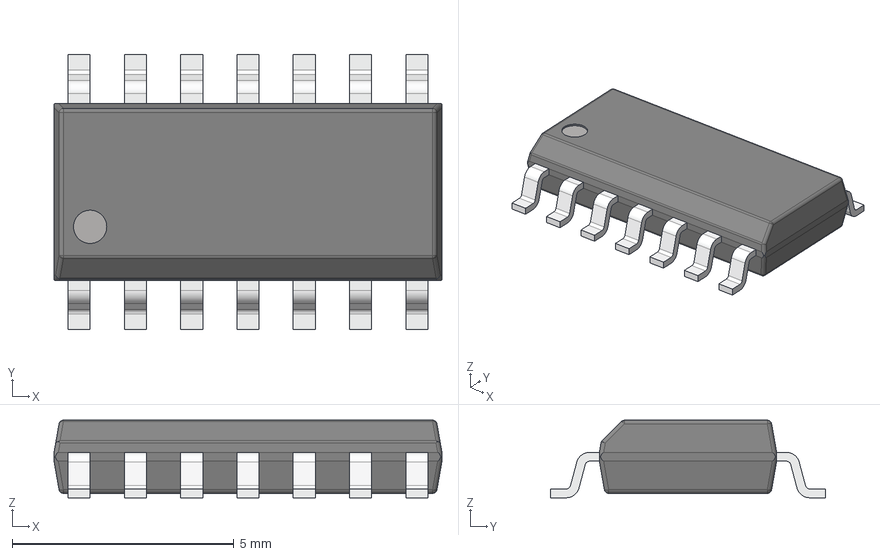
[picture p125: CAD file, 2019-02-19]
Kicad/3d/SO_DIL_TSSOP/SO14_150.stp
8.75 x 6.20 x 1.75 mm
