Kreyl/Libs/Kicad/3d/BtnsSwitches/SWT9-1.step

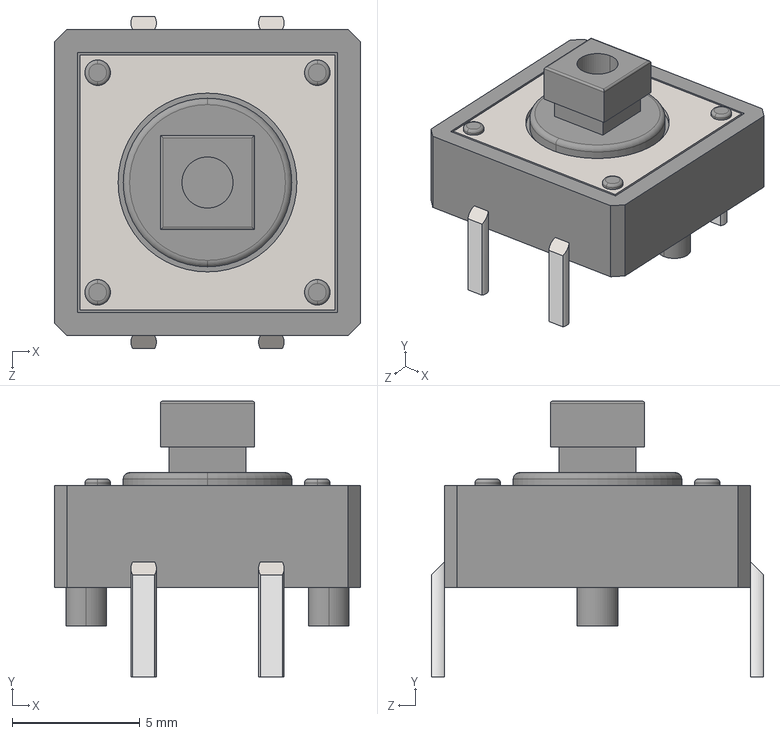
[picture p126: CAD file, 2019-11-08]
Kicad/3d/BtnsSwitches/SWT9-1.step
12.0 x 10.8 x 13.0 mm
