Kreyl/Libs/Kicad/3d/Connectors/IDC/DS1013-50S (IDC-50MS CONNFLY).step

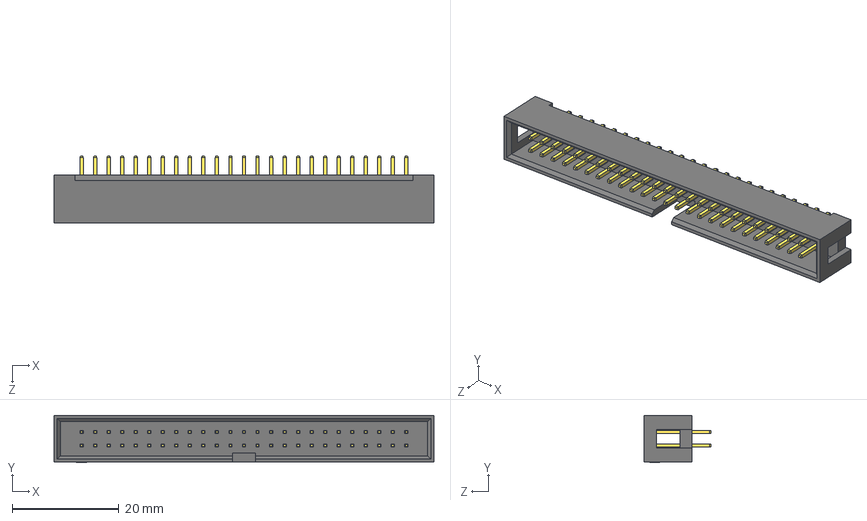
[picture p127: CAD file, 2019-01-16]
Kicad/3d/Connectors/IDC/DS1013-50S (IDC-50MS CONNFLY).step
71.3 x 8.90 x 12.6 mm
