Kreyl/Libs/Kicad/3d/Connectors/PBD-12R.step

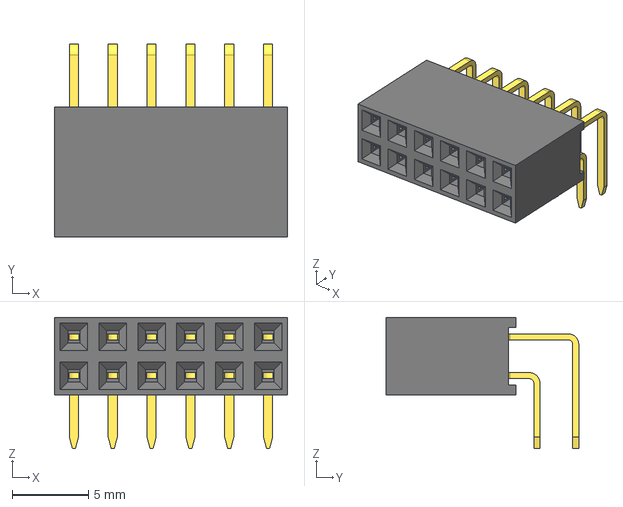
[picture p128: CAD file, 2024-06-08]
Kicad/3d/Connectors/PBD-12R.step
15.2 x 12.6 x 8.58 mm
