Kreyl/Libs/Kicad/3d/Inductors/FDV0530.STEP

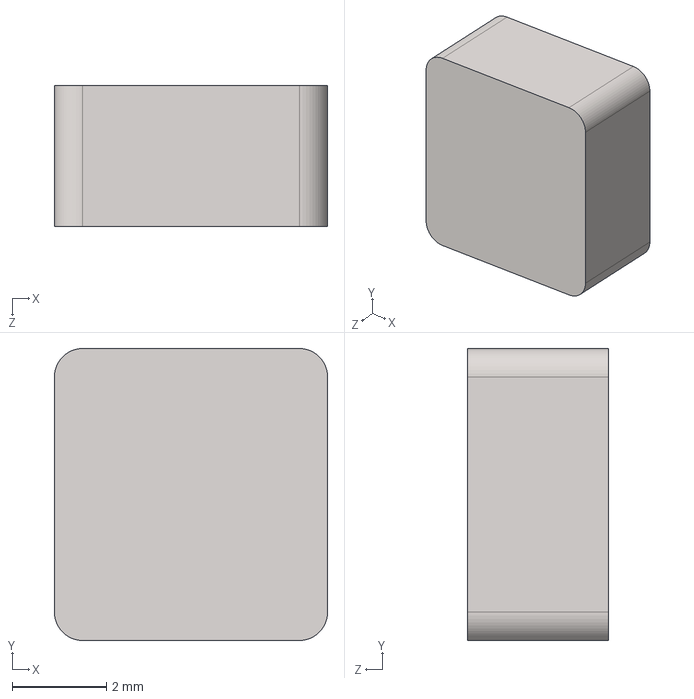
[picture p129: CAD file, 2020-02-28]
Kicad/3d/Inductors/FDV0530.STEP
5.80 x 6.20 x 3.00 mm
