Kreyl/Libs/Kicad/3d/Installation/BatteryHolder 1x18650.STEP

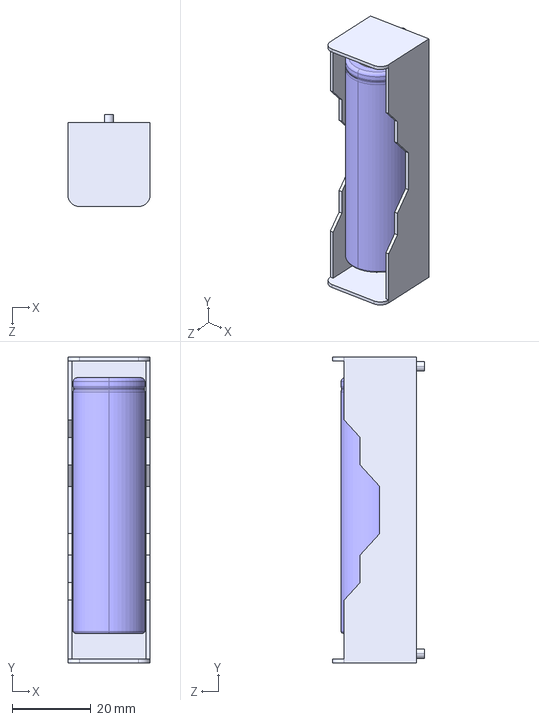
[picture p130: CAD file, 2019-02-19]
Kicad/3d/Installation/BatteryHolder 1x18650.STEP
20.9 x 77.7 x 23.4 mm
BatteryHolder 1x18650
Battery 18650_hr_Domyslna
