Kreyl/Libs/Kicad/3d/LED/Cree_XPE.stp

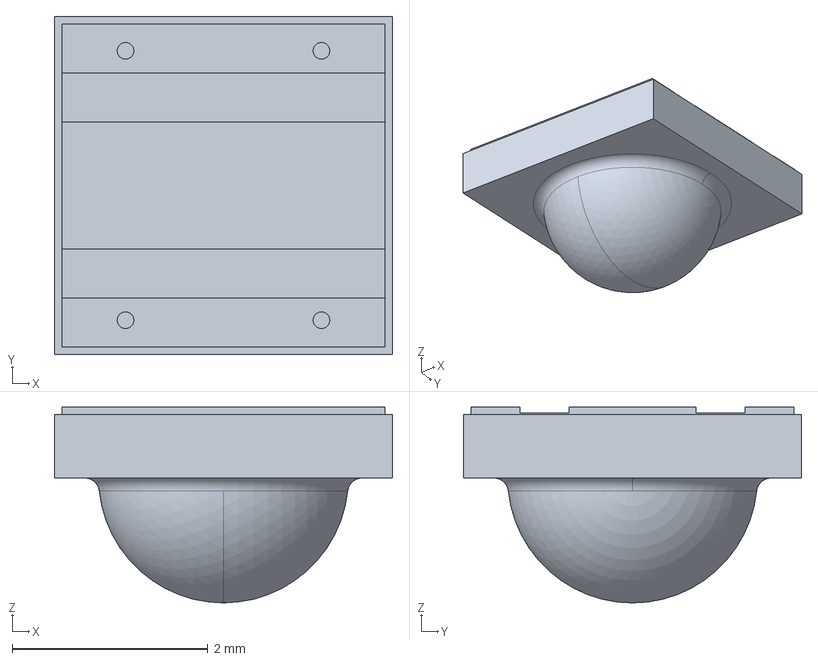
[picture p131: CAD file, 2019-10-04]
Kicad/3d/LED/Cree_XPE.stp
3.45 x 3.45 x 2.00 mm
