Kreyl/Libs/Kicad/3d/QFN_DFN/DFN-8-1EP_6x5mm_Pitch1.27mm.step

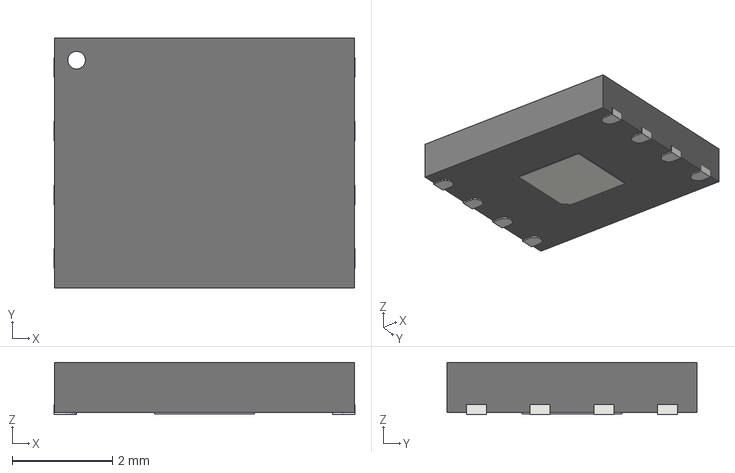
[picture p132: CAD file, 2018-02-26]
Kicad/3d/QFN_DFN/DFN-8-1EP_6x5mm_Pitch1.27mm.step
6.00 x 4.97 x 1.04 mm
