Kreyl/Libs/Kicad/3d/Resistors/R_1812.step

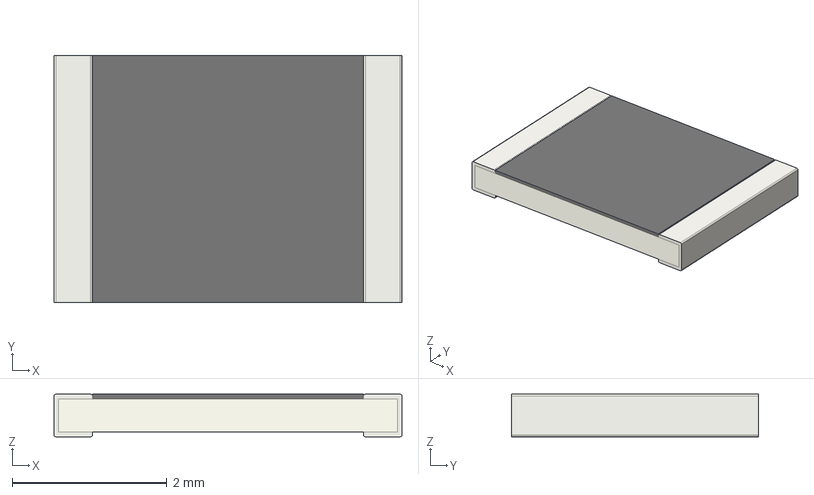
[picture p133: CAD file, 2018-02-26]
Kicad/3d/Resistors/R_1812.step
4.50 x 3.20 x 0.55 mm
