Kreyl/Libs/Kicad/3d/SO_DIL_TSSOP/SO16_150.stp

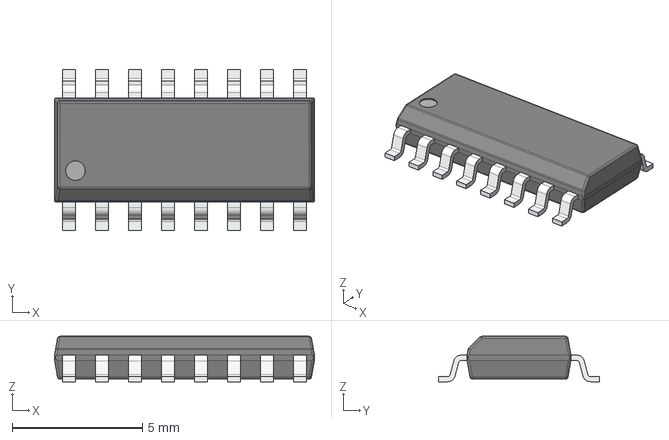
[picture p134: CAD file, 2019-02-19]
Kicad/3d/SO_DIL_TSSOP/SO16_150.stp
10.0 x 6.20 x 1.75 mm
