Kreyl/Libs/Kicad/3d/BtnsSwitches/Button IT1198.STEP

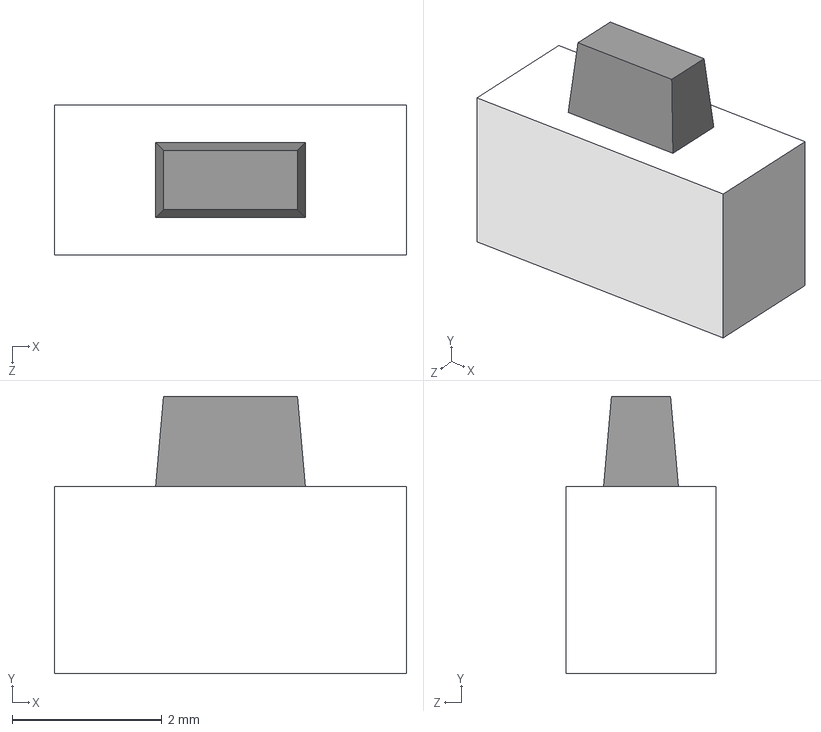
[picture p135: CAD file, 2018-12-30]
Kicad/3d/BtnsSwitches/Button IT1198.STEP
4.70 x 3.70 x 2.00 mm
