Kreyl/Libs/Kicad/3d/Capacitors/CAPTH220-25.stp

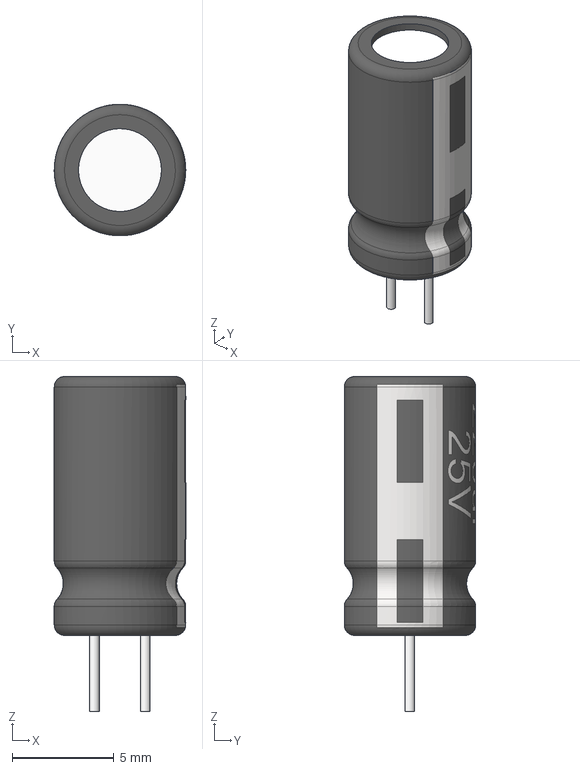
[picture p136: CAD file, 2018-06-03]
Kicad/3d/Capacitors/CAPTH220-25.stp
6.45 x 6.45 x 16.4 mm
