Kreyl/Libs/Kicad/3d/Connectors/IDC/DS1013-14S (IDC-14MS CONNFLY).stp

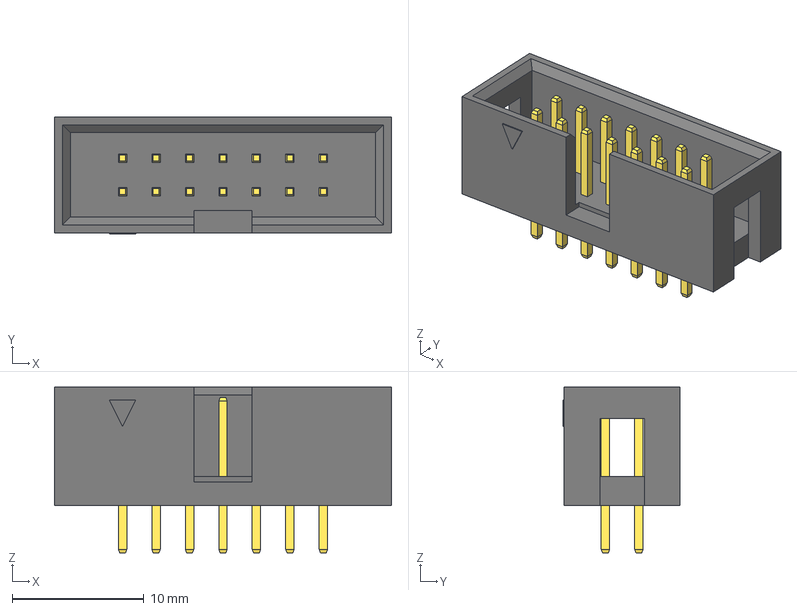
[picture p137: CAD file, 2019-01-16]
Kicad/3d/Connectors/IDC/DS1013-14S (IDC-14MS CONNFLY).stp
25.6 x 8.90 x 12.6 mm
