Kreyl/Libs/Kicad/3d/Inductors/SRN3015.step

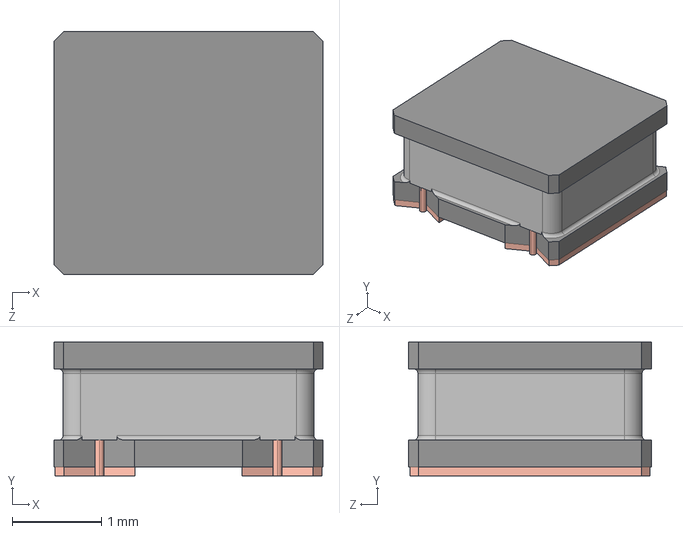
[picture p138: CAD file, 2019-09-05]
Kicad/3d/Inductors/SRN3015.step
3.02 x 1.50 x 2.72 mm
