Kreyl/Libs/Kicad/3d/Installation/BatteryHolder CH7410.STEP

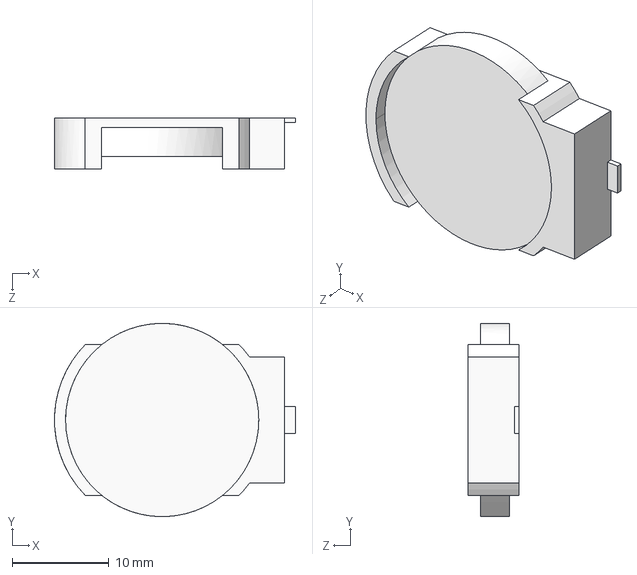
[picture p139: CAD file, 2018-06-03]
Kicad/3d/Installation/BatteryHolder CH7410.STEP
24.9 x 20.0 x 5.30 mm
