Kreyl/Libs/Kicad/3d/LED/LED_0606.STEP

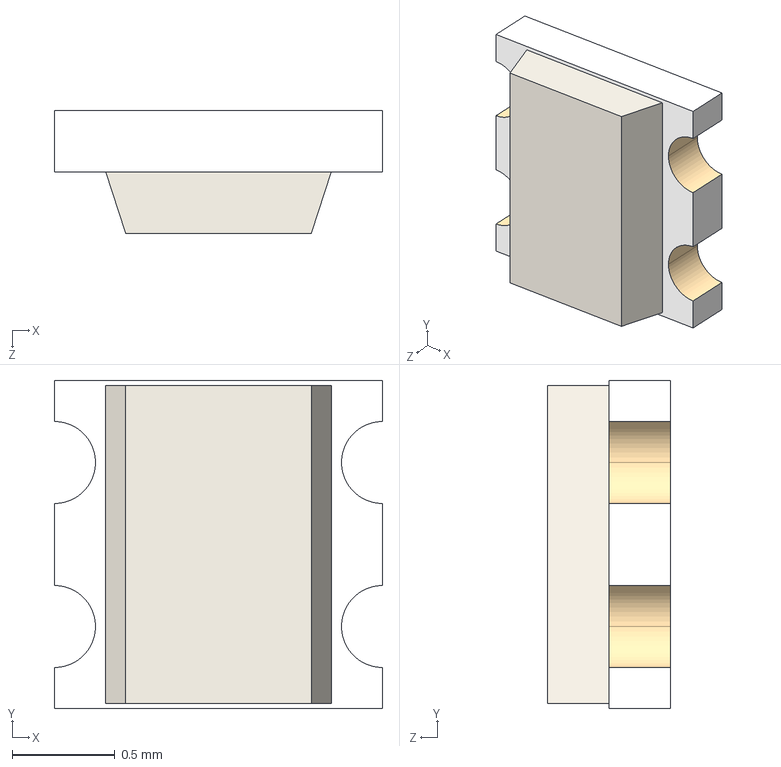
[picture p140: CAD file, 2019-04-02]
Kicad/3d/LED/LED_0606.STEP
1.60 x 1.60 x 0.6 mm
