Kreyl/Libs/Kicad/3d/QFN_DFN/QFN-44-1EP_8x8mm_Pitch0.65mm.step

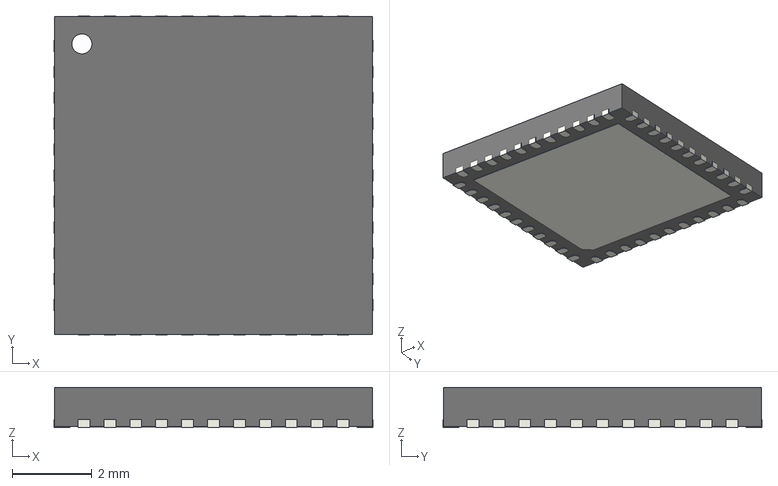
[picture p141: CAD file, 2018-02-26]
Kicad/3d/QFN_DFN/QFN-44-1EP_8x8mm_Pitch0.65mm.step
8.00 x 8.00 x 1.01 mm
