Kreyl/Libs/Kicad/3d/Resistors/R_0201.step

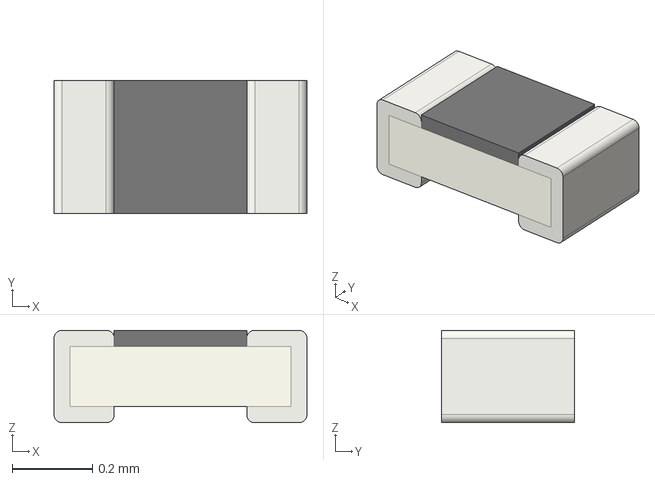
[picture p142: CAD file, 2018-02-26]
Kicad/3d/Resistors/R_0201.step
0.63 x 0.33 x 0.23 mm
