Kreyl/Libs/Kicad/3d/SO_DIL_TSSOP/TDSON-8.STEP

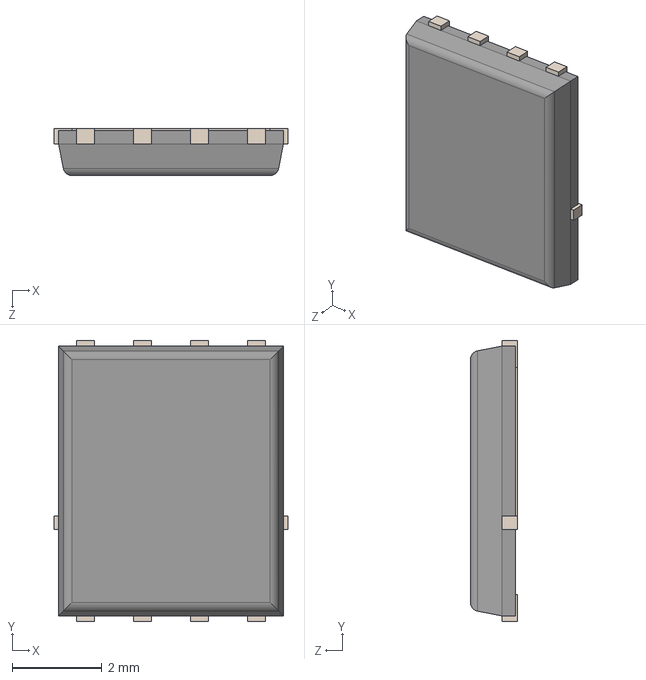
[picture p143: CAD file, 2018-07-22]
Kicad/3d/SO_DIL_TSSOP/TDSON-8.STEP
5.20 x 6.25 x 1.05 mm
