Kreyl/Libs/Kicad/3d/BtnsSwitches/DIP Switch 8 positions SMD.stp

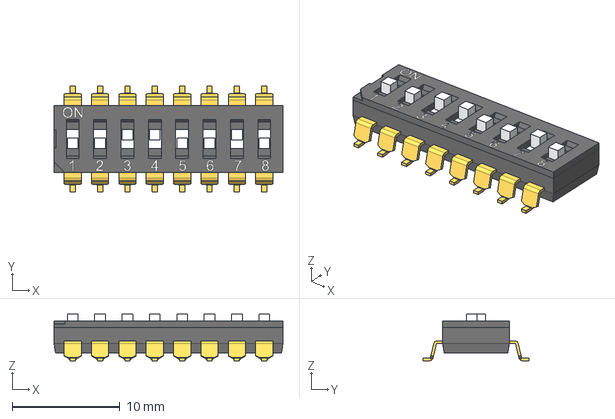
[picture p144: CAD file, 2018-09-26]
Kicad/3d/BtnsSwitches/DIP Switch 8 positions SMD.stp
21.3 x 9.80 x 4.32 mm
