Kreyl/Libs/Kicad/3d/Capacitors/C_2225.step

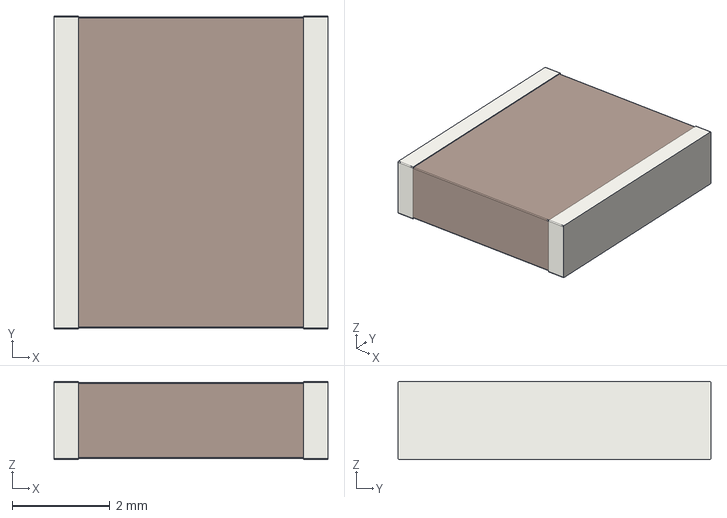
[picture p145: CAD file, 2018-02-26]
Kicad/3d/Capacitors/C_2225.step
5.60 x 6.40 x 1.60 mm
