Kreyl/Libs/Kicad/3d/Connectors/IDC/DS1013-20S (IDC-20MS CONNFLY).stp

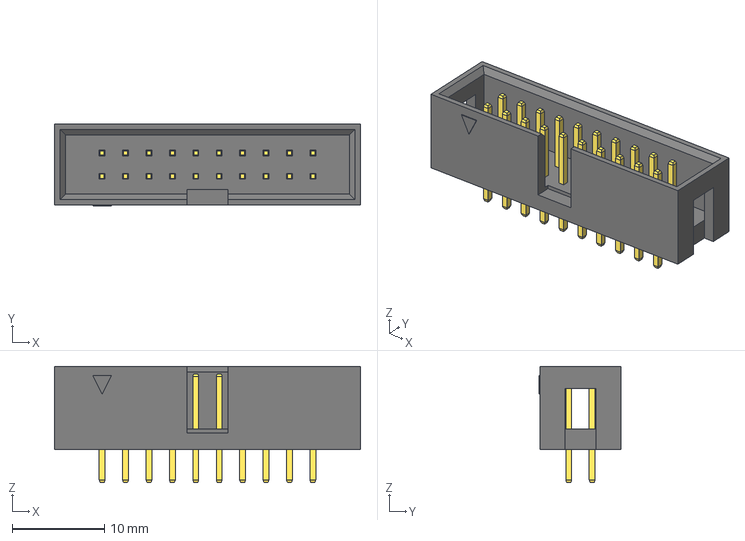
[picture p146: CAD file, 2019-01-16]
Kicad/3d/Connectors/IDC/DS1013-20S (IDC-20MS CONNFLY).stp
33.2 x 8.90 x 12.6 mm
