Kreyl/Libs/Kicad/3d/Connectors/PBS-4R.step

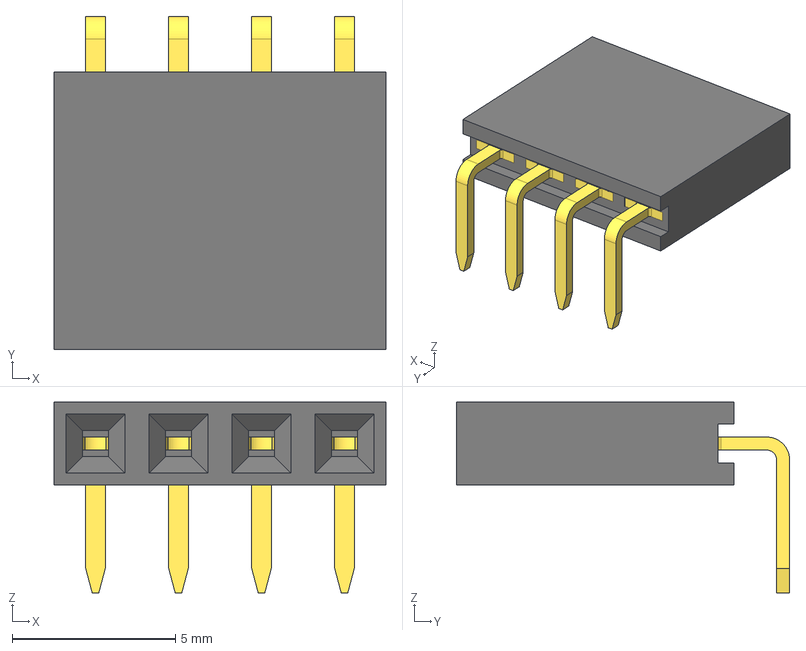
[picture p147: CAD file, 2024-06-08]
Kicad/3d/Connectors/PBS-4R.step
10.2 x 10.2 x 5.84 mm
