Kreyl/Libs/(list of files, cad)

Other CAD files:
Kicad/3d/Capacitors/CAPTH1000-16.stp
Kicad/3d/Connectors/PBS-3R.step
Kicad/3d/BtnsSwitches/1P2T_8d6x3d6.STEP
Kicad/3d/BtnsSwitches/1P2T_8d7x4d7.STEP
Kicad/3d/BtnsSwitches/Button 4x4 1187u.STEP
Kicad/3d/BtnsSwitches/Button 6x6.stp
Kicad/3d/BtnsSwitches/Button 6x6DIP.STEP
Kicad/3d/BtnsSwitches/Switch 1P3T.STEP
Kicad/3d/BtnsSwitches/Switch KLS7-SS03-12D02.STEP
Kicad/3d/BtnsSwitches/Switch LKLS7.STEP
Kicad/3d/BtnsSwitches/Switch SS12F21G5-G.STEP
Kicad/3d/BtnsSwitches/Switch SS9.STEP
Kicad/3d/BtnsSwitches/Tortsevaya_knopka_K5-1624SA-01.sldprt
Kicad/3d/Capacitors/C_0201.step
Kicad/3d/Capacitors/C_0402.step
Kicad/3d/Capacitors/C_0603.step
Kicad/3d/Capacitors/C_0805.step
Kicad/3d/Capacitors/C_1206.step
Kicad/3d/Capacitors/C_1210.step
Kicad/3d/Capacitors/C_1812.step
Kicad/3d/Capacitors/C_1825.step
Kicad/3d/Capacitors/C_2220.step
Kicad/3d/Capacitors/D8P3.5H11.5LD0.6.stp
Kicad/3d/Connectors/1054500101.stp
Kicad/3d/Connectors/614105150721 (rev1).stp
Kicad/3d/Connectors/BNC_73100-0131.STEP
Kicad/3d/Connectors/Conn_Audio_PJ320A.STEP
Kicad/3d/Connectors/Conn_BLS2_7R.STEP
Kicad/3d/Connectors/Conn_FFC_8x0d5.stp
Kicad/3d/Connectors/Conn_FPC_0d5x14.stp
Kicad/3d/Connectors/Conn_FPC_0d5x20.stp
Kicad/3d/Connectors/Conn_MicroSD_TFWF1.STEP
Kicad/3d/Connectors/Conn_PBS2.STEP
Kicad/3d/Connectors/Conn_PBS3.STEP
Kicad/3d/Connectors/Conn_PBS4R.STEP
Kicad/3d/Connectors/Conn_PBS8.STEP
Kicad/3d/Connectors/Conn_PH-2.0_10P_TOP.stp
Kicad/3d/Connectors/Conn_PH-2.0_11P_TOP.stp
Kicad/3d/Connectors/Conn_PH-2.0_12P_TOP.stp
Kicad/3d/Connectors/Conn_PH-2.0_13P_TOP.stp
Kicad/3d/Connectors/Conn_PH-2.0_14P_TOP.stp
Kicad/3d/Connectors/Conn_PH-2.0_15P_TOP.stp
Kicad/3d/Connectors/Conn_PH-2.0_16P_TOP.stp
Kicad/3d/Connectors/Conn_PH-2.0_2P_TOP.stp
Kicad/3d/Connectors/Conn_PH-2.0_3P_TOP.stp
Kicad/3d/Connectors/Conn_PH-2.0_4P_TOP.stp
Kicad/3d/Connectors/Conn_PH-2.0_5P_TOP.stp
Kicad/3d/Connectors/Conn_PH-2.0_6P_TOP.stp
Kicad/3d/Connectors/Conn_PH-2.0_7P_TOP.stp
Kicad/3d/Connectors/Conn_PH-2.0_8P_TOP.stp
Kicad/3d/Connectors/Conn_PH-2.0_9P_TOP.stp
Kicad/3d/Connectors/Conn_PLS-1.STEP
Kicad/3d/Connectors/Conn_PLS-2.STEP
Kicad/3d/Connectors/Conn_PLS-3.STEP
Kicad/3d/Connectors/Conn_PLS-6.STEP
Kicad/3d/Connectors/Conn_PLS2R.STEP
Kicad/3d/Connectors/Conn_PLS2_7.STEP
Kicad/3d/Connectors/Conn_W-02.STEP
Kicad/3d/Connectors/Conn_W-03_p2d54.STEP
Kicad/3d/Connectors/Conn_WB-02R(MW-2MR).STEP
Kicad/3d/Connectors/Conn_WB-03(MW-3M).STEP
Kicad/3d/Connectors/Conn_WB-04(MW-4M).STEP
Kicad/3d/Connectors/Conn_WB-04R.STEP
Kicad/3d/Connectors/Conn_WB-05(MW-5M).STEP
Kicad/3d/Connectors/Conn_WB-05R.STEP
Kicad/3d/Connectors/Conn_WB-06(MW-6M).STEP
Kicad/3d/Connectors/Conn_WB-08(MW-8M).STEP
Kicad/3d/Connectors/Conn_barrell.STEP
Kicad/3d/Connectors/DB9 - 203-09SCKKBE.STEP
Kicad/3d/Connectors/IDC/DS1013-16S (IDC-16MS CONNFLY).stp
Kicad/3d/Connectors/IDC/DS1013-34S (IDC-34MS CONNFLY).step
Kicad/3d/Connectors/IDC/DS1013-6S (IDC-6MS CONNFLY).stp
Kicad/3d/Connectors/Minifit_6R.stp
Kicad/3d/Connectors/PLS6_NoHole.STEP
Kicad/3d/Connectors/SM11B-SRSS-TB.STEP
Kicad/3d/Connectors/SM15B-SRSS-TB.STEP
Kicad/3d/Connectors/TJ3-4P4C.STEP
Kicad/3d/Connectors/TJ3-6P6C.STEP
Kicad/3d/Connectors/TJ3-8P8C.STEP
Kicad/3d/Connectors/USB-AFx2.STEP
Kicad/3d/Connectors/USBC_10PF-074.STEP
Kicad/3d/Connectors/USBC_16PF-076.STEP
Kicad/3d/Connectors/USBC_24PF-009.STEP
Kicad/3d/Connectors/USB_B.stp
Kicad/3d/Connectors/USB_Vert.step
Kicad/3d/Connectors/molex474910001.stp
Kicad/3d/Connectors/molex_1050170001.STEP
Kicad/3d/Connectors/uUsb-5P-H63.stp
Kicad/3d/Inductors/IHLP5050CE (0.68-10uH).STEP
Kicad/3d/Inductors/Ind252012.STEP
Kicad/3d/Inductors/Ind4x4x1d8.stp
Kicad/3d/Inductors/Ind_4x4.STEP
Kicad/3d/Inductors/LQH43C.step
Kicad/3d/Inductors/SDR0604.STEP
Kicad/3d/Inductors/SDR0805.STEP
Kicad/3d/Inductors/SRN5040.STEP
Kicad/3d/Installation/BREADBOARD_MINI.stp
Kicad/3d/Installation/BatteryHolder 1xAA.STEP
Kicad/3d/Installation/BatteryHolder 4xAAA.STEP
Kicad/3d/Installation/BuzzerHP14A.STEP
Kicad/3d/Installation/BuzzerHP17A.STEP
Kicad/3d/Installation/Speaker D9d5x5.STEP
Kicad/3d/LED/D_0603_blue.step
Kicad/3d/LED/D_0603_green.step
Kicad/3d/LED/D_0603_red.step
Kicad/3d/LED/D_0603_yellow.step
Kicad/3d/LED/LED 0603.STEP
Kicad/3d/LED/LED 5mm blue TH.STEP
Kicad/3d/LED/LED 5mm green TH.STEP
Kicad/3d/LED/LED 5mm orange TH.STEP
Kicad/3d/LED/LED 5mm red TH.STEP
Kicad/3d/LED/LED 5mm white TH.STEP
Kicad/3d/LED/LED 5mm yellow TH.STEP
Kicad/3d/LED/LED10mmR.STEP
Kicad/3d/LED/LEDR.STEP
Kicad/3d/LED/LED_0805.STEP
Kicad/3d/LED/LED_5050.STEP
Kicad/3d/LED/LED_5050old.STEP
Kicad/3d/LED/Surface Mount Chip LED 3.2x1.6mm.stp
Kicad/3d/LED/WS2812B_5050.step
Kicad/3d/LED/WS2812W_5050.step
Kicad/3d/QFN_DFN/DFN-10-1EP_2x3mm_Pitch0.5mm.step
Kicad/3d/QFN_DFN/DFN-10-1EP_3x3mm_Pitch0.5mm_S-PVSON-N10.step
Kicad/3d/QFN_DFN/DFN-12-4x3mm.fcstd
Kicad/3d/QFN_DFN/DFN-12-4x3mm.step
Kicad/3d/QFN_DFN/DFN-12-4x4mm.fcstd
Kicad/3d/QFN_DFN/DFN-12-4x4mm.step
Kicad/3d/QFN_DFN/DFN-14-4x3mm.fcstd
Kicad/3d/QFN_DFN/DFN-14-4x3mm.step
Kicad/3d/QFN_DFN/DFN-16-5x3mm.fcstd
Kicad/3d/QFN_DFN/DFN-16-5x3mm.step
Kicad/3d/QFN_DFN/DFN-16-5x5mm.fcstd
Kicad/3d/QFN_DFN/DFN-16-5x5mm.step
Kicad/3d/QFN_DFN/DFN-18-5x3mm.fcstd
Kicad/3d/QFN_DFN/DFN-18-5x3mm.step
Kicad/3d/QFN_DFN/DFN-18-5x4mm.fcstd
Kicad/3d/QFN_DFN/DFN-18-5x4mm.step
Kicad/3d/QFN_DFN/DFN-6-1EP_2x2mm_Pitch0.65mm.step
Kicad/3d/QFN_DFN/DFN-6-2x3mm.fcstd
Kicad/3d/QFN_DFN/DFN-6-2x3mm.step
Kicad/3d/QFN_DFN/DFN-6-3x3mm_humidity.fcstd
Kicad/3d/QFN_DFN/DFN-6-3x3mm_humidity.step
Kicad/3d/QFN_DFN/DFN-8-1EP_2x3mm_Pitch0.5mm.step
Kicad/3d/QFN_DFN/DFN-8-1EP_3x3mm_Pitch0.5mm.step
Kicad/3d/QFN_DFN/DFN-8-1EP_3x3mm_Pitch0.65mm.step
Kicad/3d/QFN_DFN/LGA-16_3x3mm_Pitch0.5mm.step
Kicad/3d/QFN_DFN/QFN-16-1EP_3x3mm_Pitch0.5mm.step
Kicad/3d/QFN_DFN/QFN-20-5x5mm.fcstd
Kicad/3d/QFN_DFN/QFN-20-5x5mm.step
Kicad/3d/QFN_DFN/QFN-24_4x4mm_Pitch0.5mm.step
Kicad/3d/QFN_DFN/QFN-28-1EP_6x6mm_Pitch0.65mm.STEP
Kicad/3d/QFN_DFN/QFN-32-1EP_5x5mm_Pitch0.5mm.step
Kicad/3d/QFN_DFN/QFN-32-7x7mm- EQ-1.step
Kicad/3d/QFN_DFN/QFN-40-1EP_6x6mm_Pitch0.5mm.step
Kicad/3d/QFN_DFN/QFN-64-1EP_9x9mm_Pitch0.5mm.step
Kicad/3d/QFN_DFN/RPVQFN-N20.STEP
Kicad/3d/Resistors/R_1218.step
