Kreyl/Libs/kl_lib/Sound/mp3/real/hufftabs.c

/* ***** BEGIN LICENSE BLOCK *****
 * Version: RCSL 1.0/RPSL 1.0
 *
 * Portions Copyright (c) 1995-2002 RealNetworks, Inc. All Rights Reserved.
 *
 * The contents of this file, and the files included with this file, are
 * subject to the current version of the RealNetworks Public Source License
 * Version 1.0 (the "RPSL") available at
 * http://www.helixcommunity.org/content/rpsl unless you have licensed
 * the file under the RealNetworks Community Source License Version 1.0
 * (the "RCSL") available at http://www.helixcommunity.org/content/rcsl,
 * in which case the RCSL will apply. You may also obtain the license terms
 * directly from RealNetworks.  You may not use this file except in
 * compliance with the RPSL or, if you have a valid RCSL with RealNetworks
 * applicable to this file, the RCSL.  Please see the applicable RPSL or
 * RCSL for the rights, obligations and limitations governing use of the
 * contents of the file.
 *
 * This file is part of the Helix DNA Technology. RealNetworks is the
 * developer of the Original Code and owns the copyrights in the portions
 * it created.
 *
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
 * Technology Compatibility Kit Test Suite(s) Location:
 *    http://www.helixcommunity.org/content/tck
 *
 * Contributor(s):
 *
 * ***** END LICENSE BLOCK ***** */

/**************************************************************************************
 * Fixed-point MP3 decoder
 * Jon Recker (jrecker@real.com), Ken Cooke (kenc@real.com)
 * June 2003
 *
 * hufftabs.c - compressed Huffman code tables
 **************************************************************************************/

#include "coder.h"

/* NOTE - regenerated tables to use shorts instead of ints
 *        (all needed data can fit in 16 bits - see below)
 *
 * format 0xABCD
 *  A = length of codeword
 *  B = y value
 *  C = x value
 *  D = number of sign bits (0, 1, or 2)
 *
 * to read a CW, the code reads maxbits from the stream (dep. on
 *   table index), but doesn't remove them from the bitstream reader
 * then it gets the correct CW by direct lookup into the table
 *   of length (2^maxbits) (more complicated for non-oneShot...)
 * for CW's with hlen < maxbits, there are multiple entries in the
 *   table (extra bits are don't cares)
 * the bitstream reader then "purges" (or removes) only the correct
 *   number of bits for the chosen CW
 *
 * entries starting with F are special: D (signbits) is maxbits,
 *   so the decoder always checks huffTableXX[0] first, gets the
 *   signbits, and reads that many bits from the bitstream
 *   (sometimes it takes > 1 read to get the value, so maxbits is
 *    can get updated by jumping to another value starting with 0xF)
 * entries starting with 0 are also special: A = hlen = 0, rest of
 *   value is an offset to jump higher in the table (for tables of
 *   type loopNoLinbits or loopLinbits)
 */

/* store Huffman codes as one big table plus table of offsets, since some platforms
 *   don't properly support table-of-tables (table of pointers to other const tables)
 */
const unsigned short huffTable[] = {
	/* huffTable01[9] */
	0xf003, 0x3112, 0x3101, 0x2011, 0x2011, 0x1000, 0x1000, 0x1000,
	0x1000,

	/* huffTable02[65] */
	0xf006, 0x6222, 0x6201, 0x5212, 0x5212, 0x5122, 0x5122, 0x5021,
	0x5021, 0x3112, 0x3112, 0x3112, 0x3112, 0x3112, 0x3112, 0x3112,
	0x3112, 0x3101, 0x3101, 0x3101, 0x3101, 0x3101, 0x3101, 0x3101,
	0x3101, 0x3011, 0x3011, 0x3011, 0x3011, 0x3011, 0x3011, 0x3011,
	0x3011, 0x1000, 0x1000, 0x1000, 0x1000, 0x1000, 0x1000, 0x1000,
	0x1000, 0x1000, 0x1000, 0x1000, 0x1000, 0x1000, 0x1000, 0x1000,
	0x1000, 0x1000, 0x1000, 0x1000, 0x1000, 0x1000, 0x1000, 0x1000,
	0x1000, 0x1000, 0x1000, 0x1000, 0x1000, 0x1000, 0x1000, 0x1000,
	0x1000,

	/* huffTable03[65] */
	0xf006, 0x6222, 0x6201, 0x5212, 0x5212, 0x5122, 0x5122, 0x5021,
	0x5021, 0x3011, 0x3011, 0x3011, 0x3011, 0x3011, 0x3011, 0x3011,
	0x3011, 0x2112, 0x2112, 0x2112, 0x2112, 0x2112, 0x2112, 0x2112,
	0x2112, 0x2112, 0x2112, 0x2112, 0x2112, 0x2112, 0x2112, 0x2112,
	0x2112, 0x2101, 0x2101, 0x2101, 0x2101, 0x2101, 0x2101, 0x2101,
	0x2101, 0x2101, 0x2101, 0x2101, 0x2101, 0x2101, 0x2101, 0x2101,
	0x2101, 0x2000, 0x2000, 0x2000, 0x2000, 0x2000, 0x2000, 0x2000,
	0x2000, 0x2000, 0x2000, 0x2000, 0x2000, 0x2000, 0x2000, 0x2000,
	0x2000,

	/* huffTable05[257] */
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
	0x10, 0x10, 0x10, 0x10, 0x10, 0x10, 0x10, 0x10,
	0x10, 0x10, 0x10, 0x10, 0x10, 0x10, 0x10, 0x10,
	/* table B */
	0x4f, 0x4e, 0x4d, 0x4c, 0x4b, 0x4a, 0x49, 0x48,
	0x47, 0x46, 0x45, 0x44, 0x43, 0x42, 0x41, 0x40,
};

const int quadTabOffset[2] = {0, 64};
const int quadTabMaxBits[2] = {6, 4};
