Kreyl/Libs/kl_lib/Neopixel/ws2812b.cpp

#include "ws2812b.h"

void NpxDmaDone(void *p, uint32_t flags) {
    ((Neopixels_t*)p)->OnDmaDone();
}

void Neopixels_t::Init() {
    // GPIO and DMA
    PinSetupAlterFunc(Params->PGpio, Params->Pin, omPushPull, pudNone, Params->Af);
    Params->ISpi.Setup(boMSB, cpolIdleLow, cphaFirstEdge, NPX_SPI_BITRATE, NPX_SPI_BITNUMBER);
    Params->ISpi.Enable();
    Params->ISpi.EnableTxDma();

    // Allocate memory
    Printf("LedCnt: %u\r", Params->NpxCnt);
    ClrBuf.resize(Params->NpxCnt);
//    Params->ISpi.PrintFreq();
    IBitBufSz = NPX_RST_BYTE_CNT + (Params->NpxCnt * (Params->Type == npxRGBW? 4 : 3) * NPX_BYTES_PER_BYTE);
    Printf("TotalByteCnt: %u\r", IBitBufSz);
    IBitBuf = (uint8_t*)malloc(IBitBufSz);
    memset(IBitBuf, 0, IBitBufSz); // Zero it all, to zero head and tail
#if WS2812B_V5 // Since 16-bit SPI utilized, DMA transaction size is half of buf-sz-in-bytes
    IBitBufSz = (IBitBufSz + 1) / 2;
#endif
    // ==== DMA ====
    PDma = dmaStreamAlloc(Params->DmaID, IRQ_PRIO_LOW, NpxDmaDone, this);
    dmaStreamSetPeripheral(PDma, &Params->ISpi.PSpi->DR);
    dmaStreamSetMode      (PDma, Params->DmaMode);
    TransmitDone = true;
}

static uint32_t ITable[256] = {
#if WS2812B_V2
        0x244992,0x264992,0x344992,0x364992,0xA44992,0xA64992,0xB44992,0xB64992,0x244D92,0x264D92,0x344D92,0x364D92,0xA44D92,0xA64D92,0xB44D92,0xB64D92,
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
        0xC888C88C,0xC88CC88C,0xC8C8C88C,0xC8CCC88C,0xCC88C88C,0xCC8CC88C,0xCCC8C88C,0xCCCCC88C,
        0x8888C8C8,0x888CC8C8,0x88C8C8C8,0x88CCC8C8,0x8C88C8C8,0x8C8CC8C8,0x8CC8C8C8,0x8CCCC8C8,
        0xC888C8C8,0xC88CC8C8,0xC8C8C8C8,0xC8CCC8C8,0xCC88C8C8,0xCC8CC8C8,0xCCC8C8C8,0xCCCCC8C8,
        0x8888C8CC,0x888CC8CC,0x88C8C8CC,0x88CCC8CC,0x8C88C8CC,0x8C8CC8CC,0x8CC8C8CC,0x8CCCC8CC,
        0xC888C8CC,0xC88CC8CC,0xC8C8C8CC,0xC8CCC8CC,0xCC88C8CC,0xCC8CC8CC,0xCCC8C8CC,0xCCCCC8CC,
        0x8888CC88,0x888CCC88,0x88C8CC88,0x88CCCC88,0x8C88CC88,0x8C8CCC88,0x8CC8CC88,0x8CCCCC88,
        0xC888CC88,0xC88CCC88,0xC8C8CC88,0xC8CCCC88,0xCC88CC88,0xCC8CCC88,0xCCC8CC88,0xCCCCCC88,
        0x8888CC8C,0x888CCC8C,0x88C8CC8C,0x88CCCC8C,0x8C88CC8C,0x8C8CCC8C,0x8CC8CC8C,0x8CCCCC8C,
        0xC888CC8C,0xC88CCC8C,0xC8C8CC8C,0xC8CCCC8C,0xCC88CC8C,0xCC8CCC8C,0xCCC8CC8C,0xCCCCCC8C,
        0x8888CCC8,0x888CCCC8,0x88C8CCC8,0x88CCCCC8,0x8C88CCC8,0x8C8CCCC8,0x8CC8CCC8,0x8CCCCCC8,
        0xC888CCC8,0xC88CCCC8,0xC8C8CCC8,0xC8CCCCC8,0xCC88CCC8,0xCC8CCCC8,0xCCC8CCC8,0xCCCCCCC8,
        0x8888CCCC,0x888CCCCC,0x88C8CCCC,0x88CCCCCC,0x8C88CCCC,0x8C8CCCCC,0x8CC8CCCC,0x8CCCCCCC,
        0xC888CCCC,0xC88CCCCC,0xC8C8CCCC,0xC8CCCCCC,0xCC88CCCC,0xCC8CCCCC,0xCCC8CCCC,0xCCCCCCCC,
#endif
};

void Neopixels_t::SetCurrentColors() {
    TransmitDone = false;
#if WS2812B_V2
    uint8_t *p = IBitBuf + (NPX_RST_BYTE_CNT / 2); // First and last words are zero to form reset
    // Fill bit buffer
    if(Params->Type == npxRGBW) {
        for(auto &Color : ClrBuf) {
            memcpy(p, &ITable[Color.G], 4);
            p += NPX_BYTES_PER_BYTE;
            memcpy(p, &ITable[Color.R], 4);
            p += NPX_BYTES_PER_BYTE;
            memcpy(p, &ITable[Color.B], 4);
            p += NPX_BYTES_PER_BYTE;
            memcpy(p, &ITable[Color.W], 4);
            p += NPX_BYTES_PER_BYTE;
        }
    }
    else {
        for(auto &Color : ClrBuf) {
            memcpy(p, &ITable[Color.G], 4);
            p += NPX_BYTES_PER_BYTE;
            memcpy(p, &ITable[Color.R], 4);
            p += NPX_BYTES_PER_BYTE;
            memcpy(p, &ITable[Color.B], 4);
            p += NPX_BYTES_PER_BYTE;
        }
    }
#else // WS2812B_V5 and SK6812SIDE
    // Fill bit buffer
    uint32_t *p = (uint32_t*)IBitBuf + (NPX_RST_BYTE_CNT / 8); // First and last words are zero to form reset
    if(Params->Type == npxRGBW) {
        for(auto &Color : ClrBuf) {
            *p++ = ITable[Color.G];
            *p++ = ITable[Color.R];
            *p++ = ITable[Color.B];
            *p++ = ITable[Color.W];
        }
    }
    else {
        for(auto &Color : ClrBuf) {
            *p++ = ITable[Color.G];
            *p++ = ITable[Color.R];
            *p++ = ITable[Color.B];
        }
    }
#endif
    // Start transmission
    dmaStreamDisable(PDma);
    dmaStreamSetMemory0(PDma, IBitBuf);
    dmaStreamSetTransactionSize(PDma, IBitBufSz);
    dmaStreamSetMode(PDma, Params->DmaMode);
    dmaStreamEnable(PDma);
}

void Neopixels_t::OnDmaDone() {
    TransmitDone = true;
    if(OnTransmitEnd) OnTransmitEnd();
}


void NpxPrintTable() {
#if WS2812B_V2

#else // WS2812B_V5 and SK6812SIDE
    for(uint32_t i=0x00; i<=0xFF; i++) {
        uint32_t w = 0;
        int Shift = 24;
        for(int n=0; n<4; n++) {
            uint32_t Pair = 0b11UL & (i >> (3-n)*2);
            switch(Pair) {
                case 0b00: w |= 0b10001000UL << Shift; break;
                case 0b01: w |= 0b10001100UL << Shift; break;
                case 0b10: w |= 0b11001000UL << Shift; break;
                case 0b11: w |= 0b11001100UL << Shift; break;
            }
            Shift -= 8;
        }

        w = (w << 16) | (w >> 16);

        Printf("0x%08X,", w);
        if(i % 8 == 7) PrintfEOL();
        chThdSleepMilliseconds(4);
    }
#endif
}
