Kreyl/Libs/kl_lib/Sound/cosine.cpp

#include "cosine.h"

#include <cstddef>

static const size_t POINTS = 4096;

static const int16_t cosine_table[POINTS + 1] = {
    32767, 32767, 32767, 32767, 32767, 32767, 32767, 32767,
    32767, 32767, 32767, 32767, 32767, 32767, 32767, 32767,
    32767, 32767, 32767, 32767, 32767, 32767, 32767, 32767,
    32767, 32766, 32766, 32766, 32766, 32766, 32766, 32766,
    32766, 32765, 32765, 32765, 32765, 32765, 32765, 32764,
    32764, 32764, 32764, 32764, 32763, 32763, 32763, 32763,
    32762, 32762, 32762, 32762, 32761, 32761, 32761, 32761,
    32760, 32760, 32760, 32760, 32759, 32759, 32759, 32758,
    32758, 32758, 32758, 32757, 32757, 32757, 32756, 32756,
    32756, 32755, 32755, 32754, 32754, 32754, 32753, 32753,
    32753, 32752, 32752, 32751, 32751, 32751, 32750, 32750,
    32749, 32749, 32748, 32748, 32748, 32747, 32747, 32746,
    32746, 32745, 32745, 32744, 32744, 32743, 32743, 32742,
    32742, 32741, 32741, 32740, 32740, 32739, 32739, 32738,
    32738, 32737, 32737, 32736, 32736, 32735, 32734, 32734,
    32733, 32733, 32732, 32732, 32731, 32730, 32730, 32729,
    32729, 32728, 32727, 32727, 32726, 32725, 32725, 32724,
    32723, 32723, 32722, 32721, 32721, 32720, 32719, 32719,
    32718, 32717, 32717, 32716, 32715, 32715, 32714, 32713,
    32712, 32712, 32711, 32710, 32709, 32709, 32708, 32707,
    32706, 32706, 32705, 32704, 32703, 32702, 32702, 32701,
    32700, 32699, 32698, 32698, 32697, 32696, 32695, 32694,
    32693, 32693, 32692, 32691, 32690, 32689, 32688, 32687,
    32686, 32686, 32685, 32684, 32683, 32682, 32681, 32680,
    32679, 32678, 32677, 32676, 32675, 32675, 32674, 32673,
    32672, 32671, 32670, 32669, 32668, 32667, 32666, 32665,
    32664, 32663, 32662, 32661, 32660, 32659, 32658, 32657,
    32656, 32655, 32654, 32653, 32651, 32650, 32649, 32648,
    32647, 32646, 32645, 32644, 32643, 32642, 32641, 32640,
    32638, 32637, 32636, 32635, 32634, 32633, 32632, 32630,
    32629, 32628, 32627, 32626, 32625, 32623, 32622, 32621,
    32620, 32619, 32618, 32616, 32615, 32614, 32613, 32611,
    32610, 32609, 32608, 32606, 32605, 32604, 32603, 32601,
    32600, 32599, 32598, 32596, 32595, 32594, 32592, 32591,
    32590, 32589, 32587, 32586, 32585, 32583, 32582, 32581,
    32579, 32578, 32577, 32575, 32574, 32572, 32571, 32570,
    32568, 32567, 32566, 32564, 32563, 32561, 32560, 32559,
    32557, 32556, 32554, 32553, 32551, 32550, 32548, 32547,
    32546, 32544, 32543, 32541, 32540, 32538, 32537, 32535,
    32534, 32532, 32531, 32529, 32528, 32526, 32525, 32523,
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
};

int16_t cosineFromZeroToHalfPi(uint16_t numerator, uint16_t denominator)
{
    size_t point = static_cast<size_t>((static_cast<uint32_t>(numerator) * POINTS / denominator) % (POINTS * 4));

    if (point <= POINTS) {
        return cosine_table[point];
    } else if (point <= 2 * POINTS) {
        return -cosine_table[2 * POINTS - point];
    } else if (point <= 3 * POINTS) {
        return -cosine_table[point - 2 * POINTS];
    } else if (point < 4 * POINTS) {
        return cosine_table[4 * POINTS - point];
    }

    // Control never reaches here
    return 0;
}
