Kreyl/Libs/(commit log)

2015-03-27 Power flag made smaller
2015-03-31 Switching to new KiCAD library concept
2015-04-01 Switching to new Concepcia of KiCAD
2015-04-10 + Dip switch x4
2015-04-10 + motor + switch SS 1P2 * resistor footprints renamed
2015-04-12 * Capacitors and inductors renamed + Antenna for locket
2015-04-28 + Capacitors + LEDs + uUSB
2015-05-29 + LEDs
2015-10-18 + DFN14 + VAR R * Var R now has pin numbers
2015-11-14 + STM32F042G4
2015-11-14 + Power: 1V2, 1V2_INT
2015-11-15 + UFQFPN28 for stm32f042G
2015-11-16 * Allwinner A13 + TPS20xxC + 30pi connector
2015-11-18 + connectors 30, 38 pin + DDR3 memory by half
2015-11-19 + STM32L151CCUx, ADS8320 update
2015-11-20 +MSOP8, +STM32L151CCTx
2015-12-15 + LED WS2812
2015-12-15 + USB A PCB
2015-12-24 + Round LCD footprint
2016-01-26 + motor and antennas
2016-02-28 + 1mm5 connectors
2016-09-05 * Color.h bug fixed * float printing bug fixed + components
2016-09-27 * ChunkTypes: StartOrRestart + L476 adc
2016-10-10 + servo, ee, pill, sequences * LED, adc, chunk_types
2016-10-26 + pill + servo * libs & led
2016-11-08 + kl_i2c - i2cL476
2016-11-19 + stm32L476Vx
2017-02-07 + Led lum + F030 i2c
2017-03-25 + QFN48 pitch 0.4
2017-03-30 * LED rewritten, no led.cpp required again * KL Timer rewritten + EXTI irqs now do not require special function * CC1101 allows several instances + Antenna for Candle
2017-04-07 Shell: switch to function templates
2017-04-24 + EvtMsgQ * Uart & shell rewritten
2017-04-25 + Lots of work with embedded flash & ee * ee renamed to ee_i2c * i2c autoselects AF
2017-05-07 * Revolutionary switch to concept of messages and shell
2017-05-14 I2c for L476 updated
2017-05-14 i2c.cpp sanated
2017-06-27 + DMA Transmission complete IRQ added
2017-07-13 + Soldering footprints
2017-08-08 + i2c3
2017-09-05 Switch systick to TIM14
2017-09-18 WS2812: no DMA irq, renamed to IntelLeds
2017-09-24 + Buttons LongCombo * Some buttons sanation
2017-10-04 Fixed stm32f072 TIM7 => TIM17
2017-10-11 * Leg 63 of stm32f072rx connected to GND
2017-11-05 + f200 sys timer update
2018-03-27 * much more 3D KiCAD parts
    [BatteryHolder 1xAA.STEP, Conn_PLS-2.STEP, Conn_PLS-3.STEP, Conn_PLS-6.STEP, Conn_PLS2_7.STEP, MFI.STEP, Speaker D9d5x5.STEP, Switch SS9.STEP]
2018-04-12 * I2C for f030
2018-05-01 + better CC1101
    [Conn_PLS2R.STEP]
2018-05-01 * F205 i2c updated + fs utilc CSV parser
2018-05-12 + UART TXE irq + USB CDC
2018-05-12 * Uart state -> pstate
2018-06-03 Uart changed to non-thread mode
    [BatteryHolder CH7410.STEP, Button 6x6.stp, CAPTH1000-16.stp, CAPTH1000-25.stp, CAPTH220-16.stp, CAPTH220-25.stp, CAPTH220-50.stp, CAPTH2200-25.stp]
2018-07-13 + Led HSV
2018-08-14 * Uart + syscalls with malloc
2018-08-15 Fixed bug with string length
    [kl_fs_utils.cpp]
2018-09-16 kl_fs_utils: ini, csv and json moved to separate files
    [614105150721 (rev1).stp, Conn_WB-06(MW-6M).STEP, ESP32-WROOM-32.step, Switch 1P3T.STEP]
2018-09-30 * SPI * kl_buf
2018-10-23 * L476 Clk switch fixed to switch off SAI when switching
    [CS42L52.cpp, CS42L52.h]
2018-12-12 + Uart485
2019-01-24 + hole 5.1mm
2019-03-14 Minor changes in connectors
2019-04-02 Switch 3dmodels
    [LQFP48_05.STEP, SSOP24_150_0635.STEP]
2020-03-05 + LedWBrt
2020-09-16 Working on Allwinner lib
    [Allwinner.SchLib, BGA15x15.STEP, Capacitors.PcbLib, Capacitors.SchLib, Inductors.SchLib, QFN.PcbLib]
2021-01-18 + 3D
    [DLW21S.STEP, Epistar3535_RGB.STEP, X2QFN12.STEP]
2021-01-18 updated CS42L52 driver; + WAV-decoder from Ilya Tagunov
2021-01-27 + 6-pin USB symbol, MOLEX footprint made 6-pin + Flute antenna
2021-02-14 * Buttons
2021-02-18 + Inputs/Outputs setap in Timer_t; + PrintFreq in Spi_t
2021-02-22 Улучшен алгоритм изменения цвета в парадигме HSV; + микширование цвета в HSV
2021-02-24 Обновлён драйвер CS42L52 (проект Flute_fw)
2021-05-27 обновлена библиотека kl_time (проект HogwartsFlasks)
2021-06-07 Скопирован audiomixer из проета "HogwartsFlasks"
2021-06-18 генерировать событие "PlayEnd", если декодер не может "переварить" файл (экзотичесский формат)
2021-06-26 + Kicad components
    [153BallWFBGA.step, Btn2819.STEP, Ind252012.STEP, IndSRP2010.STEP, POWERPAK 1212-8SWLH.STEP, USBC_10PF-074.STEP]
2021-08-16 Обновлена звуковая подсистема (by Илья Тагунов)
2021-09-05 Скорректирован и отлажен алгоритм смены цвета в порадигме HSV
2021-10-11 Обновён HostUart485_t (из проекта HogwartsFlasks); + Modbus
2021-10-15 Обновлён модуль CRC; добавлена возможность продолжить счёт CRC с заданного значения
2021-10-16 обновлён FwUpdate: добавлена возможность чтения с диска для последующей отправки по UART; добавлены примеры использования
2022-05-25 + host uart
2022-07-02 + F072 ADC
    [WS2812_2020.STEP]
2022-07-26 + ADC for L151 * CC1101 renewed
2022-08-08 + stm32h7b0v
2022-08-28 L151 ADC: * allows periodic measurement and measurement by request * Switches HSI on and off when needed * alllows averaging and medianing of result
2023-01-25 WCH Kicad lib added, it contains ch32v307r
2023-08-04 Sockets added to connectors symbols
2024-01-31 + USBC conn
    [USBC_16PF-076.STEP]
2024-06-06 New concept for IR-transmitting with using analog switch
2024-08-31 lots of minor footprint modifications
    [Btn 3x4.STEP, Conn_PBS3R.STEP, Conn_PLS-4.STEP, tsop4836_R.STEP]
2024-11-09 + connectors
    [B6B-ZR_1d5mm.STEP, KLS1-2.54-02-S.STEP]
2024-11-10 +SY8063, USBC 24PF-014
    [USBC_24PF-014.stp]
2024-11-14 Hole sz decreased to 0.4mm
2024-11-15 + IPhone8 buzzer
    [BuzzerIPhone8.STEP]
2025-03-13 * ADC_L151 battery consts
